anmh1205/AML_MicroMouse_2024/4. Document/20240807 Report Final.pptx

MICROMOUSE 2024

Applied Mechatronics Lab
07/08/2024

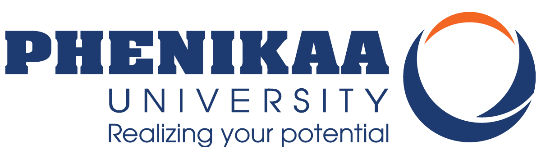
[picture p3: figure]

## Schedule

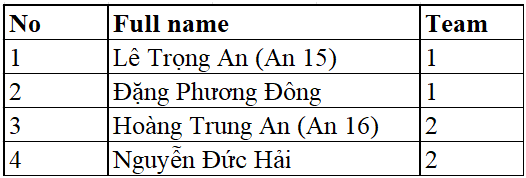
[picture p4: figure]

Notes: Therefore, my presentation includes 6 sections, followed by my research workflow. In Section 1, I present the background, challenges and objectives of my research. Section 2 is for my invented technique which mainly used. Section 3,4, and 5 provides more detail of the properties of three prototypes I have made. And Section 6 is the Conclusion and future work.

## TEAM 1

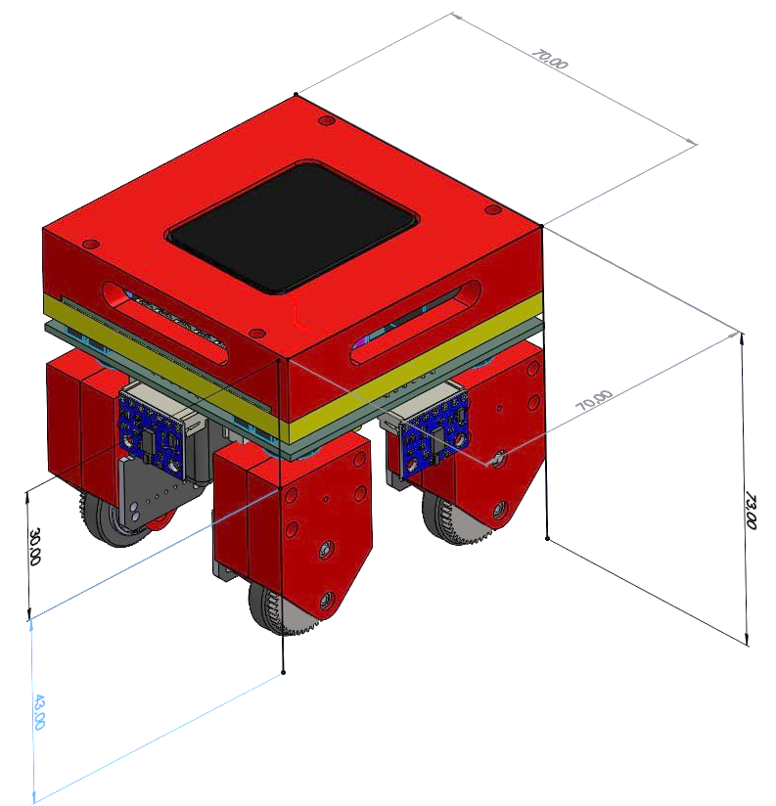
[picture p5: figure]
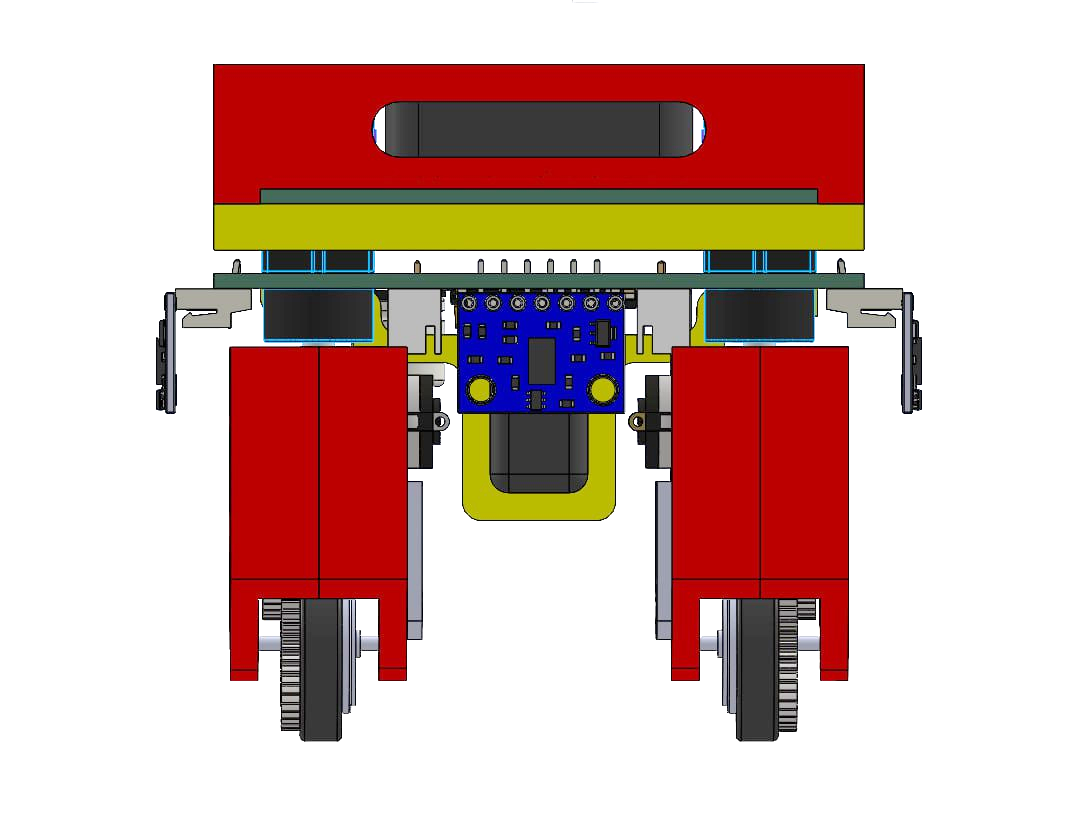
[picture p6: figure]
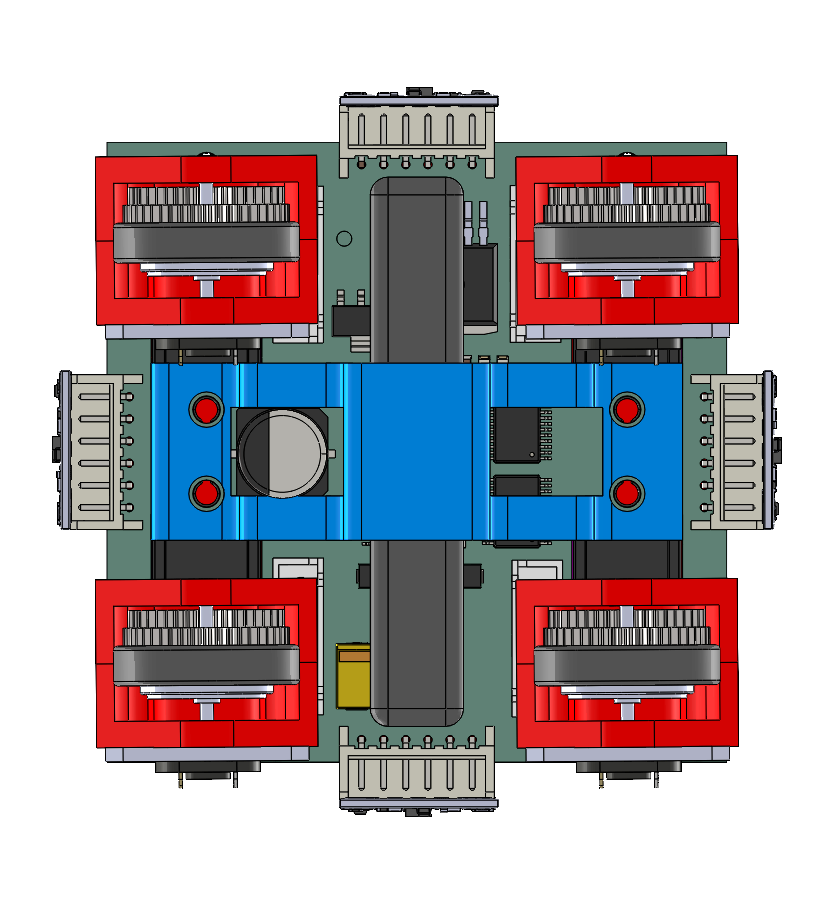
[picture p7: figure]

Notes: Therefore, my presentation includes 6 sections, followed by my research workflow. In Section 1, I present the background, challenges and objectives of my research. Section 2 is for my invented technique which mainly used. Section 3,4, and 5 provides more detail of the properties of three prototypes I have made. And Section 6 is the Conclusion and future work.

## TEAM 1

Màn hình ESP32

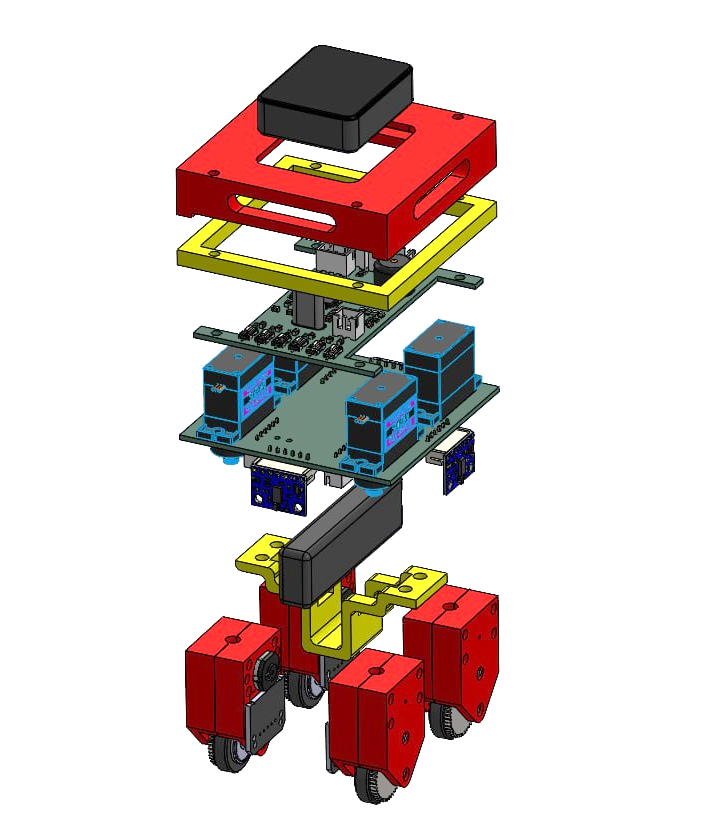
[picture p8: figure]

Case bảo vệ trên

Gá 2 mạch

Servo quay cụm bánh (SG90S) x4

PCB tầng dưới

Cảm biến laser
VL6180X x4

Gá pin

PCB tầng trên

Pin Lipo 2S

Cụm bánh x4

Notes: Therefore, my presentation includes 6 sections, followed by my research workflow. In Section 1, I present the background, challenges and objectives of my research. Section 2 is for my invented technique which mainly used. Section 3,4, and 5 provides more detail of the properties of three prototypes I have made. And Section 6 is the Conclusion and future work.

## TEAM 1

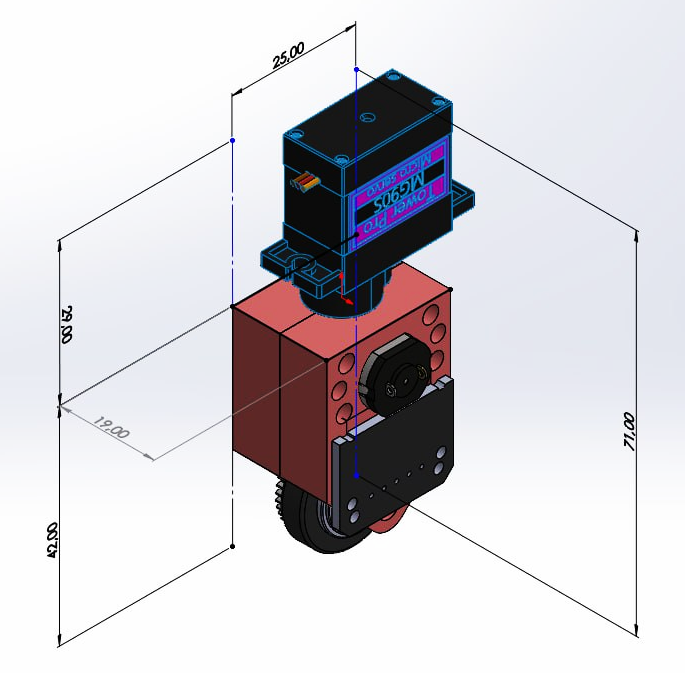
[picture p9: figure]

Notes: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

## TEAM 1

*CỤM BÁNH SỬ DỤNG BÁNH RĂNG 0.4M

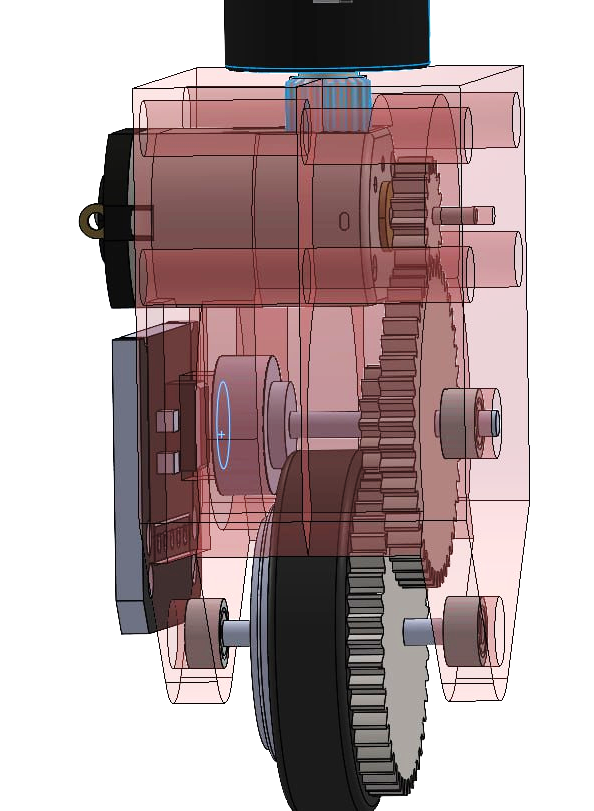
[picture p10: figure]

Bánh răng z1 = 15

Động cơ N20
10x8x15 (mm)
Trục 1mm dài 5mm

Encoder từ MT6701

Bánh răng z2 = 45

Nam châm cho encoder từ

Bánh răng z2’ = 15

Bánh răng z3 = 45

Tỉ số truyền: 1:9

Vòng bi 1.5x4x2 (mm) x3

Notes: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

## TEAM 2

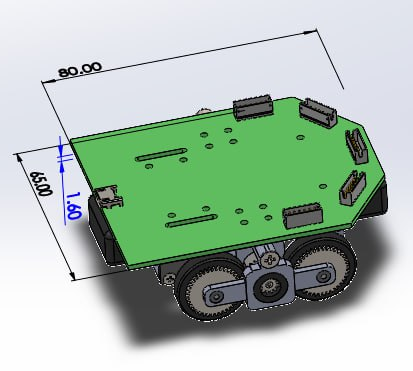
[picture p11: figure]
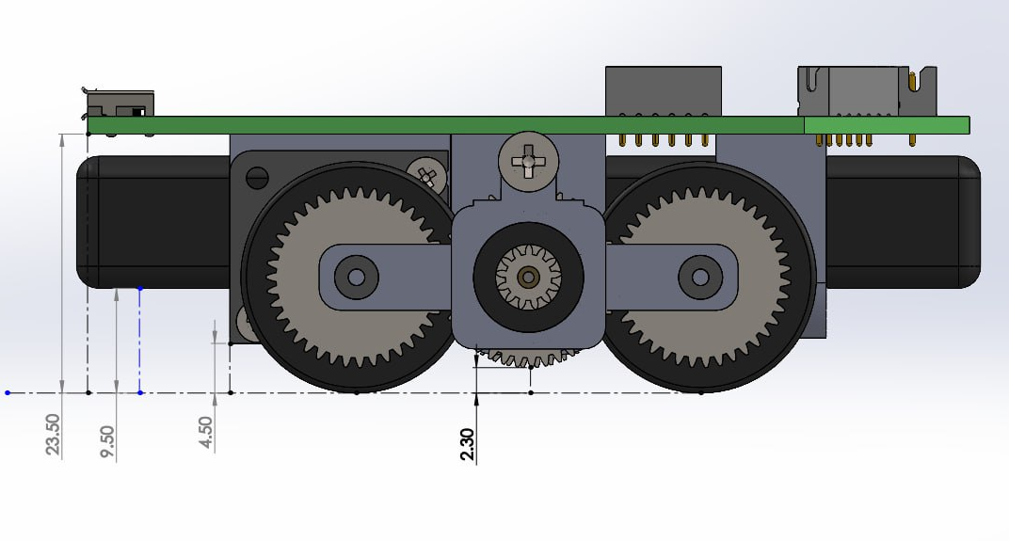
[picture p12: figure]

Notes: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

## TEAM 2

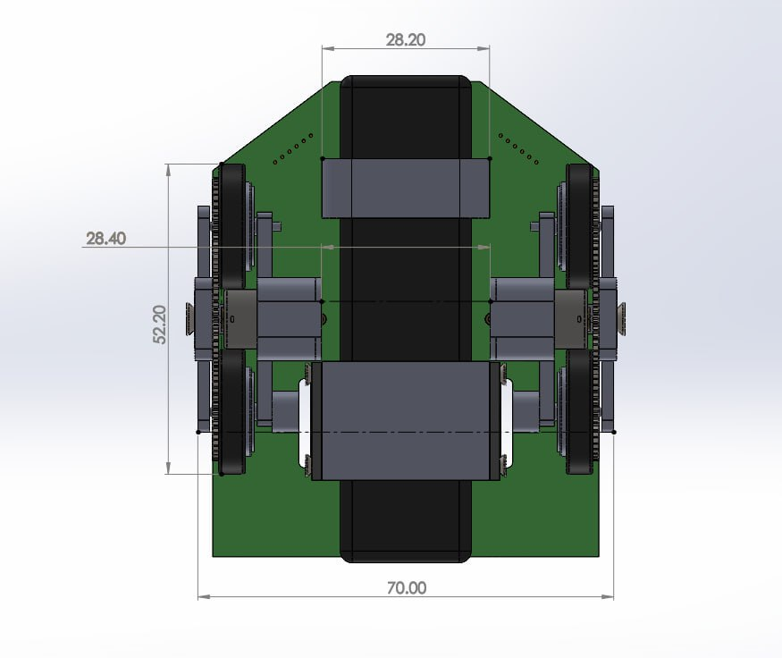
[picture p13: figure]

Notes: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

## TEAM 2

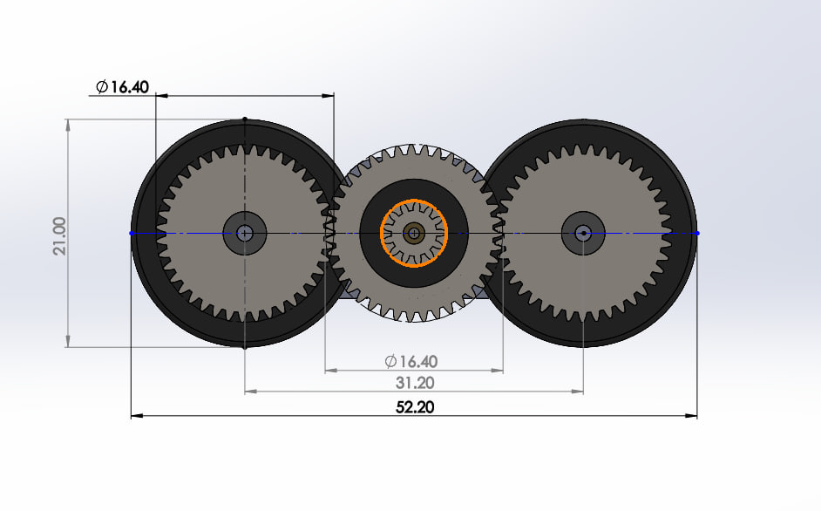
[picture p14: figure]

Notes: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

## TEAM 2

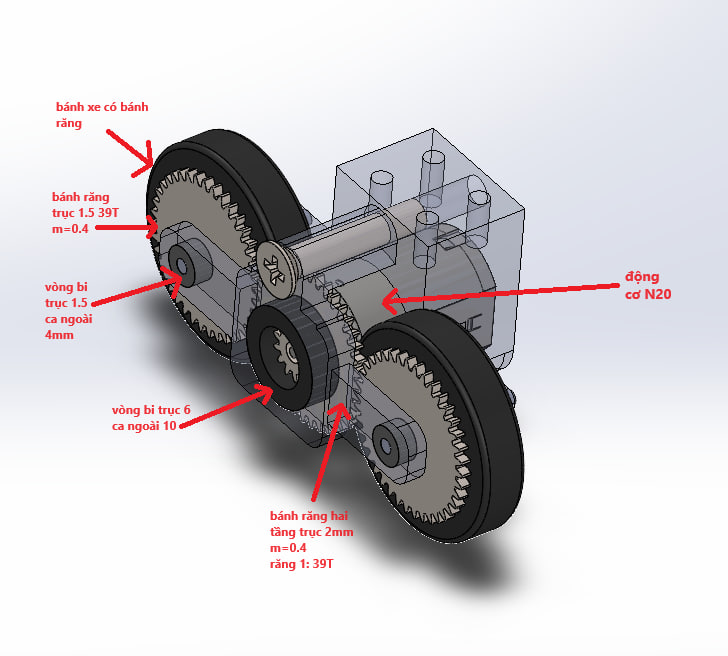
[picture p15: figure]

Notes: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

## Slide 11

THANK YOU

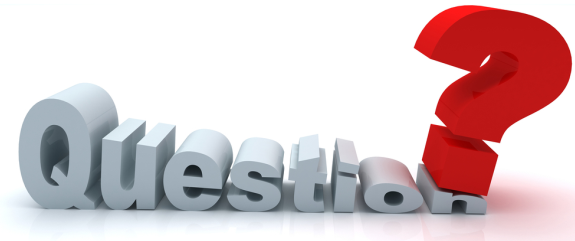
[picture p16: figure]
