anmh1205/AML_MicroMouse_2024/0. Example/3. ST-Link 2.1-2/2D and 3D files/ST-Link V2-1_2.4_Bottom.png

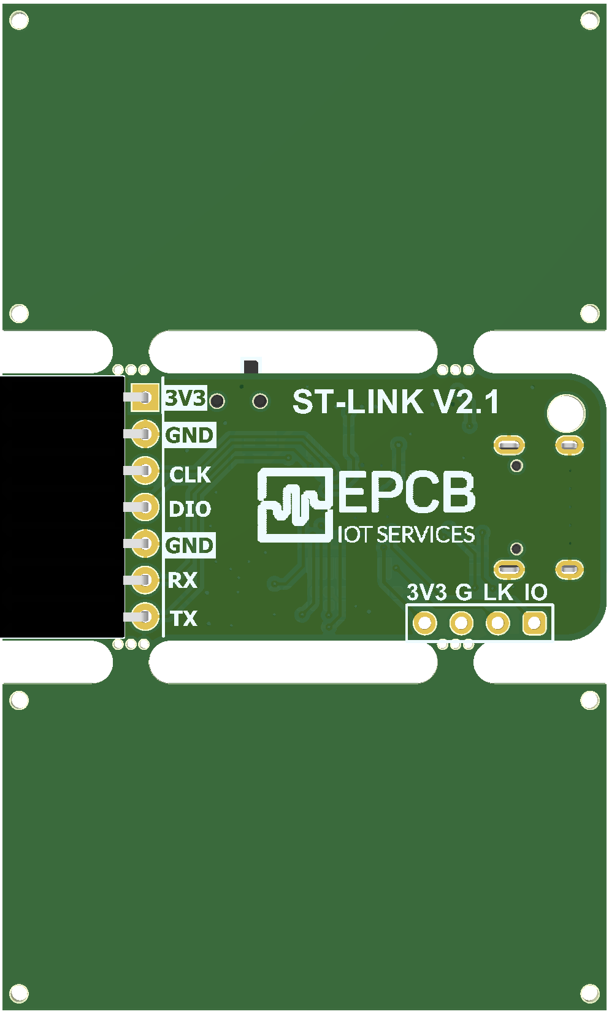
0. Example/3. ST-Link 2.1-2/2D and 3D files/ST-Link V2-1_2.4_Bottom.png
