anmh1205/AML_MicroMouse_2024/2. MicroMouse PCB/PCB_AIO_V2/PCB_AIO_V2_Back.png

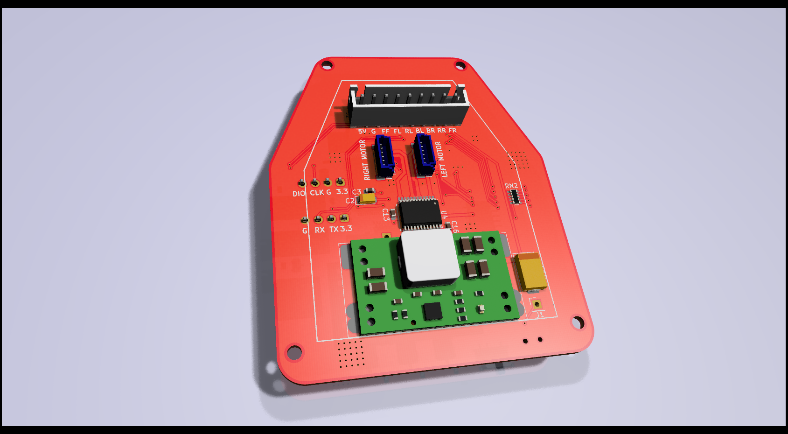
2. MicroMouse PCB/PCB_AIO_V2/PCB_AIO_V2_Back.png
