anmh1205/AML_MicroMouse_2024/0. Example/3. ST-Link 2.1-2/Manufacturing/Bill of Materials-ST-Link V2-1_2.4.xlsx

ST-Link V2-1_2.4.PrjPcb
# | Comment | Designator | Footprint | LCSC Part Number | Manufacturer Part Number | Manufacturer | Quantity | Description | Assembly Type | Link
1 | 4.7uF | C2, C5 | C_0603 | C19666 | CL10A475KO8NNNC | Samsung Electro-Mechanics | 2 | 4.7UF 16V 0603 ROHS | SMT Assembly
2 | 22pF | C6, C13 | C_0402 | C1555 | 0402CG220J500NT | FH(Guangdong Fenghua Advanced Tech) | 2 | 22pF 50V C0G ±5% 0402 Multilayer Ceramic Capacitors MLCC - SMD/SMT ROHS | SMT Assembly
3 | 100nF | C7, C8, C9, C10, C14 | C_0402 | C41851 | 0402B104K160NT | FH(Guangdong Fenghua Advanced Tech) | 5 | 100nF 16V X7R ±10% 0402 Multilayer Ceramic Capacitors MLCC - SMD/SMT ROH | SMT Assembly
4 | FC-DA1608HRK-620D | D1, D2, D3 | LED0603-RD_RED | C84263 | FC-DA1608HRK-620D | NATIONSTAR | 3 | LED Red 0603 Light Emitting Diodes (LED) ROHS | SMT Assembly
5 | BSMD0603L-150 | F1 | F0603 | C914094 | BSMD0603L-150 | BHFUSE | 1 | 6V 1.5A 50A 1W -40℃~+85℃ 3A 5mΩ 500ms 55mΩ 0603 | SMT Assembly
6 | BSMD0603-050-6V | F2 | F0603 | C883095 | BSMD0603-050-6V | BHFUSE | 1 | 6V 500mA 40A 500mW -40℃~+85℃ 1A 100mΩ 100ms 800mΩ 0603 Resettable Fuses ROHS | SMT Assembly
7 | TYPE-C 16PIN 2MD(073) | J2 | USB-C-SMD_TYPE-C-6PIN-2MD-073 | C2765186 | TYPE-C 16PIN 2MD(073) | SHOU HAN(首韩) | 1 | 5A 1 Surface Mount 16 Female -25℃~+85℃ Type-C SMD USB Connectors ROHS | SMT Assembly
8 | HDR1x7 | JP1 | HDR1X7H |  | HDR1x7 Horizonal |  | 1 | Header IDC, 1x8 Pin horizontal 2.54mm Pitch (Non-Boxed, Male) | Hand Soldering
9 | PM254-1-07-W-8.5 | JP2 | HDR-TH_7P-P2.54-H-F-W10.0-N | C2897389 | PM254-1-07-W-8.5 | HCTL(华灿天禄) | 1 | 2.54mm 单排 3A -40℃~+105℃ Shrouded 1x7P side 8.5mm 7 Square Holes Push-Pull,P=2.54mm Female Headers ROHS | Hand Sodering
10 | ME6211C33M5G-N | LDO1 | SOT-23-5_L3.0-W1.7-P0.95-LS2.8-BR | C82942 | ME6211C33M5G-N | MICRONE | 1 | ME6211C33M5G-N 500mA 70dB@(1kHz),62dB@(10kHz) 260mV@(200mA) Fixed 3.3V~3.3V Positive 1 6V SOT-23-5 Linear Voltage Regulators (LDO) ROHS | SMT Assembly
11 | MMBT3904 | Q1 | SOT-23-3_L2.9-W1.3-P1.90-LS2.4-BR | C20526 | MMBT3904 | Changjiang Electronics Tech (CJ) | 1 | MMBT3904 TRANSISTORS (NPN/PNP) NPN 200MA 40V SOT-23(SOT-23-3) ROHS | SMT Assembly
12 | 10K | R1, R7, R8, R9, R10 | R_0402 | C25744 | 0402WGF1002TCE | Uniroyal Elec | 5 | 10kΩ 0402 62.5mW Thick Film Resistors 50V ±100ppm/℃ ±1% -55℃~+155℃ | SMT Assembly
13 | 100R | R2, R14 | R_0402 | C304566, C328297 | RC-02W1000FT, AECR0402F100RK9 | FH (Guangdong Fenghua Advanced Tech), Resistor.Today | 2 | 100Ω 0402 62.5mW ±1% Chip Resistor - Surface Mount ROHS, 100ohm 100Ω 0402 Chip Resistor - Surface Mount ROHS | SMT Assembly
14 | 36K | R3 | R_0402 | C517690 | TC0250B3602TCC | Uniroyal Elec | 1 | 36kΩ 0402 62.5mW Thick Film Resistors 50V ±100ppm/℃ ±1% -55℃~+155℃ | SMT Assembly
15 | 1.5K | R4, R6, R15, R25 | R_0402 | C25867 | 0402WGF1501TCE | Uniroyal Elec | 4 | 1.5kΩ 0402 62.5mW Thick Film Resistors 50V ±100ppm/℃ ±1% -55℃~+155℃ | SMT Assembly
16 | 4.7K | R11, R12, R13 | R_0402 | C25900 | 0402WGF4701TCE | Uniroyal Elec | 3 | 4.7KOHMS ±1% 1/16W 0402 ROHS | SMT Assembly
17 | 5.1k | R23, R24 | R_0402 | C25941 | 0402WGJ0512TCE | Uniroyal Elec | 2 | 5.1KOHMS ±5% 1/16W 0402 ROHS | SMT Assembly
18 | MK-12C02-G020 | S1 | SW-SMD_MK-12C02-G020 | C963206 | MK-12C02-G020 | G-Switch | 1 | Surface Mount 1A SPDT 6V Black 10000次 SMD Slide Switches ROHS | SMT Assembly
19 | STM32F103CBT6 | U1 | LQFP-48_L7.0-W7.0-P0.50-LS9.0-BL | C8304 | STM32F103CBT6 | STMicroelectronics | 1 | STM32 ARM-based 32-bit MCU with 64 Kbytes Flash, 48-pin LQFP, Industrial Temperature | SMT Assembly
20 | 8Mhz | X1 | SMD-3225_4P | C133366 | 1C208000CE0Q | KDS Daishinku | 1 | 8Mhz 3225 SMD CRYSTAL RESONATORS 8MHZ SMD-3225-4P ROHS | SMT Assembly
