anmh1205/AML_MicroMouse_2024/0. Example/WolfieMouse-RTOS/hardware/kicad_wolfiemouse/BOM.xlsx

 | Reference | # | Value | Manufacturer | Manufacturer # | Digi-key part # | Discription | Cost | ext. Cost | Footprint | Datasheet
1 | U1 | 1 | STM32F446RE_LQFP64 | STMicroelectronics | STM32F446RET6 | 497-15376-ND |  | 9.71 | 9.71 | footprints_micromouse:STM32F446_LQFP64
2 | LED_RED1, D_PWR1 | 2 | Led_Small | Vishay Semiconductor Opto Division | VLMS1300-GS08 | VLMS1300-GS08CT-ND |  | 0.43 | 0.86 | LEDs:LED_0603
3 | LED_GREEN1 | 1 | Led_Small | Vishay Semiconductor Opto Division | VLMTG1300-GS08 | VLMTG1300-GS08CT-ND |  | 0.43 | 0.43 | LEDs:LED_0603
4 | LED_BLUE1, D1 | 2 | Led_Small | Vishay Semiconductor Opto Division | VLMB1300-GS08 | VLMB1300-GS08CT-ND |  | 0.43 | 0.86 | LEDs:LED_0603
5 | LED_WHITE1 | 1 | Led_Small | Vishay Semiconductor Opto Division | VLMW1300-GS08 | VLMW1300-GS08CT-ND |  | 0.43 | 0.43 | LEDs:LED_0603
6 | C_IMU2 | 1 | 10nF | Yageo | CC0805KRX7R9BB103 | 311-1136-1-ND | CAP CER 10000PF 50V X7R 0805 | 0.1 | 0.1 | Capacitors_SMD:C_0805
7 | C_VBAT2, C_5V2, CNR1, C_3.3V2, C_RESET1, C_V1, C_V2, C_V3, C_V4, C_V5, C_V6, C_RANGE1, C_DIS1, C_IMU1, C_IMU3 | 15 | 0.1uF | Vishay Vitramon | VJ0603Y104KXXAC | 720-1378-1-ND | CAP CER 0.1UF 25V X7R 0603 | 0.34 | 5.1 | Capacitors_SMD:C_0603
8 | C_MOTOR1, C_MOTOR2 | 2 | 1uF | Yageo | CC0603KRX5R8BB105 | 311-1445-1-ND | CAP CER 1UF 25V X5R 0603 | 0.1 | 0.2 | Capacitors_SMD:C_0603
9 | C_VCAP1, C_VCAP2 | 2 | 2.2uF | Yageo | CC1206KKX7R7BB225 | 311-1957-1-ND | CAP CER 2.2UF 16V X7R 1206 | 0.21 | 0.42 | Capacitors_SMD:C_1206
10 | C_3.3V1, C_DIS2, C_uSD1 | 3 | 10uF | Yageo | CC1206ZKY5V7BB106 | 311-1376-1-ND | CAP CER 10UF 16V Y5V 1206 | 0.22 | 0.66 | Capacitors_SMD:C_1206
11 | C_VBAT1, C_5V1 | 2 | 100uF | Yageo | CC1210MKX5R7BB107 | 311-2052-1-ND | CAP CER 100UF 16V X5R 1210 | 1.92 | 3.84 | Capacitors_SMD:C_1210
12 | C_M1 | 1 | 220uF | Vishay Sprague | TR3D227K010C0150 | 718-1777-1-ND | CAP TANT 220UF 10V 10% 2917 | 1.31 | 1.31 | Capacitors_Tantalum_SMD:TantalC_SizeD_EIA-7343_HandSoldering
13 | R13, R14 | 2 | 62.5m | Vishay Dale | WSL1206R0600FEA | WSLC-.06CT-ND | RES SMD 0.06 OHM 1% 1/4W 1206 | 0.92 | 1.84 | Resistors_SMD:R_0603
14 | R1, R2, R3, R4, R_PWR1, R_uSD1 | 6 | 1k | Vishay Dale | CRCW06031K00FKEA | 541-1.00KHCT-ND | RES SMD 1K OHM 1% 1/10W 0603 | 0.081 | 0.486 | Resistors_SMD:R_0603
15 | R_BOOT1, R_VOL2, R_MOTOR1, R_MOTOR2, R_RANGE1, R_RANGE2, R_RANGE3, R_RANGE4, R_RANGE5, R_RANGE6, R_RANGE7, R_IMU1, R_IMU2 | 13 | 10k | Vishay Dale | CRCW060310K0FKEA | 541-10.0KHCT-ND | RES SMD 10K OHM 1% 1/10W 0603 | 0.081 | 1.053 | Resistors_SMD:R_0603
16 | R_VOL1 | 1 | 20k | Vishay Dale | CRCW060320K0JNEA | 541-20KGCT-ND | RES SMD 20K OHM 5% 1/10W 0603 | 0.1 | 0.1 | Resistors_SMD:R_0603
17 | R_PB2, R_PB1 | 2 | 47k | Vishay Dale | CRCW060347K0JNEA | 541-47KGCT-ND | RES SMD 47K OHM 5% 1/10W 0603 | 0.1 | 0.2 | Resistors_SMD:R_0603
18 | L_BEAD1 | 1 | 10uH | Murata Electronics North America | BLM18KG601SN1D | 490-5258-1-ND | FERRITE BEAD 600 OHM 0603 1LN | 0.1 | 0.1 | Resistors_SMD:R_0603
19 | M3 | 1 | 2.54MM-SLIDE-SWITCH_TS02_SWITCH |  |  |  |  |  | 0 | pcb1:2.54MM-SLIDE-SWITCH_TS02_SWITCH
20 | U11 | 1 | TPS76850 | Texas Instruments | TPS76850QD | 296-2751-5-ND | IC REG LDO 5V 1A 8SOIC | 2.98 | 2.98 | footprints_micromouse:TPS76850_SOIC-8
21 | U12 | 1 | TPS73633 | Texas Instruments | TPS73633DBVR | 296-27064-1-ND | IC REG LDO 3.3V 0.4A SOT23-5 | 2.05 | 2.05 | footprints_micromouse:TPS73633_SOT-23
22 | SW1, SW2, SW3 | 3 | SWITCH_DPST | C&K Components | PTS645SL50SMTR92 LFS | CKN9088CT-ND | SWITCH TACTILE SPST-NO 0.05A 12V | 0.29 | 0.87 | Buttons_Switches_SMD:SW_SPST_PTS645
23 | CN1, CN2 | 2 | 5_PIN_HEADER |  |  |  |  |  | 0 | Pin_Headers:Pin_Header_Straight_1x05
24 | P1, P2 | 2 | B3B-PH-SM4-TB | JST Sales America Inc. | B3B-PH-K-S(LF)(SN) | 455-1705-ND | CONN HEADER PH TOP 3POS 2MM | 0.19 | 0.38 | footprints_micromouse:JST_B3B-PH_HEADER
25 | U2, U3 | 2 | MAX14871 | Maxim Integrated | MAX14871EUE+T | MAX14871EUE+CT-ND | IC MOTOR DVR DC FULL BR 16TSSOP | 4.03 | 8.06 | footprints_micromouse:TSSOP-16_EP
26 | M1 | 1 | MOTOR_MOUNTS_AND_ENCODERS |  |  |  |  |  | 0 | footprints_micromouse:FUTURA-1.0-MOTOR-MOUNT-TEMPLATE
27 | U5, U6, U7, U8 | 4 | VL6180X_POLOLU |  |  |  |  |  | 0 | footprints_micromouse:VL6180X_POLOLU_Pin_Header_Straight_1x07
28 | U4 | 1 | TCA9545A | Texas Instruments | TCA9545APWR | 296-40577-1-ND | IC I2C SW 4CH W/RESET 20TSSOP |  | 0 | Housings_SSOP:TSSOP-20_4.4x6.5mm_Pitch0.65mm
29 | U9 | 1 | HCMS-2901 | Avago (Broadcom company) | HCMS-2901 | 516-2964-ND | LED DISPLAY 5X7 4CHAR 3.8MM YLW | 22.92 | 22.92 | footprints_micromouse:HCMS-2903
30 | U10 | 1 | MPU-9250 | InvenSense | MPU-9250 | 1428-1019-1-ND | GYRO/ACCEL/COMPASS/9-AXIS | 10.64 | 10.64 | footprints_micromouse:MPU-9250
31 | J1 | 1 | uSD_SLOT_47219-2001 | Molex, LLC | 5009010801 | WM19081CT-ND | CONN MICRO SD CARD HINGED TYPE |  | 0 | footprints_micromouse:uSD_MOLEX_47219-2001
 |  |  |  |  |  |  |  |  | 75.599
