anmh1205/AML_MicroMouse_2024/3. Drawing/Ver3_07082024/Cum banh _V3.SLDASM

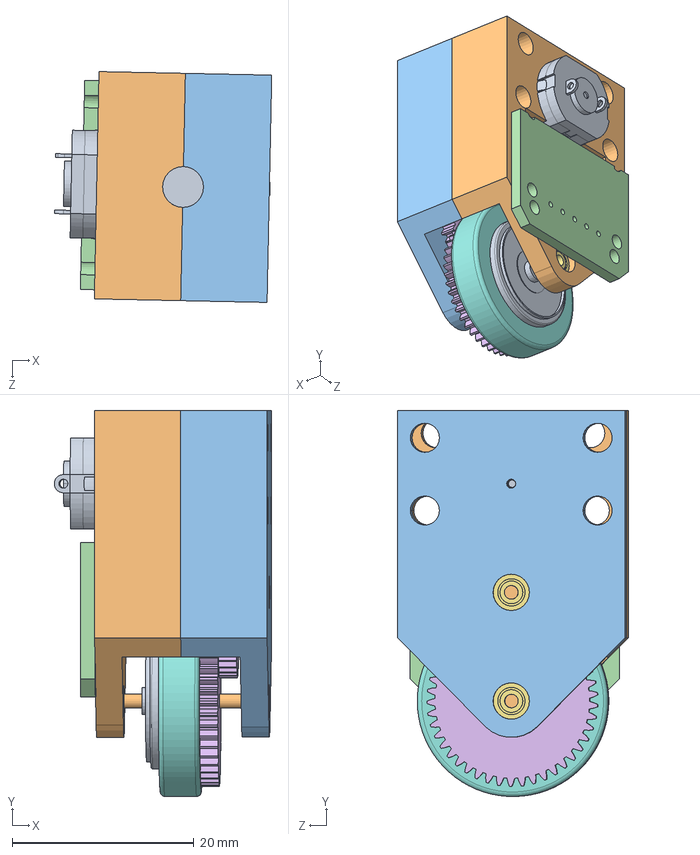
[picture p33: CAD file, 2024-08-10]
3. Drawing/Ver3_07082024/Cum banh _V3.SLDASM
23.9 x 42.4 x 25.4 mm
N20 DC MOTOR Truc dai
Vo SD2_V3
Nam cham
Spur gear 0.4M 15T 1.0N
Spur gear 0.4M 15T 1.5N
Spur gear 0.4M 45T 1.5N x 2
Vong bi 2x5x2.5 x 3
Lop banh xe
Mam banh xe
Truc 2x20 x 2
Vo SD1_V3
MT6701
Ga nam chamV3
