anmh1205/AML_MicroMouse_2024/3. Drawing/Ver3_07082024/Banh rang T45-T15.SLDASM

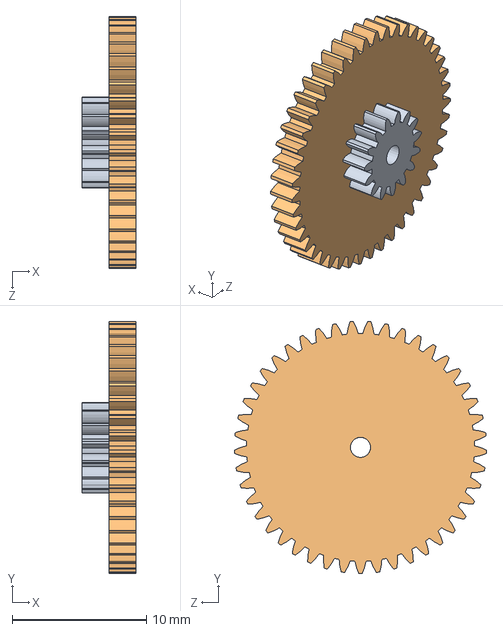
[picture p34: CAD file, 2024-08-10]
3. Drawing/Ver3_07082024/Banh rang T45-T15.SLDASM
4.00 x 18.8 x 18.8 mm
Spur gear 0.4M 15T 1.5N
Spur gear 0.4M 45T 1.5N
