anmh1205/AML_MicroMouse_2024/3. Drawing/v8/Assem1.SLDASM

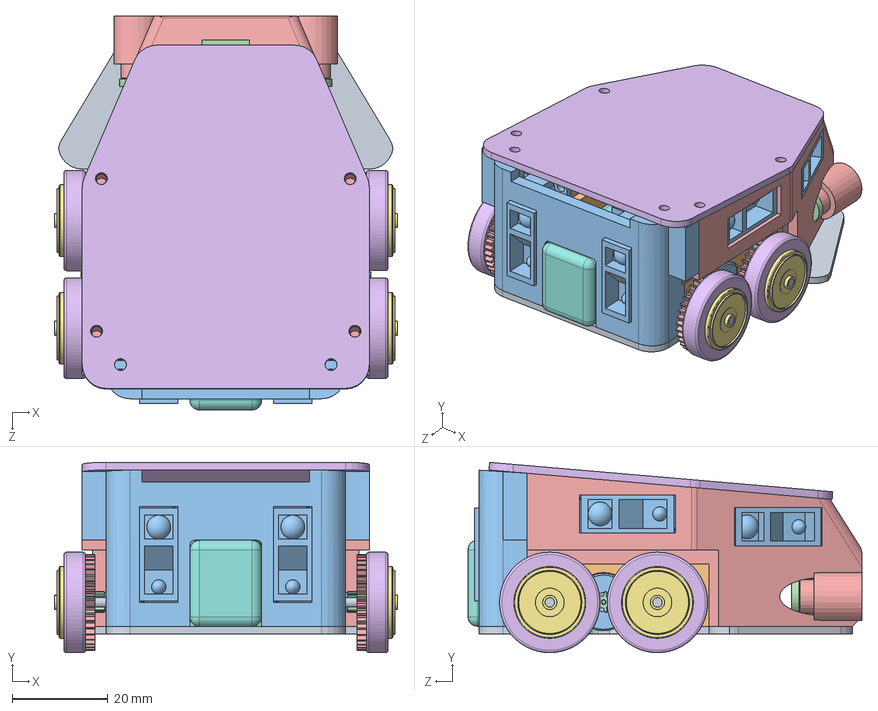
[picture p35: CAD file, 2024-11-05]
3. Drawing/v8/Assem1.SLDASM
71.7 x 39.8 x 82.3 mm
PCB
Ga DC2
N20 DC MOTOR Truc dai x 2
gearT7 x 2
Spur gear 0.5M 38T x 4
Lop banh xe x 4
Mam banh xe x 4
Pin
Truc 2x20 x 4
MT6701 x 2
SHARP GP2Y0A51SK0F x 6
GP2Y0A41SK0F
Ga sensor 1
PCB2
Vong bi 2x5x2.5 x 8
Ga nam chamV3 x 2
Nam cham x 2
Ga DC
Ga sensor sau
Kep truc x 2
