anmh1205/AML_MicroMouse_2024/3. Drawing/Micromouse/Cum Banh.SLDASM

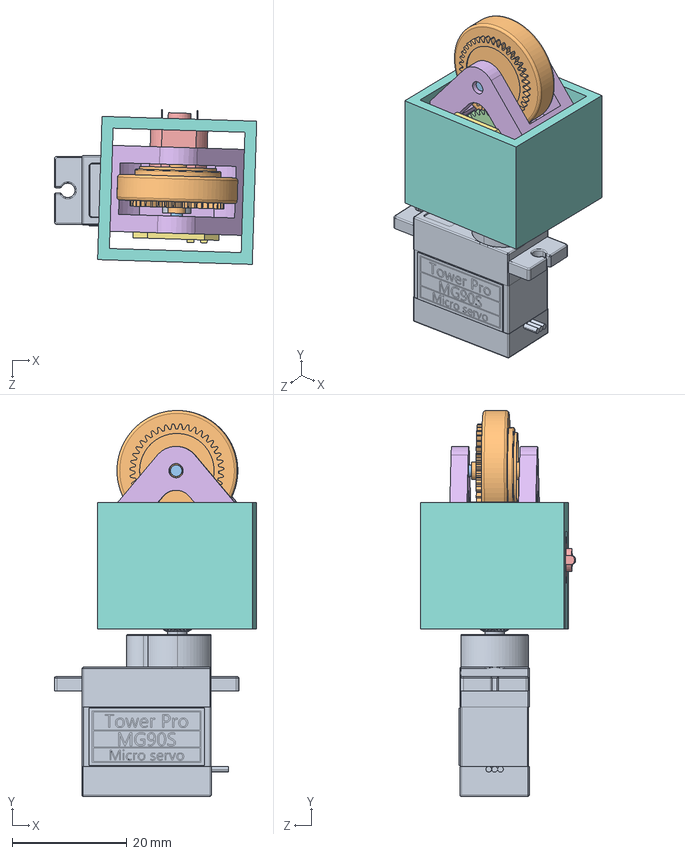
[picture p36: CAD file, 2024-08-10]
3. Drawing/Micromouse/Cum Banh.SLDASM
35.3 x 67.3 x 27.0 mm
Tower Pro MG90S Micro servo.step
Banh xe
Truc 2x14
Banh rang doi
Dong co
Ga cum banh
Encoder
Nam cham
