anmh1205/AML_MicroMouse_2024/0. Example/piccola-master/DXF/base1.SLDPRT

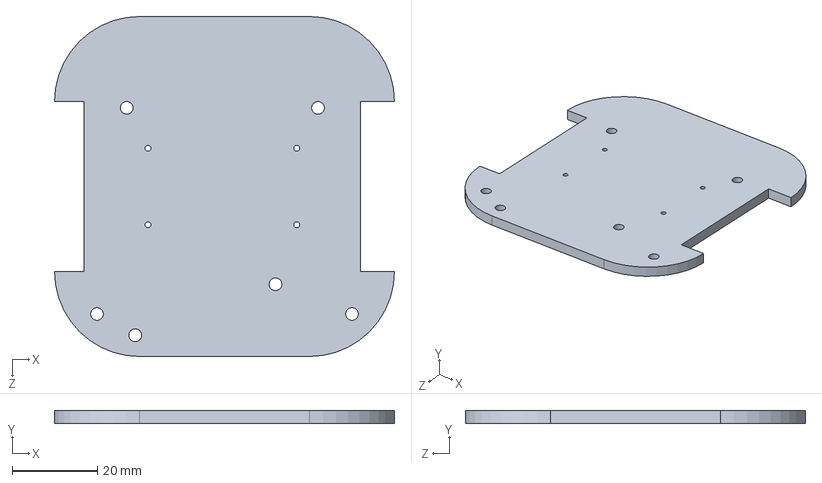
[picture p37: CAD file, 2024-08-29]
0. Example/piccola-master/DXF/base1.SLDPRT
80.0 x 3.00 x 80.0 mm
