anmh1205/AML_MicroMouse_2024/0. Example/WolfieMouse-RTOS/hardware/kicad_wolfiemouse/3D_Model/motor seat.STL

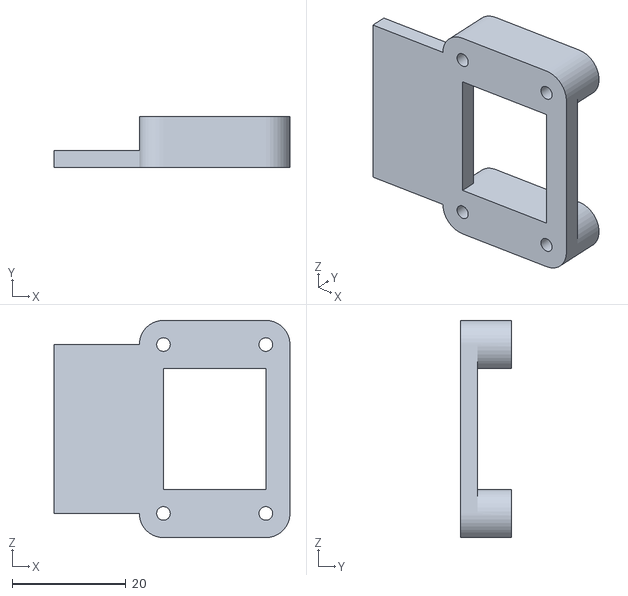
[picture p38: CAD file, 2024-08-10]
0. Example/WolfieMouse-RTOS/hardware/kicad_wolfiemouse/3D_Model/motor seat.STL
41.5 x 9.00 x 38.2
