anmh1205/AML_MicroMouse_2024/2. MicroMouse PCB/Outline/MicroMouse2023_T1.DXF

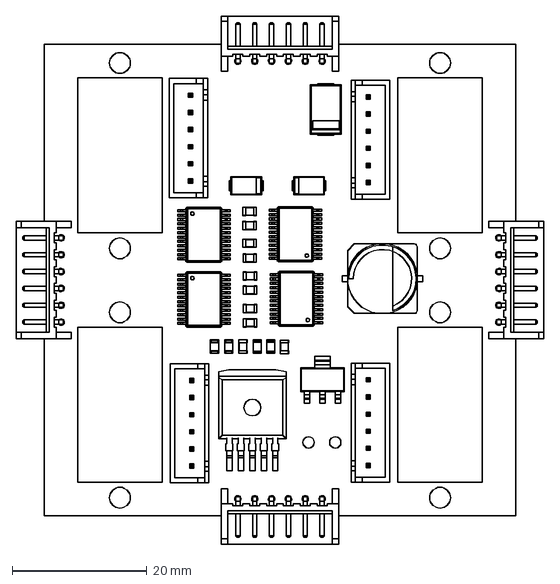
[picture p39: CAD file, 2024-08-10]
2. MicroMouse PCB/Outline/MicroMouse2023_T1.DXF
78.3 x 78.3 mm
