anmh1205/AML_MicroMouse_2024/2. MicroMouse PCB/PCB_AIO_V2/3D Model/BM06B-SRSS-TB.STEP

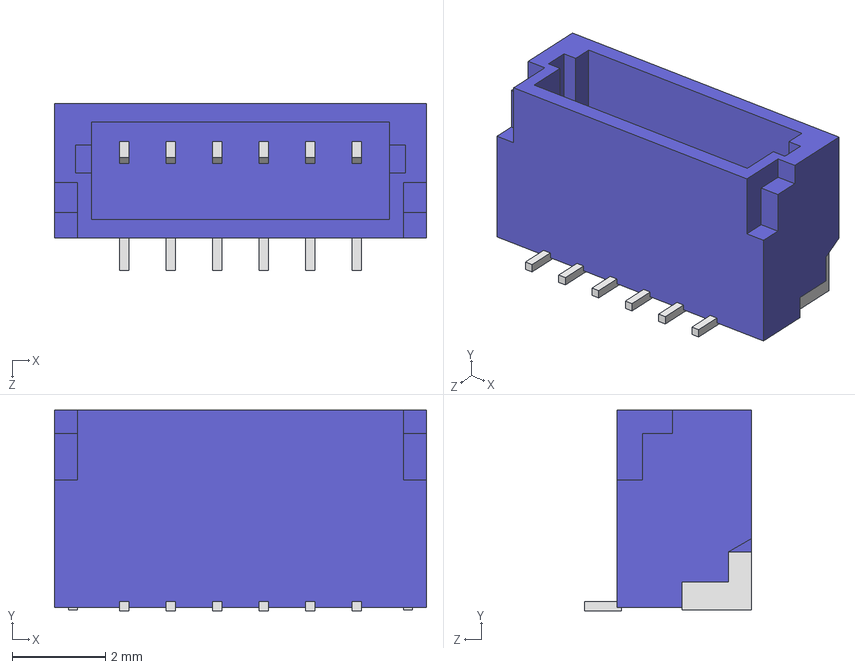
[picture p40: CAD file, 2024-11-05]
2. MicroMouse PCB/PCB_AIO_V2/3D Model/BM06B-SRSS-TB.STEP
8.00 x 4.32 x 3.60 mm
