anmh1205/AML_MicroMouse_2024/2. MicroMouse PCB/PCB_AIO_V2/Outline/PCB_Outline.DXF

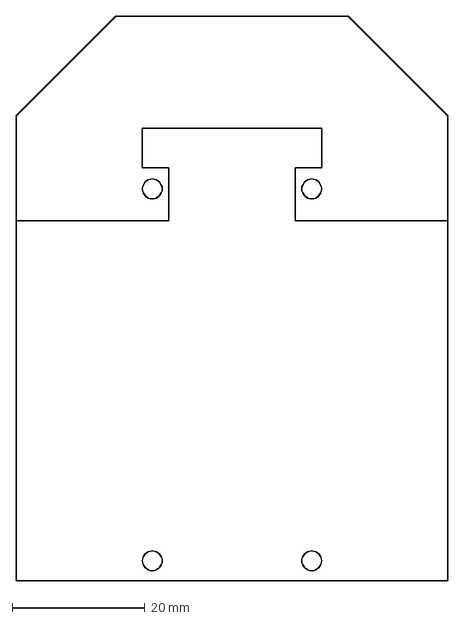
[picture p41: CAD file, 2024-11-05]
2. MicroMouse PCB/PCB_AIO_V2/Outline/PCB_Outline.DXF
65.0 x 85.0 mm
