anmh1205/AML_MicroMouse_2024/2. MicroMouse PCB/V1/PCB_T2/Outline/PCB T1.2.DXF

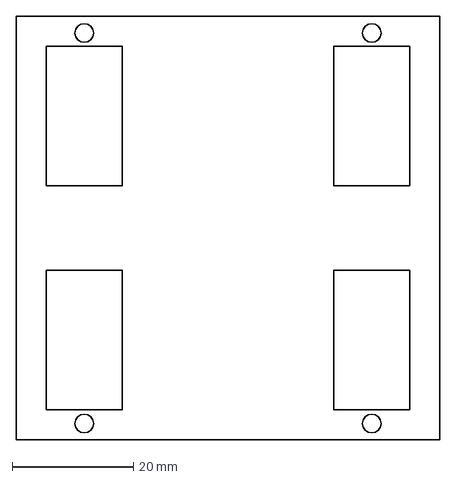
[picture p42: CAD file, 2024-08-10]
2. MicroMouse PCB/V1/PCB_T2/Outline/PCB T1.2.DXF
70.0 x 70.0 mm
