anmh1205/AML_MicroMouse_2024/3. Drawing/Micromouse/Bánh răng/Banh rang doi.SLDPRT

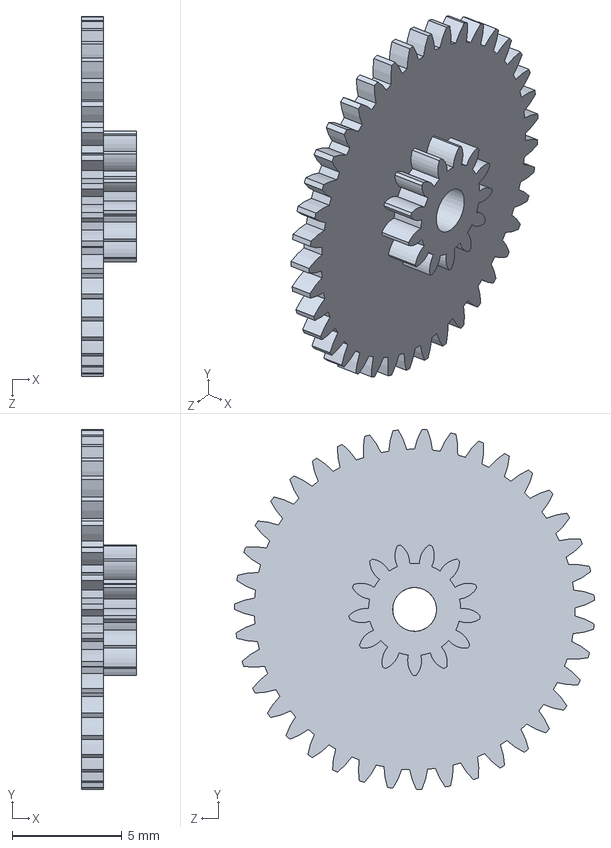
[picture p43: CAD file, 2024-08-10]
3. Drawing/Micromouse/Bánh răng/Banh rang doi.SLDPRT
2.50 x 16.4 x 16.4 mm
