anmh1205/AML_MicroMouse_2024/3. Drawing/Micromouse/Bánh xe/Banh xe.SLDPRT

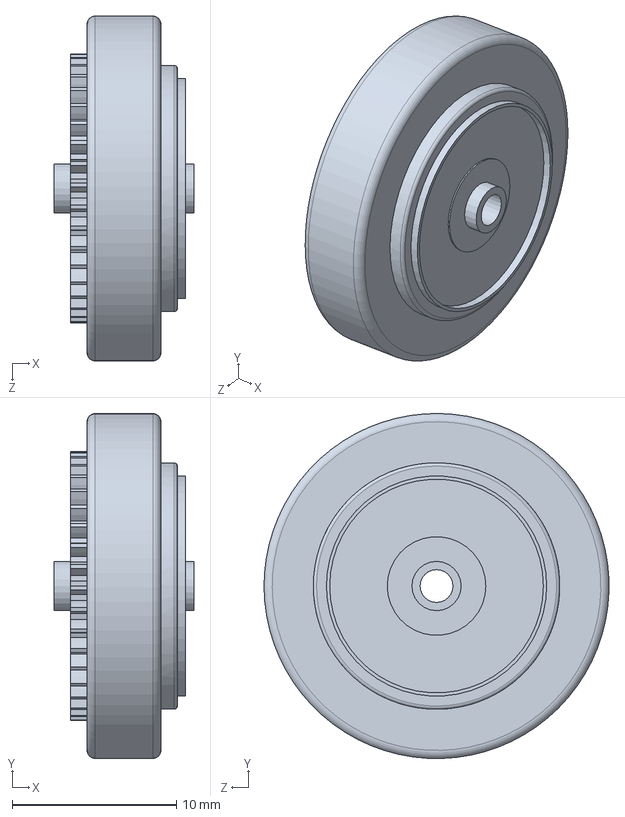
[picture p44: CAD file, 2024-08-10]
3. Drawing/Micromouse/Bánh xe/Banh xe.SLDPRT
8.50 x 21.0 x 21.0 mm
