anmh1205/AML_MicroMouse_2024/3. Drawing/Micromouse/Dong co.SLDPRT

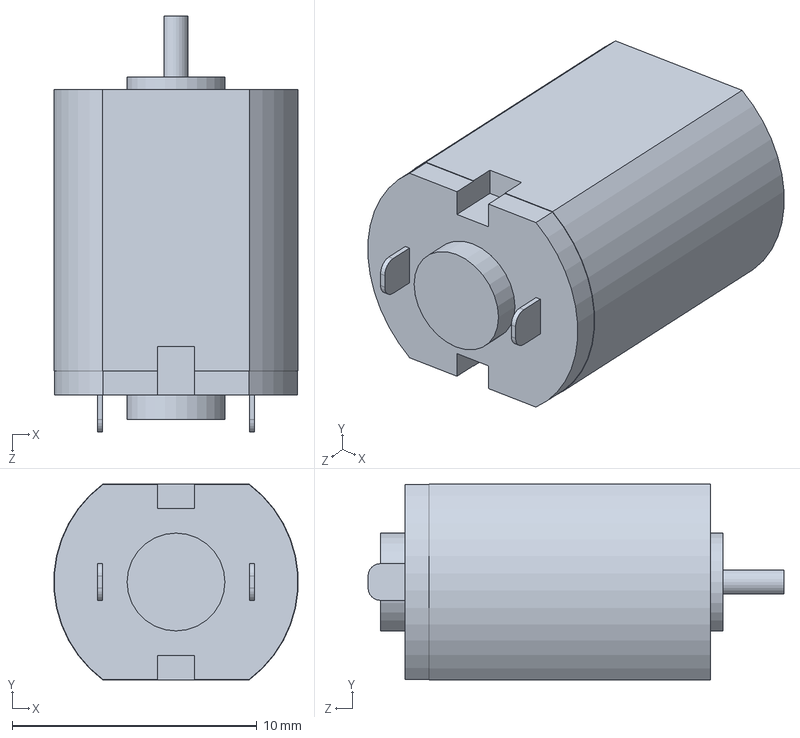
[picture p45: CAD file, 2024-08-10]
3. Drawing/Micromouse/Dong co.SLDPRT
9.97 x 8.00 x 17.0 mm
