anmh1205/AML_MicroMouse_2024/3. Drawing/v8/Ga sensor sau.SLDPRT

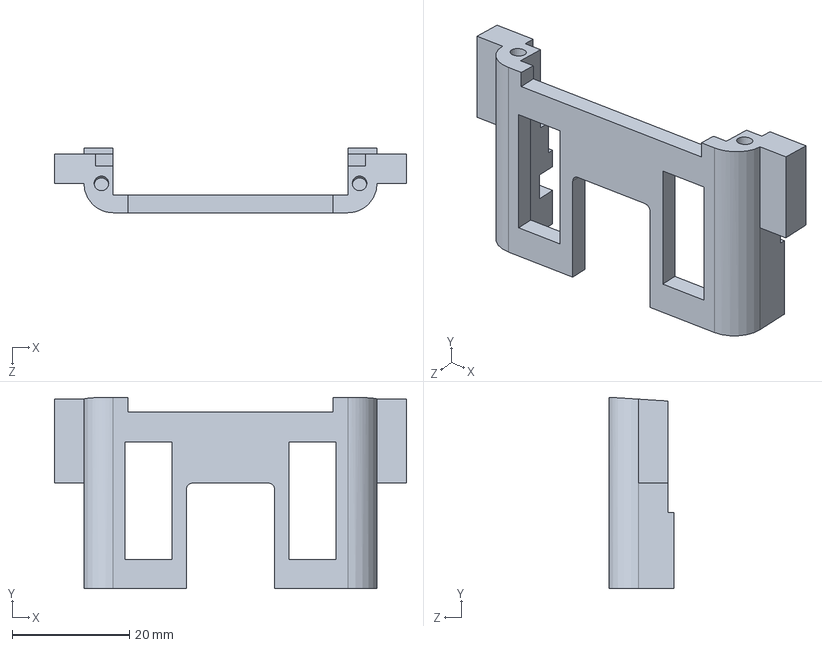
[picture p46: CAD file, 2024-11-05]
3. Drawing/v8/Ga sensor sau.SLDPRT
60.0 x 32.6 x 11.0 mm
