anmh1205/AML_MicroMouse_2024/3. Drawing/Ver3_07082024/Spur gear 0.4M 45T 1.5N.SLDPRT

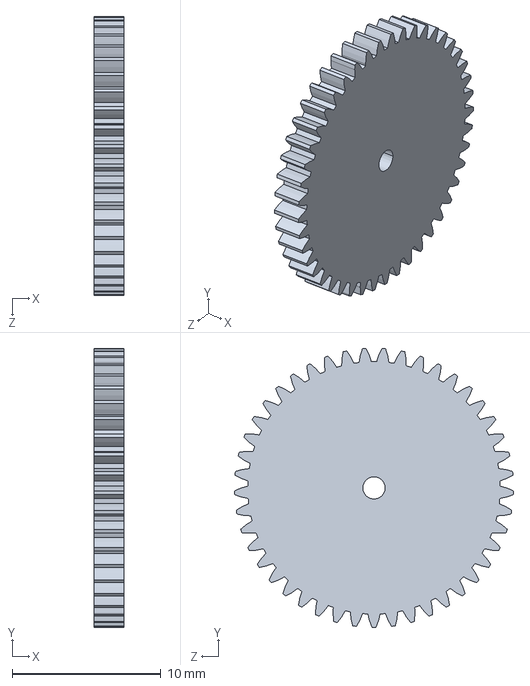
[picture p47: CAD file, 2024-08-10]
3. Drawing/Ver3_07082024/Spur gear 0.4M 45T 1.5N.SLDPRT
2.00 x 18.8 x 18.8 mm
