anmh1205/AML_MicroMouse_2024/0. Example/piccola-master/DXF/base3.SLDPRT

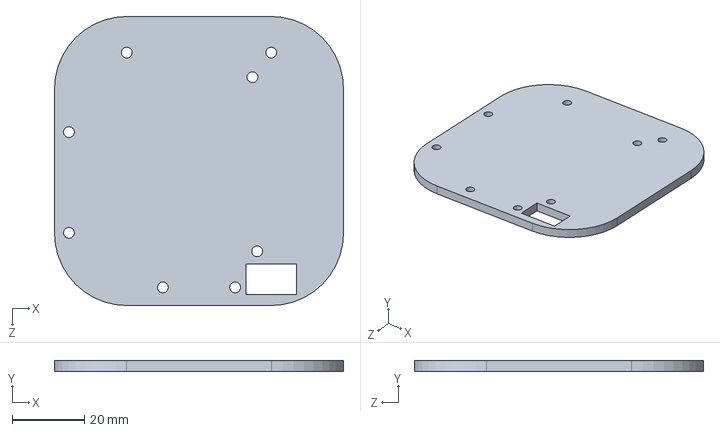
[picture p48: CAD file, 2024-08-29]
0. Example/piccola-master/DXF/base3.SLDPRT
80.0 x 3.00 x 80.0 mm
