anmh1205/AML_MicroMouse_2024/0. Example/WolfieMouse-RTOS/hardware/kicad_wolfiemouse/3D_Model/wheel.STL

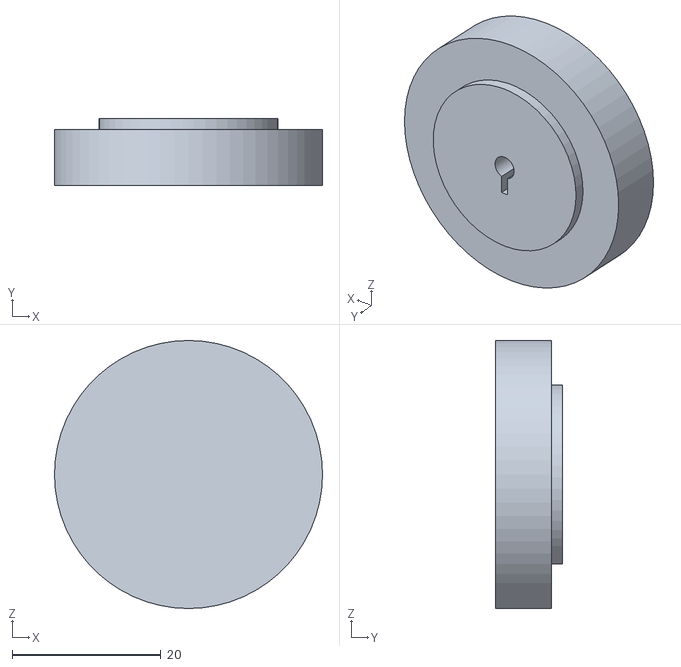
[picture p49: CAD file, 2024-08-10]
0. Example/WolfieMouse-RTOS/hardware/kicad_wolfiemouse/3D_Model/wheel.STL
36.0 x 9.00 x 36.0
