anmh1205/AML_MicroMouse_2024/2. MicroMouse PCB/Outline/MicroMouse2023_T2.DXF

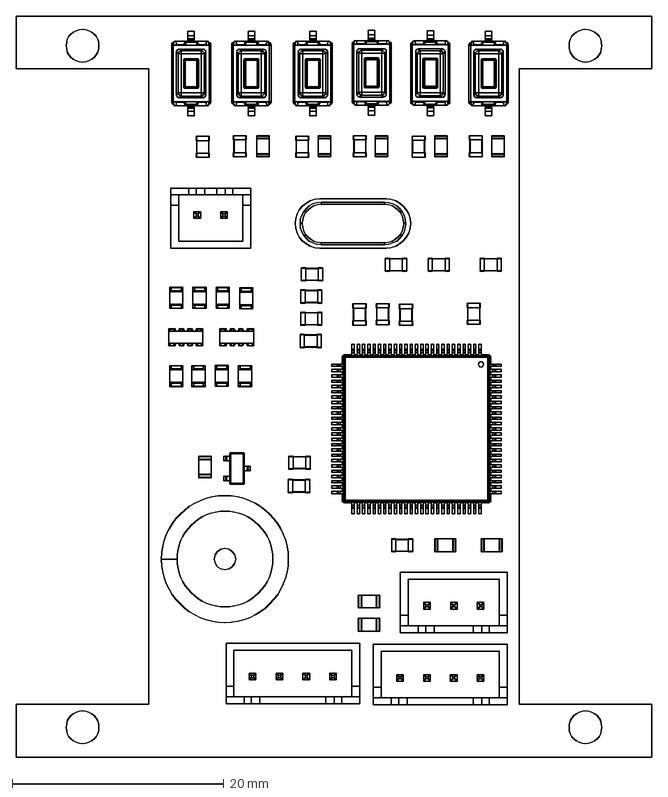
[picture p50: CAD file, 2024-08-10]
2. MicroMouse PCB/Outline/MicroMouse2023_T2.DXF
60.0 x 70.0 mm
