anmh1205/AML_MicroMouse_2024/2. MicroMouse PCB/PCB_AIO_V2/3D Model/JST - XH - Thru (V) - 9Pin - 2.54mm.stp

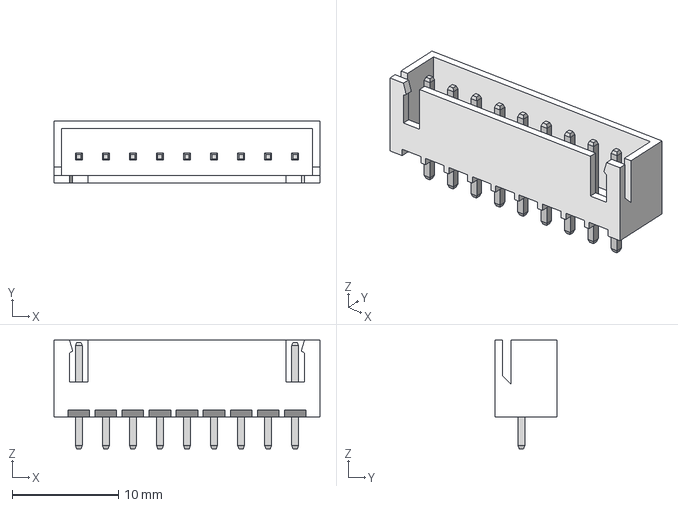
[picture p51: CAD file, 2024-11-05]
2. MicroMouse PCB/PCB_AIO_V2/3D Model/JST - XH - Thru (V) - 9Pin - 2.54mm.stp
25.0 x 5.84 x 10.2 mm
