anmh1205/AML_MicroMouse_2024/3. Drawing/Micromouse/Bánh răng/Banh rang 0.4M 13T 20PA 1.5FW.SLDPRT

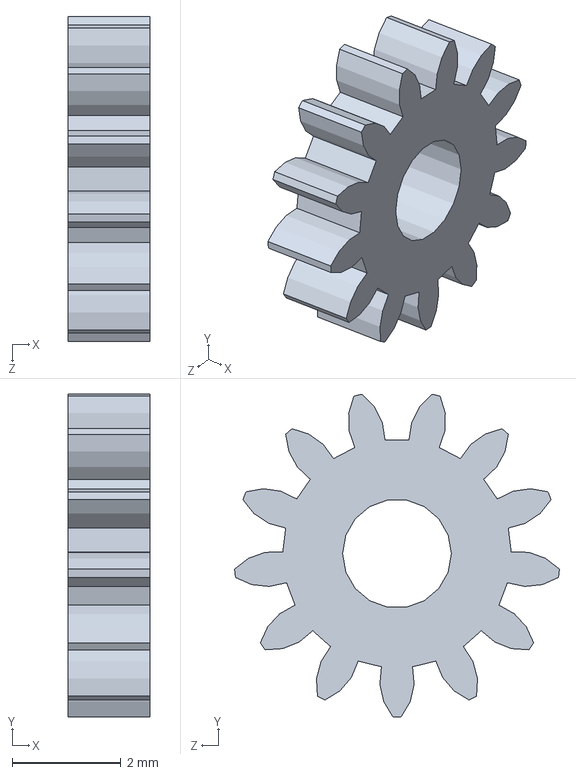
[picture p53: CAD file, 2024-08-10]
3. Drawing/Micromouse/Bánh răng/Banh rang 0.4M 13T 20PA 1.5FW.SLDPRT
1.50 x 5.93 x 5.97 mm
