anmh1205/AML_MicroMouse_2024/3. Drawing/Micromouse/Bánh xe/Truc 2x14.SLDPRT

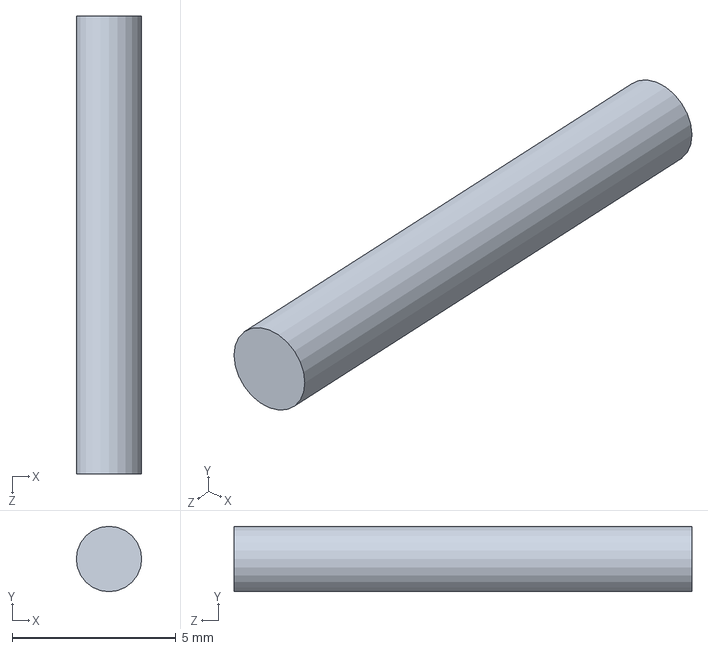
[picture p54: CAD file, 2024-08-10]
3. Drawing/Micromouse/Bánh xe/Truc 2x14.SLDPRT
2.00 x 2.00 x 14.0 mm
