anmh1205/AML_MicroMouse_2024/3. Drawing/Micromouse/Nam cham.SLDPRT

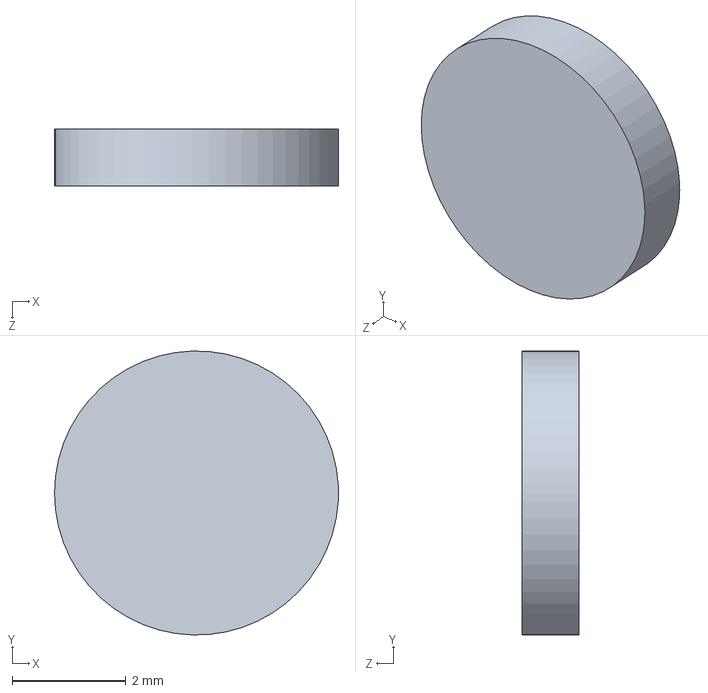
[picture p55: CAD file, 2024-08-10]
3. Drawing/Micromouse/Nam cham.SLDPRT
5.00 x 5.00 x 1.00 mm
