anmh1205/AML_MicroMouse_2024/3. Drawing/v8/PCB.SLDPRT

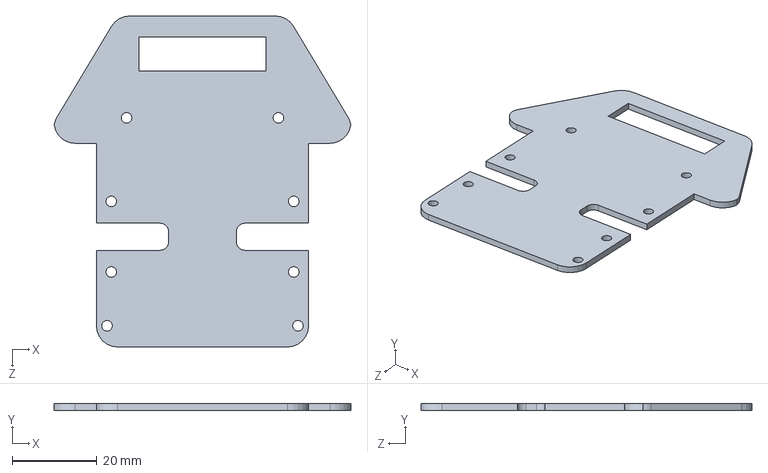
[picture p56: CAD file, 2024-11-05]
3. Drawing/v8/PCB.SLDPRT
69.9 x 1.60 x 78.0 mm
