anmh1205/AML_MicroMouse_2024/0. Example/WolfieMouse-RTOS/hardware/kicad_wolfiemouse/3D_Model/Sensor_Housing.STL

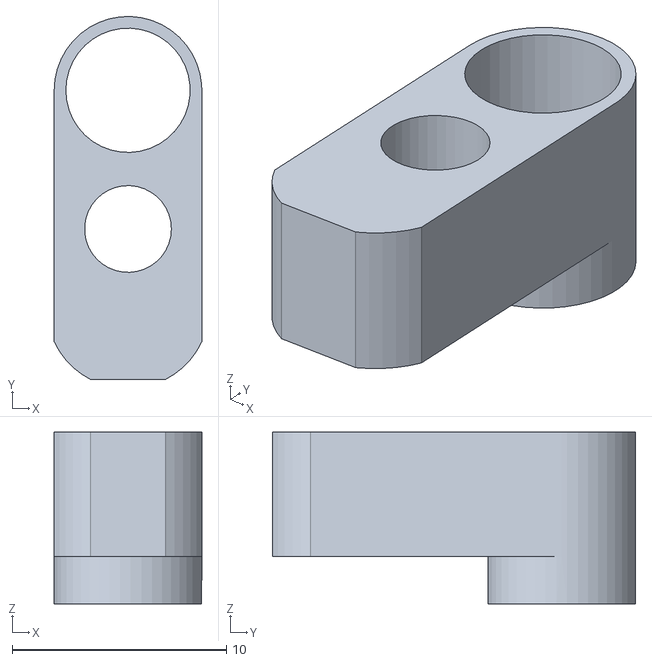
[picture p57: CAD file, 2024-08-10]
0. Example/WolfieMouse-RTOS/hardware/kicad_wolfiemouse/3D_Model/Sensor_Housing.STL
6.89 x 16.9 x 8.03
