anmh1205/AML_MicroMouse_2024/2. MicroMouse PCB/PCB_AIO_V2/Outline/PCB3.DXF

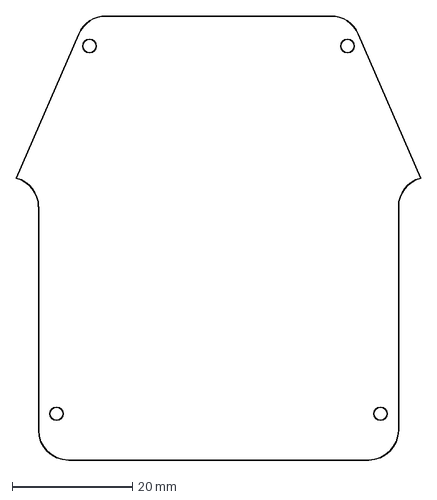
[picture p59: CAD file, 2024-11-05]
2. MicroMouse PCB/PCB_AIO_V2/Outline/PCB3.DXF
67.3 x 74.0 mm
