anmh1205/AML_MicroMouse_2024/3. Drawing/Micromouse/Bánh răng/Banh rang 0.4M 39T 20PA 1FW.SLDPRT

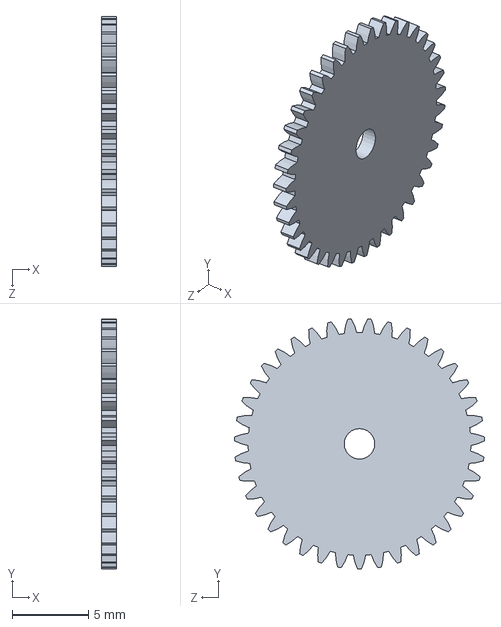
[picture p60: CAD file, 2024-08-10]
3. Drawing/Micromouse/Bánh răng/Banh rang 0.4M 39T 20PA 1FW.SLDPRT
1.00 x 16.4 x 16.4 mm
