anmh1205/AML_MicroMouse_2024/3. Drawing/Micromouse/Ga cum banh.SLDPRT

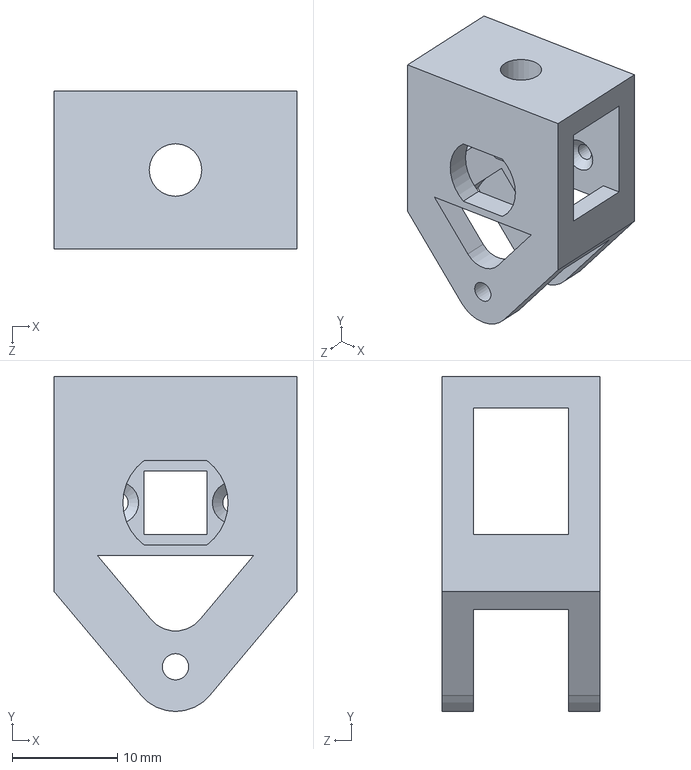
[picture p61: CAD file, 2024-08-10]
3. Drawing/Micromouse/Ga cum banh.SLDPRT
23.1 x 31.8 x 15.0 mm
