anmh1205/AML_MicroMouse_2024/3. Drawing/v8/gearT7.SLDPRT

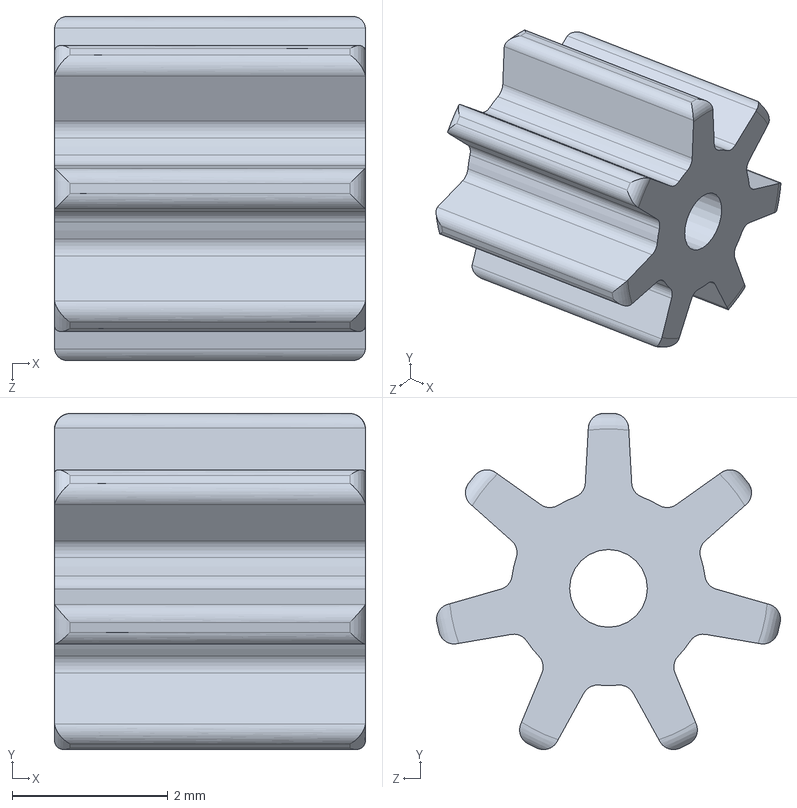
[picture p62: CAD file, 2024-11-05]
3. Drawing/v8/gearT7.SLDPRT
4.00 x 4.32 x 4.42 mm
