anmh1205/AML_MicroMouse_2024/0. Example/WolfieMouse-RTOS/hardware/kicad_wolfiemouse/3D_Model/skate.stl

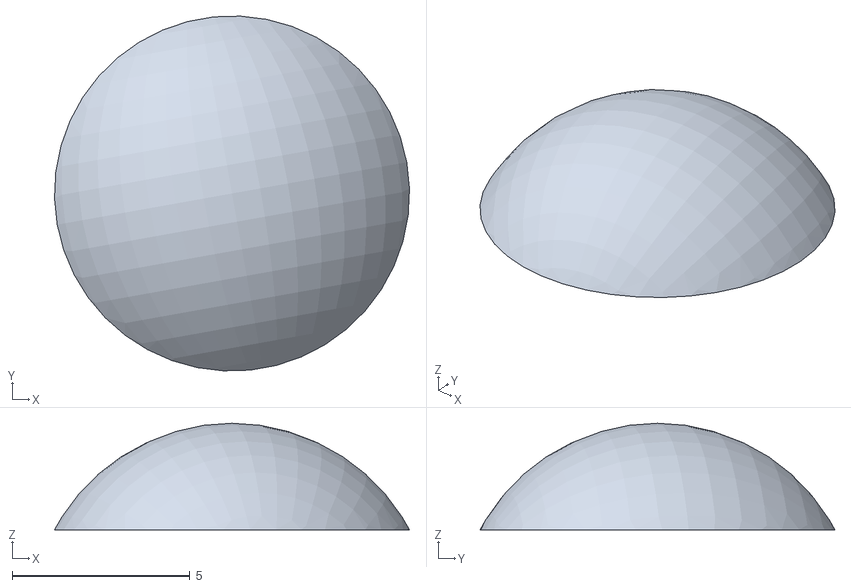
[picture p63: CAD file, 2024-08-10]
0. Example/WolfieMouse-RTOS/hardware/kicad_wolfiemouse/3D_Model/skate.stl
10.00 x 9.99 x 3.00
