anmh1205/AML_MicroMouse_2024/2. MicroMouse PCB/PCB_AIO_V2/3D Model/mpu6050.STEP

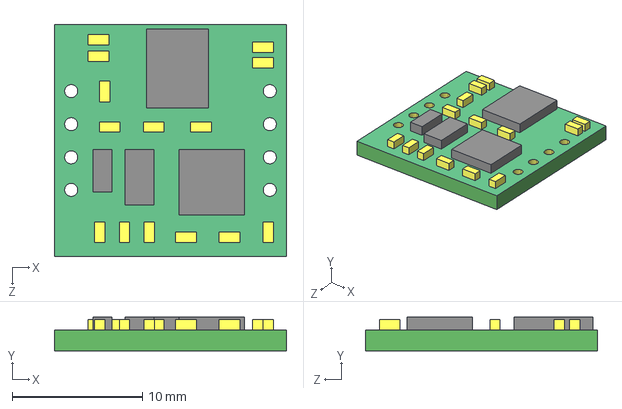
[picture p64: CAD file, 2024-11-05]
2. MicroMouse PCB/PCB_AIO_V2/3D Model/mpu6050.STEP
17.8 x 2.60 x 17.8 mm
