anmh1205/AML_MicroMouse_2024/2. MicroMouse PCB/PCB_AIO_V2/Outline/PCB_AIO_V2_Outline.DXF

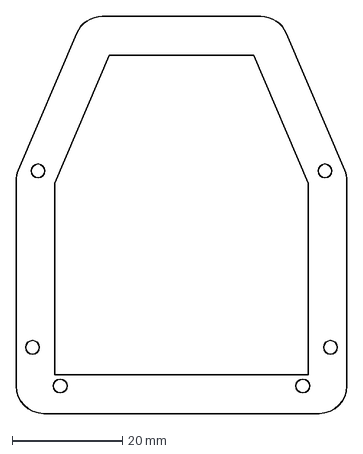
[picture p65: CAD file, 2024-11-05]
2. MicroMouse PCB/PCB_AIO_V2/Outline/PCB_AIO_V2_Outline.DXF
60.0 x 72.0 mm
