anmh1205/AML_MicroMouse_2024/3. Drawing/Micromouse/Tower Pro MG90S Micro servo.step.SLDPRT

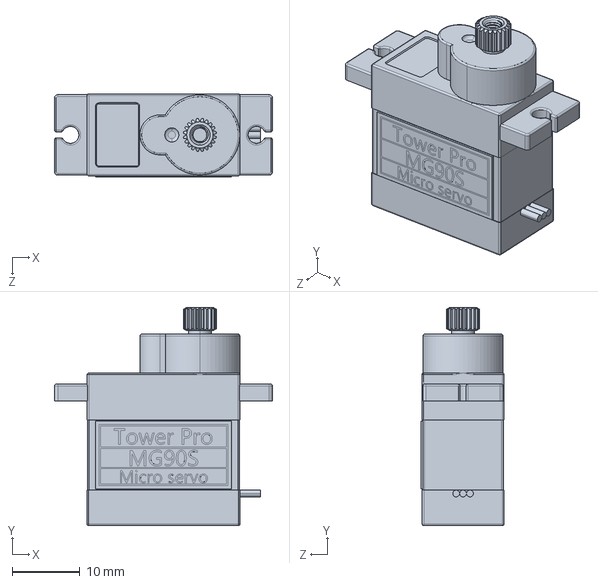
[picture p66: CAD file, 2024-08-10]
3. Drawing/Micromouse/Tower Pro MG90S Micro servo.step.SLDPRT
32.2 x 32.2 x 12.3 mm
