anmh1205/AML_MicroMouse_2024/3. Drawing/Ver3_07082024/Nap.SLDPRT

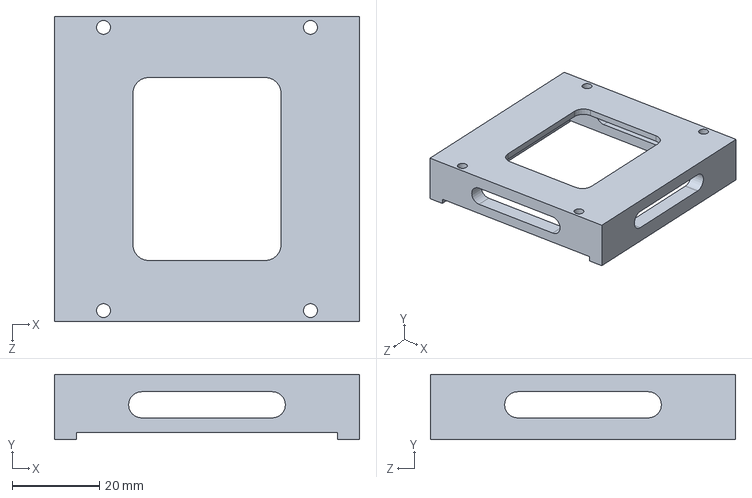
[picture p67: CAD file, 2024-08-10]
3. Drawing/Ver3_07082024/Nap.SLDPRT
70.0 x 15.0 x 70.0 mm
