anmh1205/AML_MicroMouse_2024/2. MicroMouse PCB/PCB_AIO_V2/3D Model/CUI_DEVICES_CMT-9504-87-SMT-TR.step

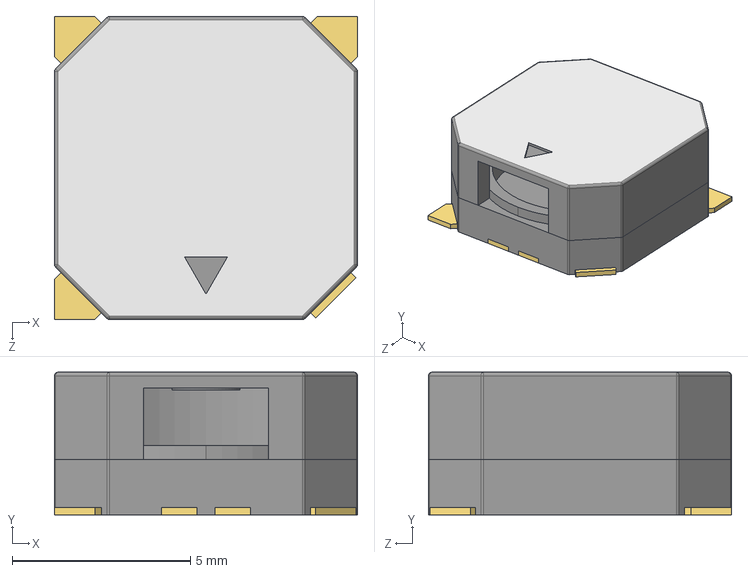
[picture p68: CAD file, 2024-08-29]
2. MicroMouse PCB/PCB_AIO_V2/3D Model/CUI_DEVICES_CMT-9504-87-SMT-TR.step
8.50 x 4.00 x 8.50 mm
