anmh1205/AML_MicroMouse_2024/3. Drawing/Micromouse/Bao banh xe.SLDPRT

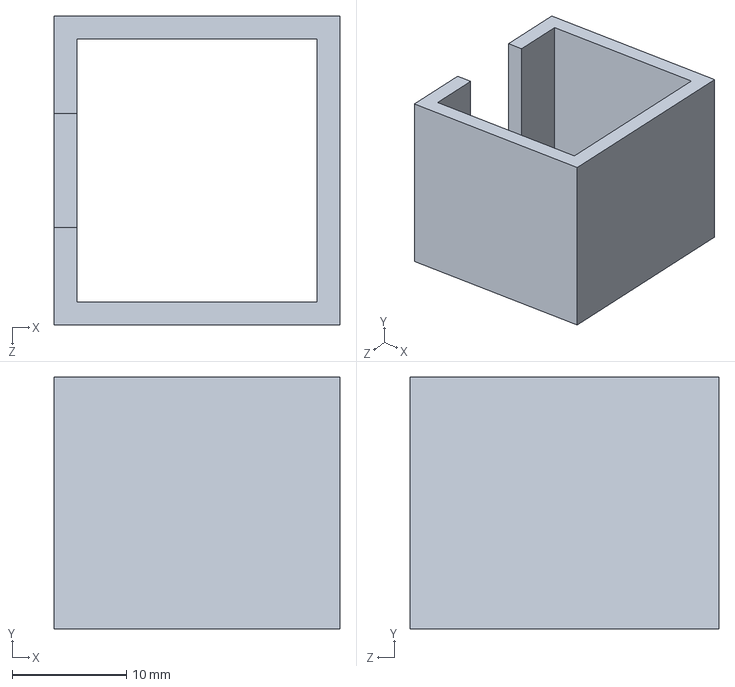
[picture p69: CAD file, 2024-08-10]
3. Drawing/Micromouse/Bao banh xe.SLDPRT
25.0 x 22.0 x 27.0 mm
