anmh1205/AML_MicroMouse_2024/3. Drawing/v8/Ga nam chamV3.SLDPRT

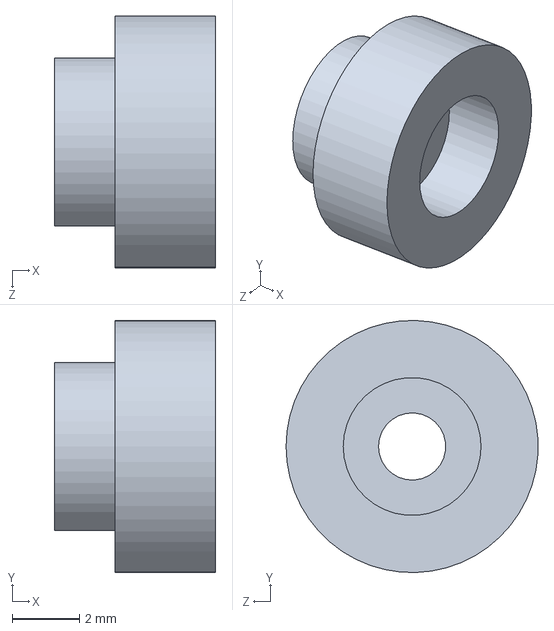
[picture p70: CAD file, 2024-11-05]
3. Drawing/v8/Ga nam chamV3.SLDPRT
4.80 x 7.50 x 7.49 mm
