anmh1205/AML_MicroMouse_2024/3. Drawing/Ver3_07082024/Spur gear 0.4M 15T 1.0N.SLDPRT

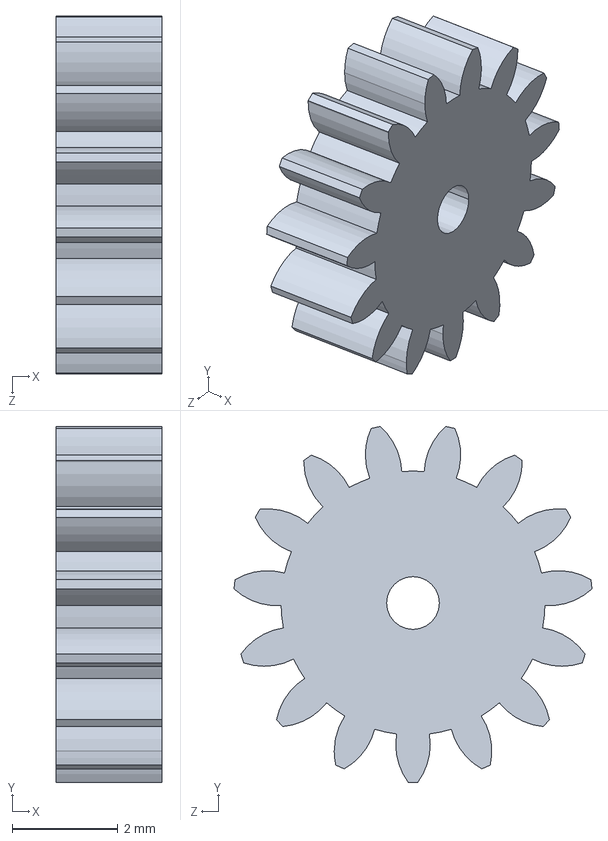
[picture p71: CAD file, 2024-08-10]
3. Drawing/Ver3_07082024/Spur gear 0.4M 15T 1.0N.SLDPRT
2.00 x 6.74 x 6.78 mm
