anmh1205/AML_MicroMouse_2024/2. MicroMouse PCB/PCB_AIO_V2/3D Model/BM04B-SRSS-TB-white.STEP

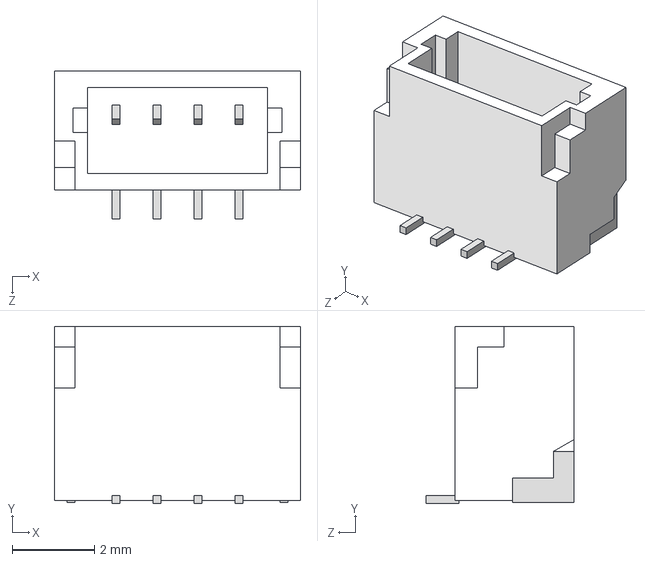
[picture p72: CAD file, 2024-08-29]
2. MicroMouse PCB/PCB_AIO_V2/3D Model/BM04B-SRSS-TB-white.STEP
6.00 x 4.32 x 3.60 mm
