anmh1205/AML_MicroMouse_2024/3. Drawing/Micromouse/Encoder.SLDPRT

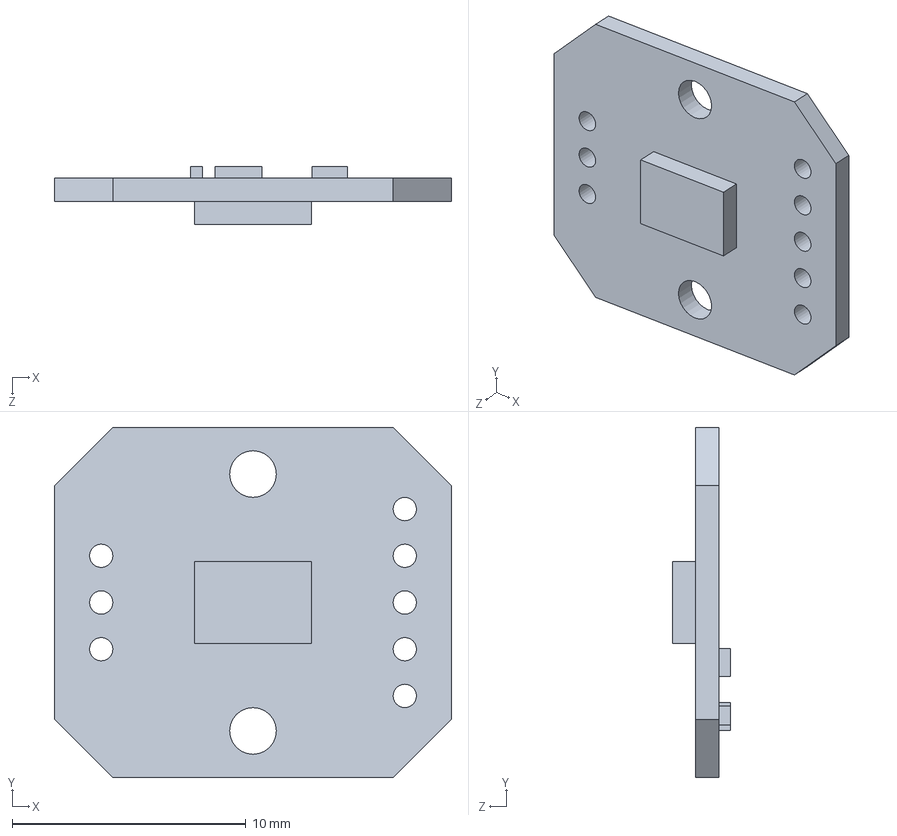
[picture p73: CAD file, 2024-08-10]
3. Drawing/Micromouse/Encoder.SLDPRT
17.0 x 15.0 x 2.50 mm
