anmh1205/AML_MicroMouse_2024/3. Drawing/v8/GP2Y0A41SK0F.stp

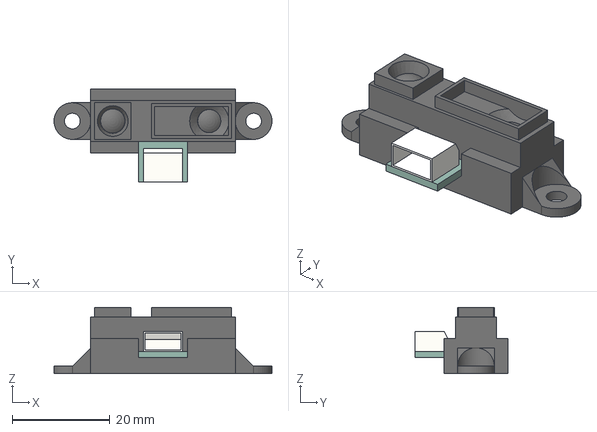
[picture p74: CAD file, 2024-11-05]
3. Drawing/v8/GP2Y0A41SK0F.stp
44.5 x 18.9 x 13.5 mm
