anmh1205/AML_MicroMouse_2024/3. Drawing/Ver3_07082024/Nam cham.SLDPRT

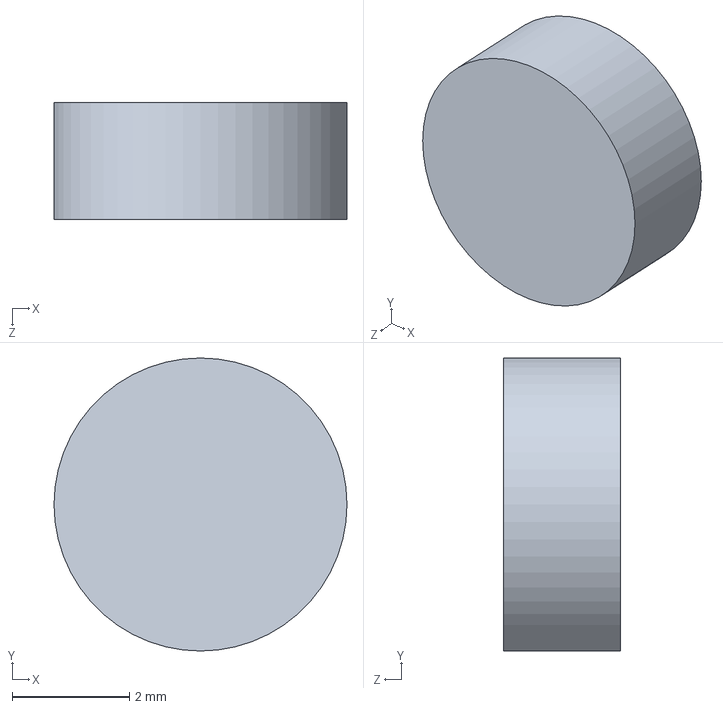
[picture p75: CAD file, 2024-08-10]
3. Drawing/Ver3_07082024/Nam cham.SLDPRT
5.00 x 5.00 x 2.00 mm
