anmh1205/AML_MicroMouse_2024/3. Drawing/v8/Ga sensor 1.SLDPRT

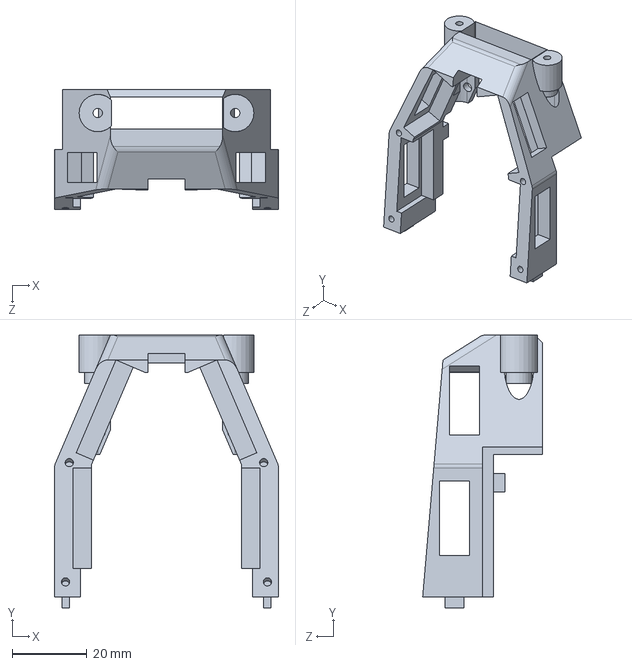
[picture p77: CAD file, 2024-11-05]
3. Drawing/v8/Ga sensor 1.SLDPRT
60.0 x 73.0 x 32.0 mm
