anmh1205/AML_MicroMouse_2024/3. Drawing/Ver3_07082024/Ga nam chamV3.SLDPRT

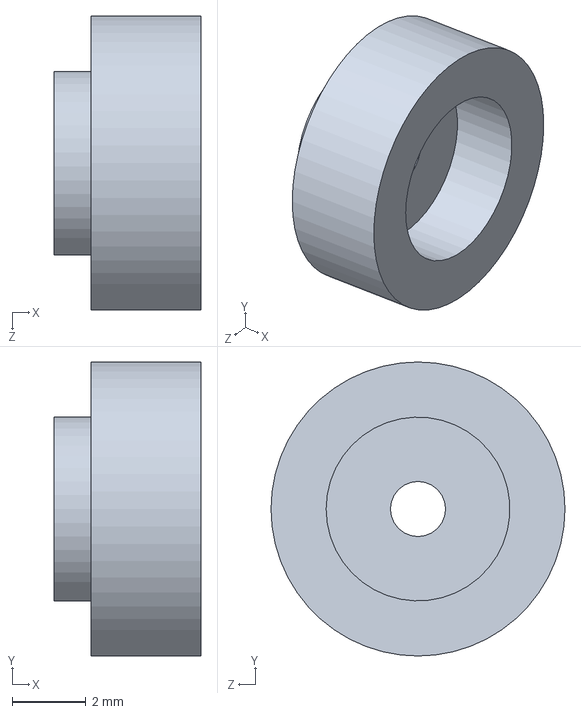
[picture p78: CAD file, 2024-08-10]
3. Drawing/Ver3_07082024/Ga nam chamV3.SLDPRT
4.00 x 8.00 x 8.00 mm
