anmh1205/AML_MicroMouse_2024/2. MicroMouse PCB/PCB_AIO_V2/3D Model/MINI560_light.step

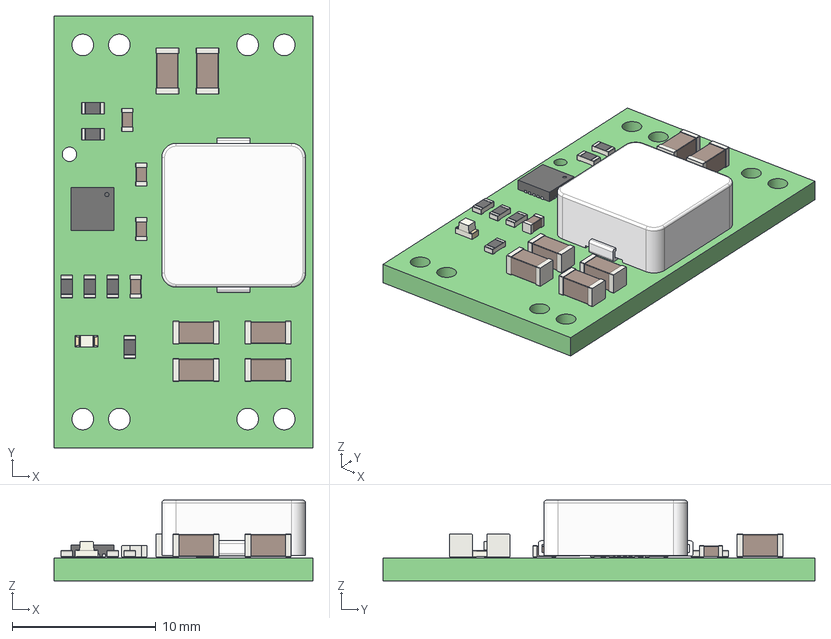
[picture p79: CAD file, 2024-08-29]
2. MicroMouse PCB/PCB_AIO_V2/3D Model/MINI560_light.step
18.0 x 30.0 x 5.62 mm
kicad_module_3D_MINI560 PCB
