anmh1205/AML_MicroMouse_2024/3. Drawing/v8/Kep truc.SLDPRT

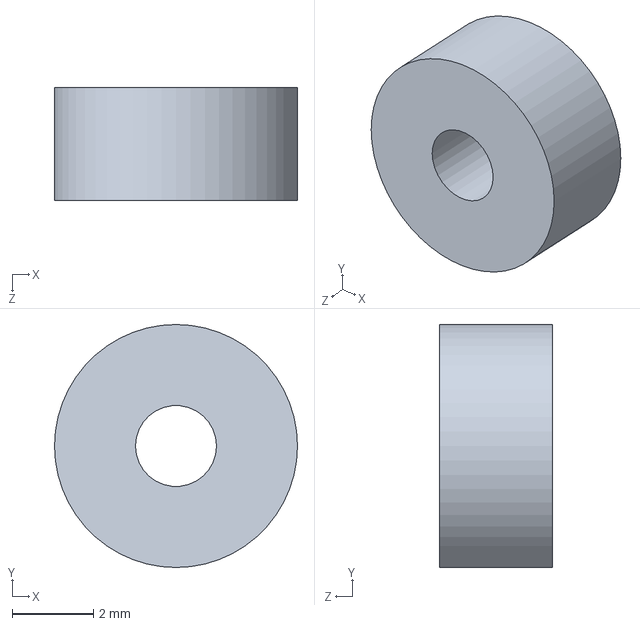
[picture p80: CAD file, 2024-11-05]
3. Drawing/v8/Kep truc.SLDPRT
6.00 x 6.00 x 2.80 mm
