anmh1205/AML_MicroMouse_2024/3. Drawing/Ver3_07082024/Truc 2x20.SLDPRT

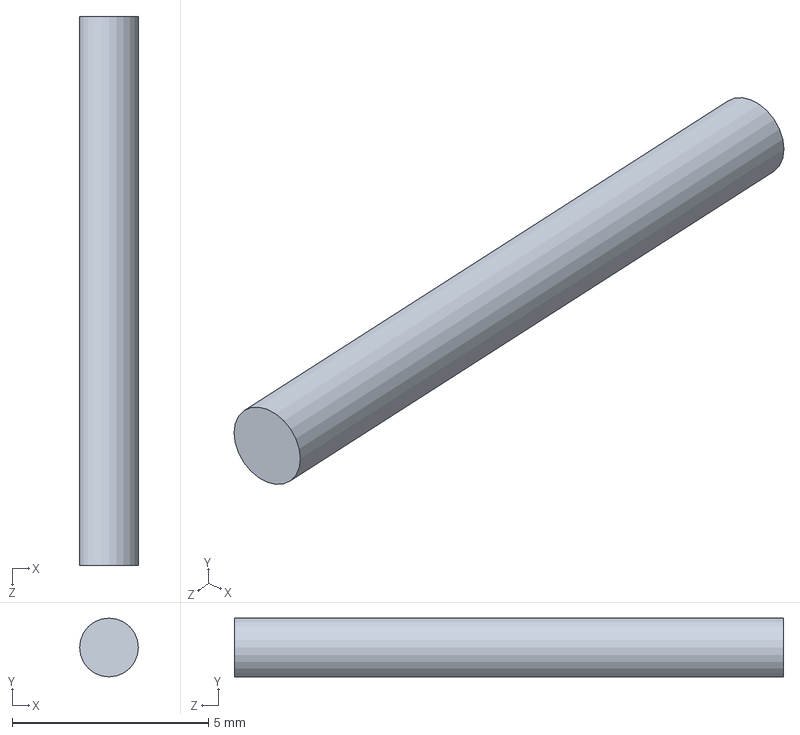
[picture p81: CAD file, 2024-08-10]
3. Drawing/Ver3_07082024/Truc 2x20.SLDPRT
1.50 x 1.50 x 14.0 mm
