anmh1205/AML_MicroMouse_2024/3. Drawing/v8/Ga DC2.SLDPRT

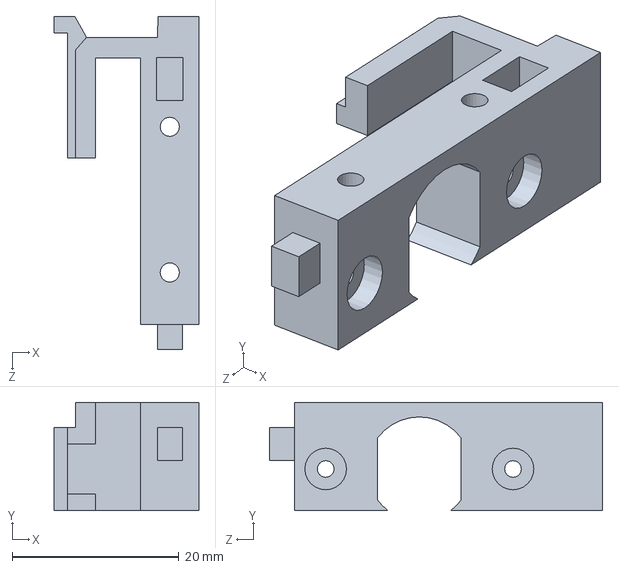
[picture p83: CAD file, 2024-11-05]
3. Drawing/v8/Ga DC2.SLDPRT
17.4 x 13.0 x 40.0 mm
