anmh1205/AML_MicroMouse_2024/3. Drawing/Ver3_07082024/Vong bi 2x5x2.5.SLDPRT

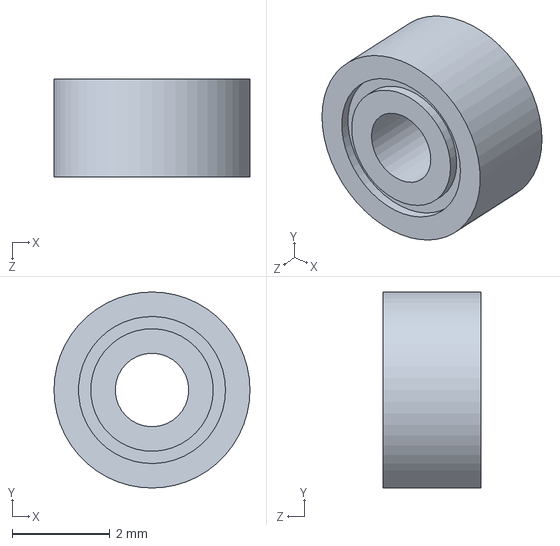
[picture p84: CAD file, 2024-08-10]
3. Drawing/Ver3_07082024/Vong bi 2x5x2.5.SLDPRT
4.00 x 4.00 x 2.00 mm
