anmh1205/AML_MicroMouse_2024/2. MicroMouse PCB/PCB_AIO_V2/3D Model/CUI_DEVICES_CMT-8504-100-SMT-TR.step

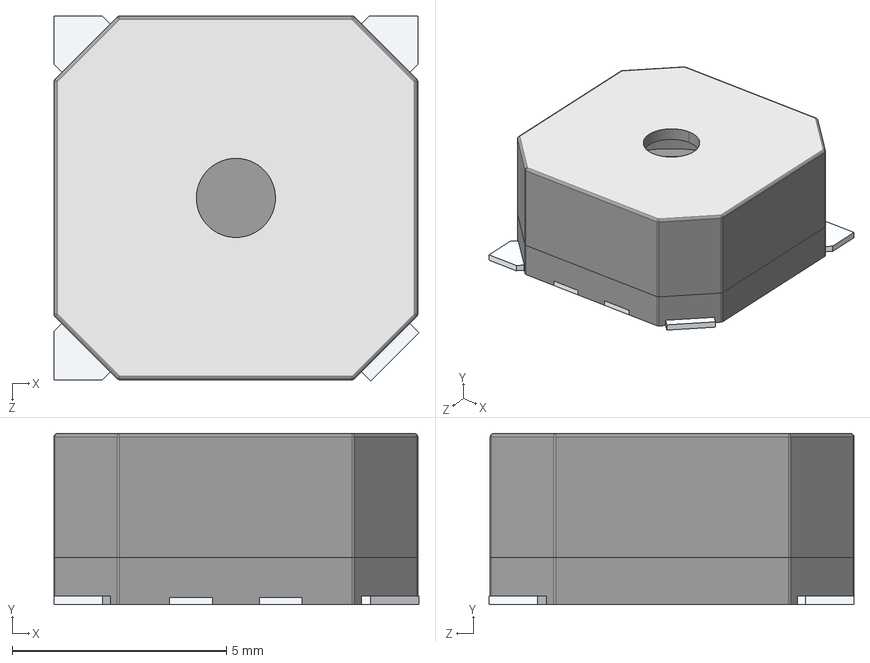
[picture p85: CAD file, 2024-08-29]
2. MicroMouse PCB/PCB_AIO_V2/3D Model/CUI_DEVICES_CMT-8504-100-SMT-TR.step
8.53 x 4.00 x 8.53 mm
