anmh1205/AML_MicroMouse_2024/3. Drawing/v8/MT6701.SLDPRT

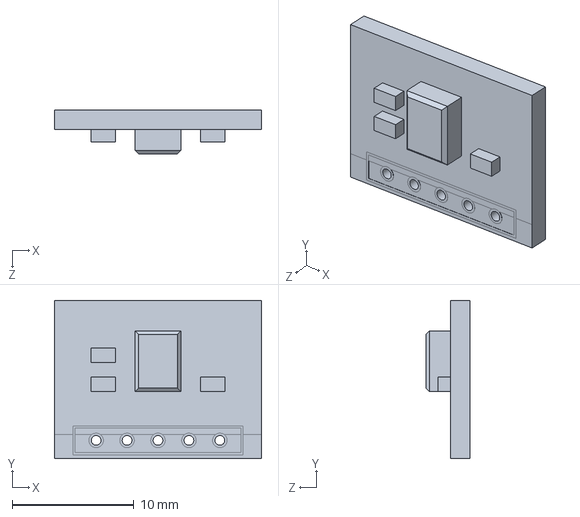
[picture p86: CAD file, 2024-11-05]
3. Drawing/v8/MT6701.SLDPRT
17.0 x 13.0 x 3.61 mm
