anmh1205/AML_MicroMouse_2024/2. MicroMouse PCB/PCB_AIO_V2/3D Model/SM03B-SRSS-TB-white.STEP

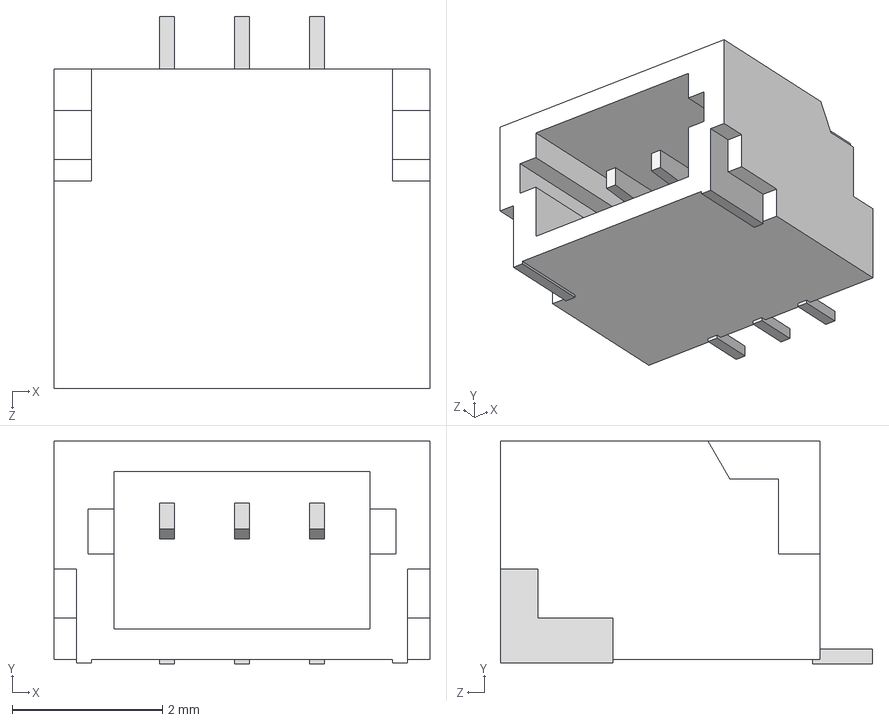
[picture p88: CAD file, 2024-08-29]
2. MicroMouse PCB/PCB_AIO_V2/3D Model/SM03B-SRSS-TB-white.STEP
5.00 x 2.96 x 4.95 mm
