anmh1205/AML_MicroMouse_2024/3. Drawing/v8/PCB2.SLDPRT

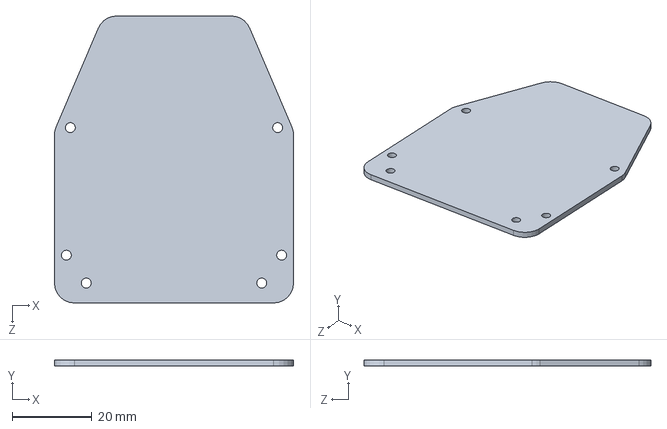
[picture p89: CAD file, 2024-11-05]
3. Drawing/v8/PCB2.SLDPRT
60.0 x 1.60 x 72.0 mm
