anmh1205/AML_MicroMouse_2024/3. Drawing/Ver3_07082024/MT6701.SLDPRT

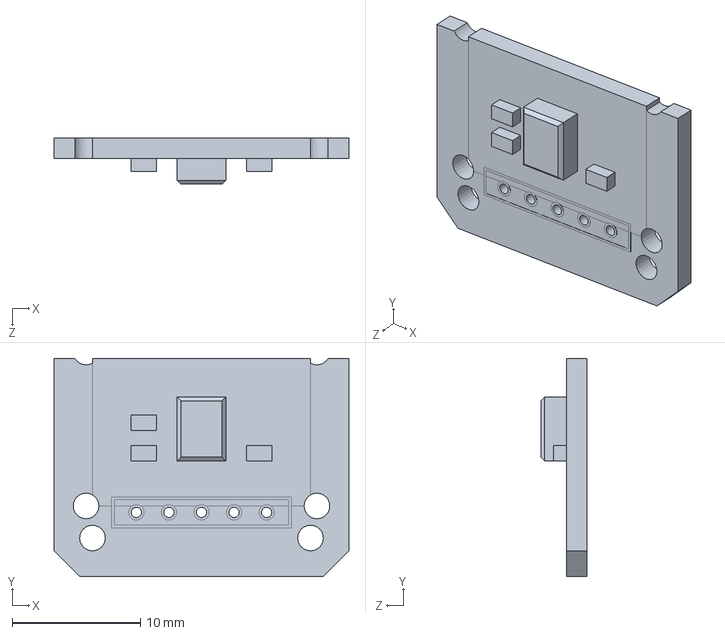
[picture p90: CAD file, 2024-08-10]
3. Drawing/Ver3_07082024/MT6701.SLDPRT
23.0 x 17.0 x 3.61 mm
