anmh1205/AML_MicroMouse_2024/3. Drawing/v8/Pin.SLDPRT

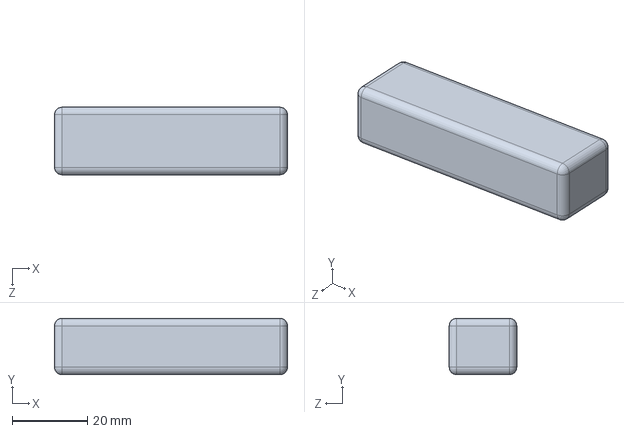
[picture p91: CAD file, 2024-11-05]
3. Drawing/v8/Pin.SLDPRT
62.0 x 15.0 x 18.0 mm
