anmh1205/AML_MicroMouse_2024/3. Drawing/Ver3_07082024/khung dem.SLDPRT

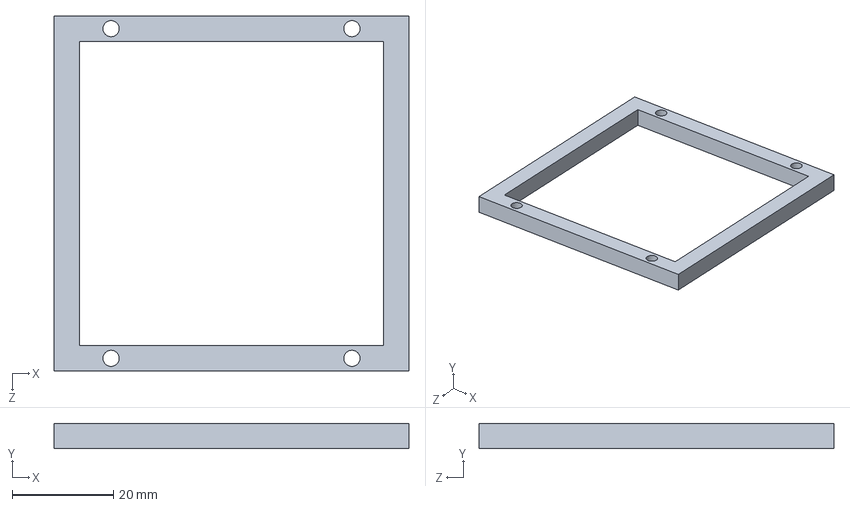
[picture p92: CAD file, 2024-08-10]
3. Drawing/Ver3_07082024/khung dem.SLDPRT
70.0 x 5.00 x 70.0 mm
