anmh1205/AML_MicroMouse_2024/3. Drawing/v8/Truc 2x20.SLDPRT

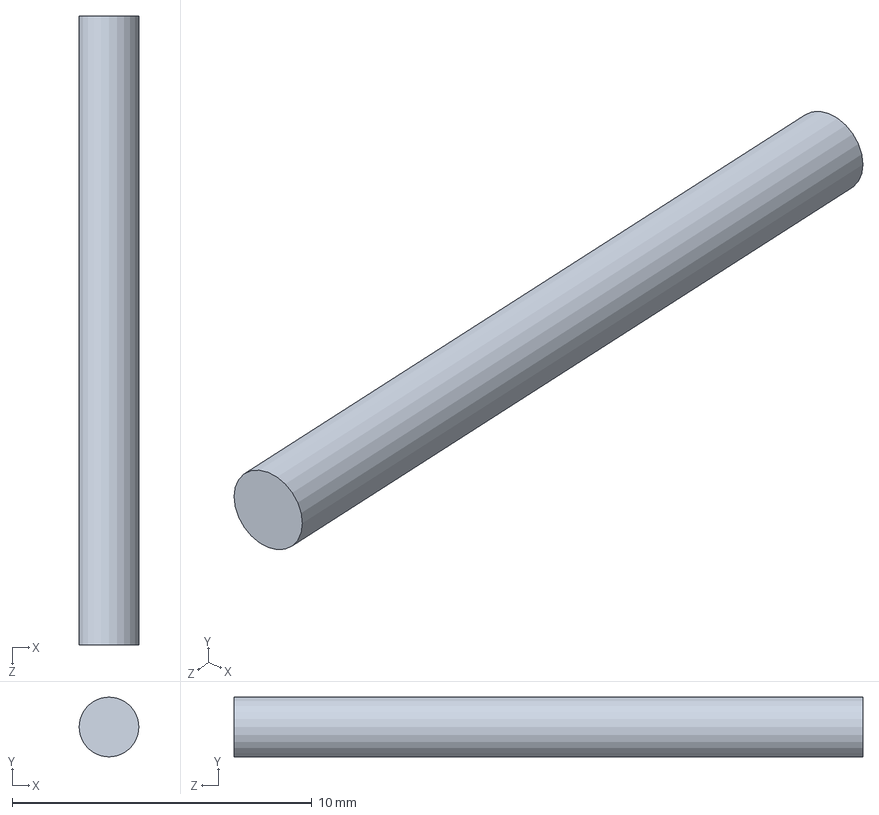
[picture p93: CAD file, 2024-11-05]
3. Drawing/v8/Truc 2x20.SLDPRT
2.00 x 2.00 x 21.0 mm
