anmh1205/AML_MicroMouse_2024/3. Drawing/Ver3_07082024/MicroMouse2023_T1.SLDPRT

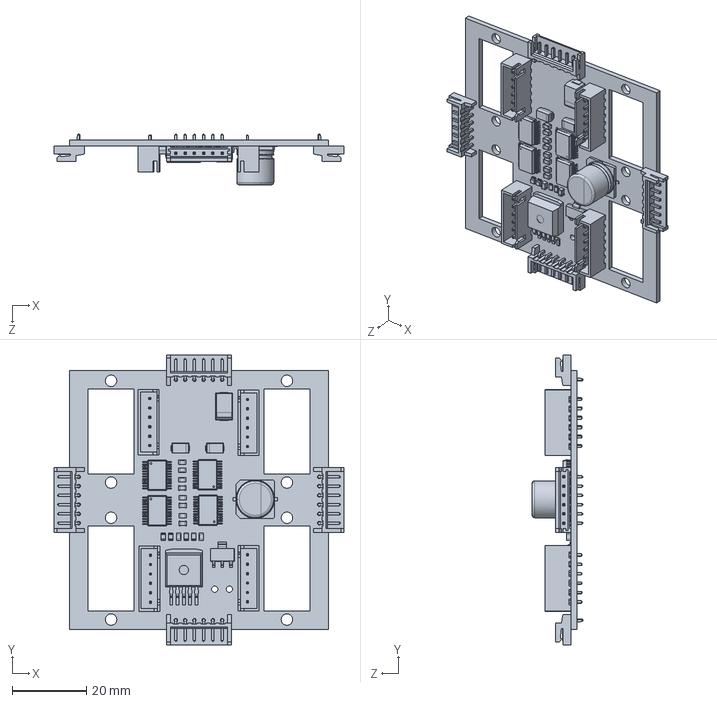
[picture p94: CAD file, 2024-08-10]
3. Drawing/Ver3_07082024/MicroMouse2023_T1.SLDPRT
78.3 x 78.3 x 13.7 mm
