anmh1205/AML_MicroMouse_2024/3. Drawing/v8/Vong bi 2x5x2.5.SLDPRT

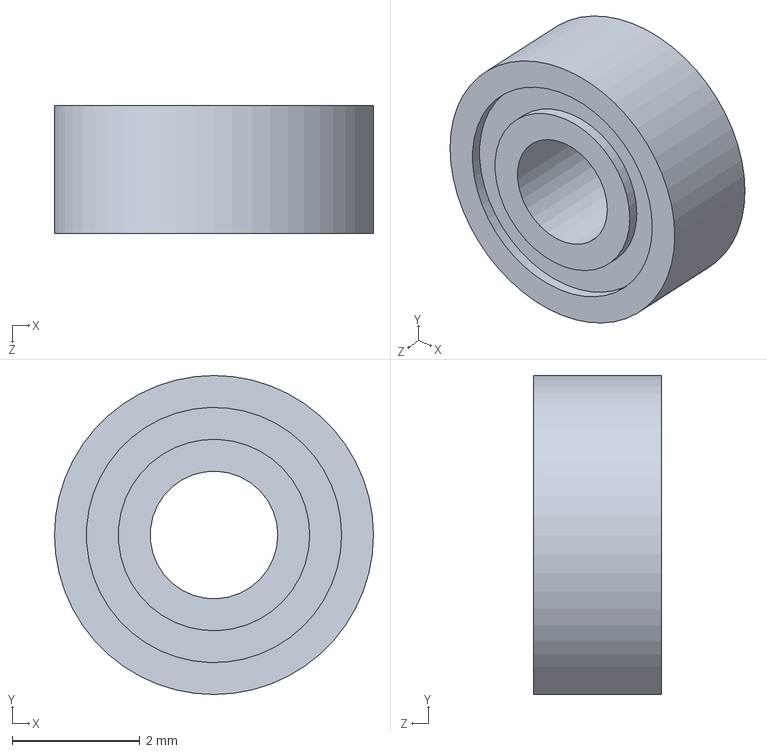
[picture p96: CAD file, 2024-11-05]
3. Drawing/v8/Vong bi 2x5x2.5.SLDPRT
5.00 x 5.00 x 2.00 mm
