anmh1205/AML_MicroMouse_2024/3. Drawing/v8/Mam banh xe.SLDPRT

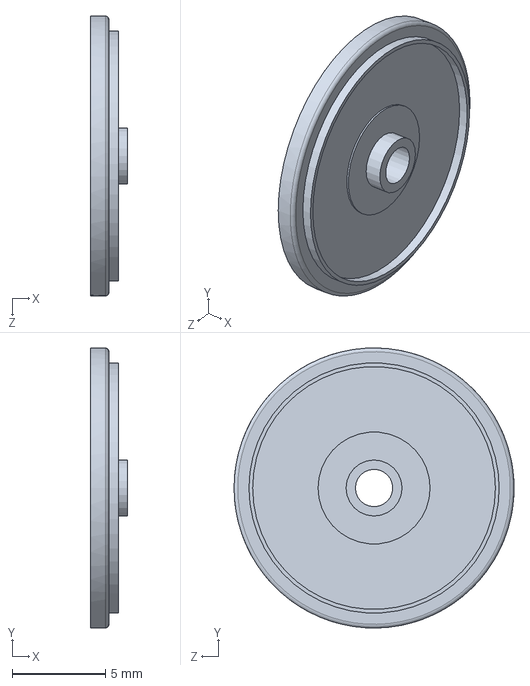
[picture p97: CAD file, 2024-08-10]
3. Drawing/v8/Mam banh xe.SLDPRT
2.00 x 15.0 x 15.0 mm
