anmh1205/AML_MicroMouse_2024/3. Drawing/Ver3_07082024/HMI ESP.SLDPRT

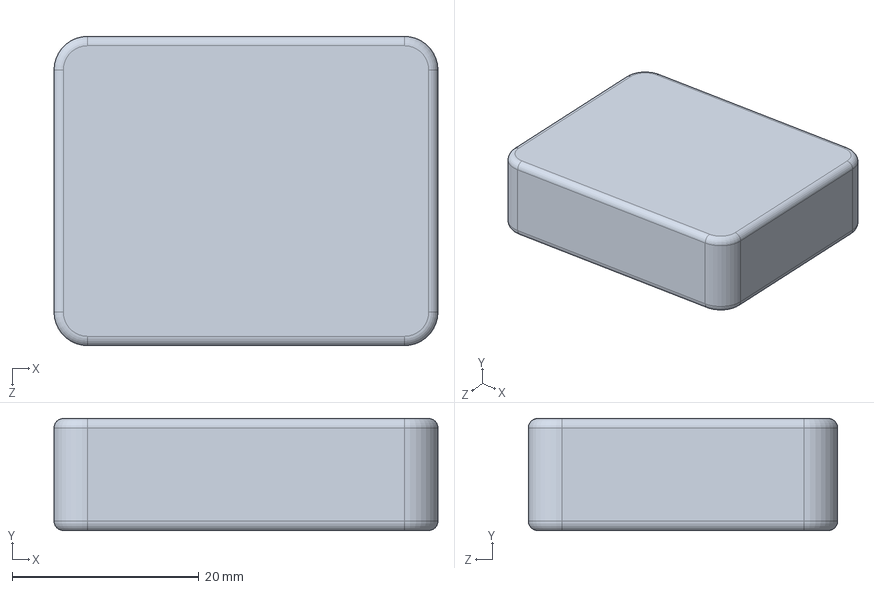
[picture p98: CAD file, 2024-08-10]
3. Drawing/Ver3_07082024/HMI ESP.SLDPRT
41.1 x 12.0 x 33.1 mm
