anmh1205/AML_MicroMouse_2024/3. Drawing/v8/Lop banh xe.SLDPRT

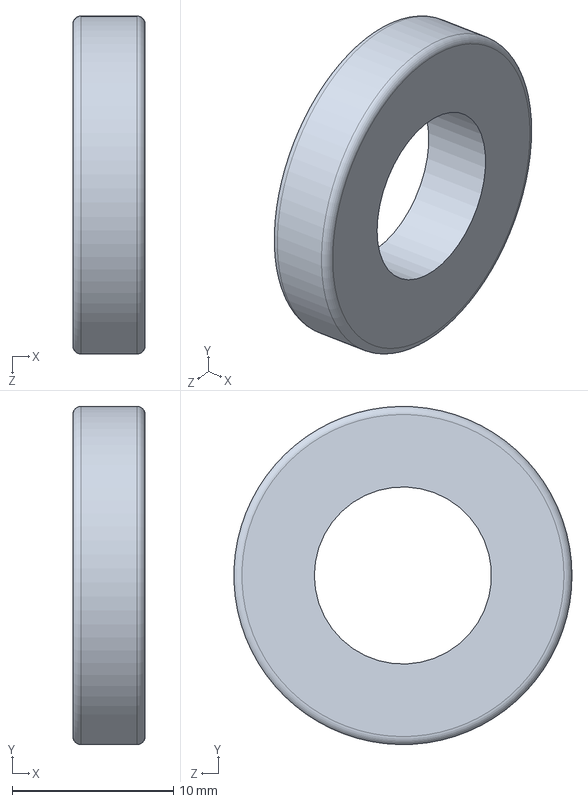
[picture p99: CAD file, 2024-08-10]
3. Drawing/v8/Lop banh xe.SLDPRT
4.50 x 21.0 x 21.0 mm
