anmh1205/AML_MicroMouse_2024/3. Drawing/Ver3_07082024/VL6180X.SLDPRT

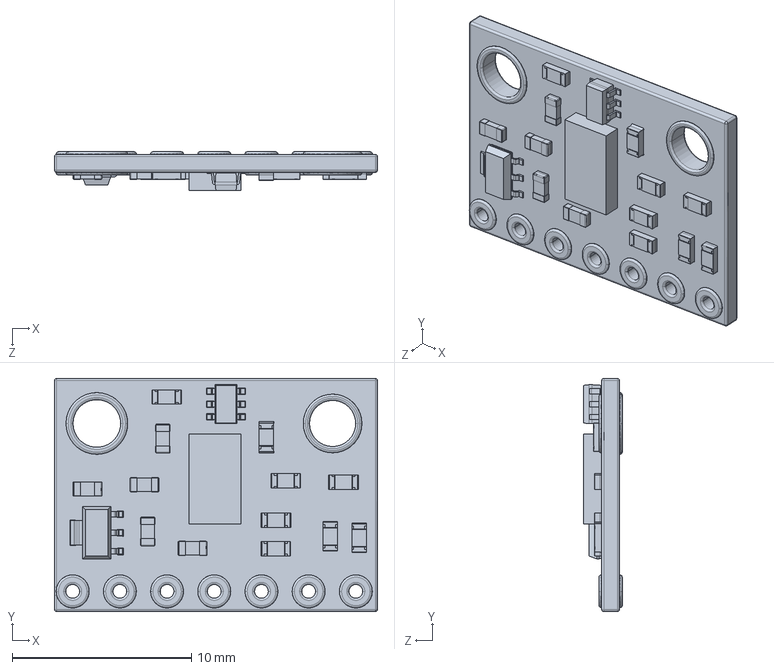
[picture p100: CAD file, 2024-08-10]
3. Drawing/Ver3_07082024/VL6180X.SLDPRT
18.0 x 13.0 x 2.15 mm
