anmh1205/AML_MicroMouse_2024/3. Drawing/v8/N20 DC MOTOR Truc dai.SLDPRT

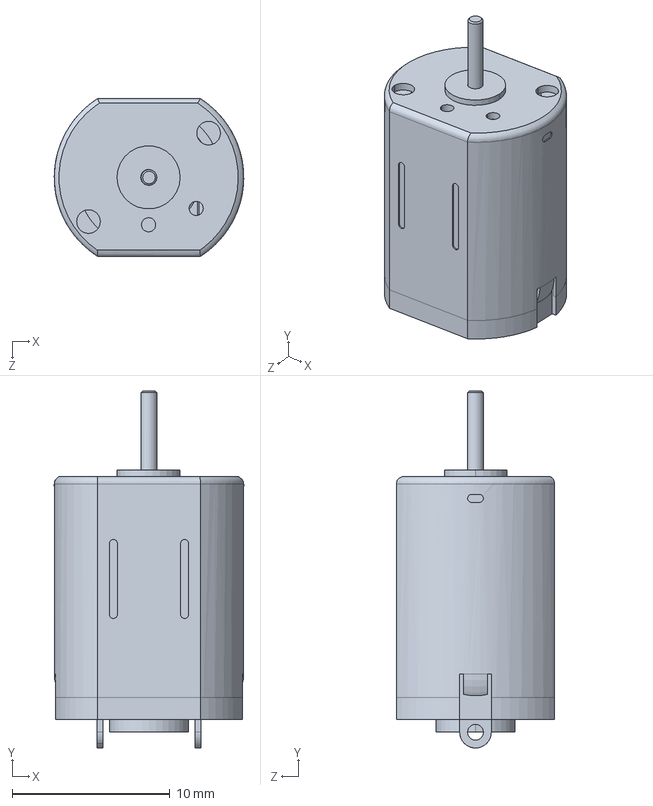
[picture p101: CAD file, 2024-08-10]
3. Drawing/v8/N20 DC MOTOR Truc dai.SLDPRT
12.0 x 22.6 x 10.0 mm
