anmh1205/AML_MicroMouse_2024/3. Drawing/Ver3_07082024/Vo SD2_V3.SLDPRT

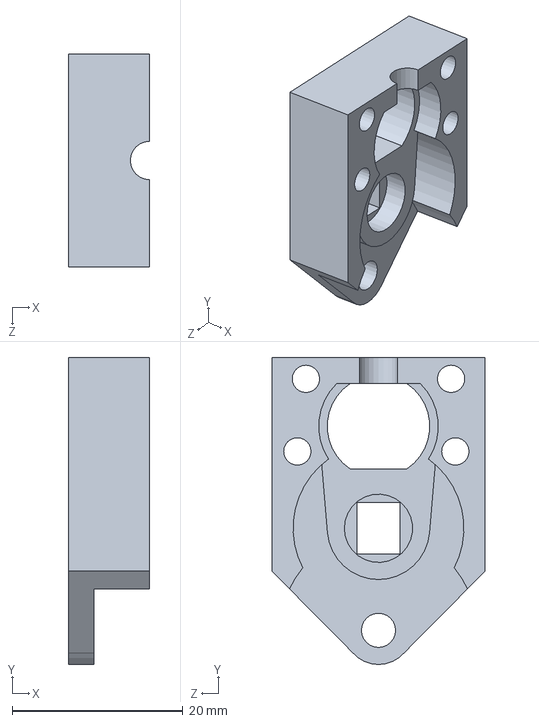
[picture p102: CAD file, 2024-08-10]
3. Drawing/Ver3_07082024/Vo SD2_V3.SLDPRT
9.50 x 36.0 x 25.0 mm
