anmh1205/AML_MicroMouse_2024/3. Drawing/Ver3_07082024/Ga Pin.SLDPRT

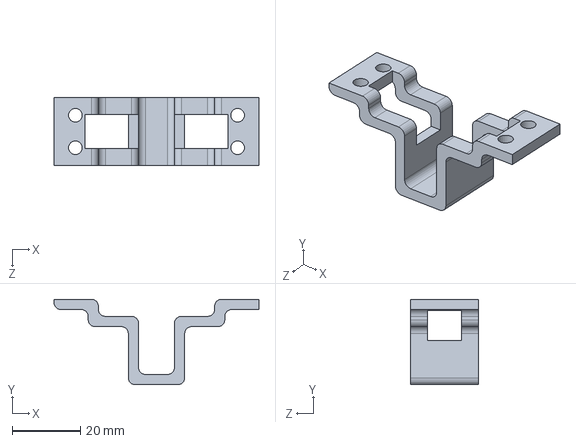
[picture p103: CAD file, 2024-08-10]
3. Drawing/Ver3_07082024/Ga Pin.SLDPRT
60.0 x 25.0 x 20.0 mm
