anmh1205/AML_MicroMouse_2024/3. Drawing/Ver3_07082024/Pin.SLDPRT

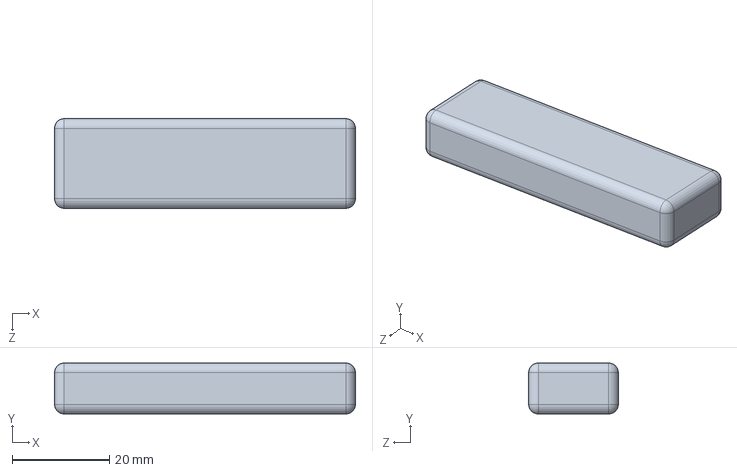
[picture p104: CAD file, 2024-08-10]
3. Drawing/Ver3_07082024/Pin.SLDPRT
62.0 x 10.5 x 18.5 mm
