anmh1205/AML_MicroMouse_2024/(list of files, cad)

Other CAD files:
2. MicroMouse PCB/V1/PCB_T1/Outline/PCB T1.DWG
0. Example/piccola-master/DXF/base2.SLDPRT
3. Drawing/v8/Ga DC.SLDPRT
0. Example/piccola-master/DXF/dxfs/base1.DXF
0. Example/piccola-master/DXF/dxfs/base2.DXF
0. Example/piccola-master/DXF/dxfs/base3.DXF
2. MicroMouse PCB/PCB_AIO_V1/Outline/AIO.DXF
2. MicroMouse PCB/PCB_AIO_V1/TB6612FNG/TB6612FNG,C,8,EL.STEP
2. MicroMouse PCB/PCB_AIO_V1/TB6612FNG/TB6612FNG_C_8_EL/TB6612FNG_C_8_EL.step
2. MicroMouse PCB/PCB_AIO_V1/jts_Kicad/Thru Horizontal/JST - XH - Thru (R) - 10Pin - 2.54mm.stp
2. MicroMouse PCB/PCB_AIO_V1/jts_Kicad/Thru Horizontal/JST - XH - Thru (R) - 11Pin - 2.54mm.stp
2. MicroMouse PCB/PCB_AIO_V1/jts_Kicad/Thru Horizontal/JST - XH - Thru (R) - 12Pin - 2.54mm.stp
2. MicroMouse PCB/PCB_AIO_V1/jts_Kicad/Thru Horizontal/JST - XH - Thru (R) - 13Pin - 2.54mm.stp
2. MicroMouse PCB/PCB_AIO_V1/jts_Kicad/Thru Horizontal/JST - XH - Thru (R) - 14Pin - 2.54mm.stp
2. MicroMouse PCB/PCB_AIO_V1/jts_Kicad/Thru Horizontal/JST - XH - Thru (R) - 15Pin - 2.54mm.stp
2. MicroMouse PCB/PCB_AIO_V1/jts_Kicad/Thru Horizontal/JST - XH - Thru (R) - 16Pin - 2.54mm.stp
2. MicroMouse PCB/PCB_AIO_V1/jts_Kicad/Thru Horizontal/JST - XH - Thru (R) - 17Pin - 2.54mm.stp
2. MicroMouse PCB/PCB_AIO_V1/jts_Kicad/Thru Horizontal/JST - XH - Thru (R) - 18Pin - 2.54mm.stp
2. MicroMouse PCB/PCB_AIO_V1/jts_Kicad/Thru Horizontal/JST - XH - Thru (R) - 19Pin - 2.54mm.stp
2. MicroMouse PCB/PCB_AIO_V1/jts_Kicad/Thru Horizontal/JST - XH - Thru (R) - 20Pin - 2.54mm.stp
2. MicroMouse PCB/PCB_AIO_V1/jts_Kicad/Thru Horizontal/JST - XH - Thru (R) - 2Pin - 2.54mm.stp
2. MicroMouse PCB/PCB_AIO_V1/jts_Kicad/Thru Horizontal/JST - XH - Thru (R) - 3Pin - 2.54mm.stp
2. MicroMouse PCB/PCB_AIO_V1/jts_Kicad/Thru Horizontal/JST - XH - Thru (R) - 4Pin - 2.54mm.stp
2. MicroMouse PCB/PCB_AIO_V1/jts_Kicad/Thru Horizontal/JST - XH - Thru (R) - 5Pin - 2.54mm.stp
2. MicroMouse PCB/PCB_AIO_V1/jts_Kicad/Thru Horizontal/JST - XH - Thru (R) - 6Pin - 2.54mm.stp
2. MicroMouse PCB/PCB_AIO_V1/jts_Kicad/Thru Horizontal/JST - XH - Thru (R) - 7Pin - 2.54mm.stp
2. MicroMouse PCB/PCB_AIO_V1/jts_Kicad/Thru Horizontal/JST - XH - Thru (R) - 8Pin - 2.54mm.stp
2. MicroMouse PCB/PCB_AIO_V1/jts_Kicad/Thru Horizontal/JST - XH - Thru (R) - 9Pin - 2.54mm.stp
2. MicroMouse PCB/PCB_AIO_V1/jts_Kicad/Thru Vertical/JST - XH - Thru (V) - 10Pin - 2.54mm.stp
2. MicroMouse PCB/PCB_AIO_V1/jts_Kicad/Thru Vertical/JST - XH - Thru (V) - 11Pin - 2.54mm.stp
2. MicroMouse PCB/PCB_AIO_V1/jts_Kicad/Thru Vertical/JST - XH - Thru (V) - 12Pin - 2.54mm.stp
2. MicroMouse PCB/PCB_AIO_V1/jts_Kicad/Thru Vertical/JST - XH - Thru (V) - 13Pin - 2.54mm.stp
2. MicroMouse PCB/PCB_AIO_V1/jts_Kicad/Thru Vertical/JST - XH - Thru (V) - 14Pin - 2.54mm.stp
2. MicroMouse PCB/PCB_AIO_V1/jts_Kicad/Thru Vertical/JST - XH - Thru (V) - 15Pin - 2.54mm.stp
2. MicroMouse PCB/PCB_AIO_V1/jts_Kicad/Thru Vertical/JST - XH - Thru (V) - 16Pin - 2.54mm.stp
2. MicroMouse PCB/PCB_AIO_V1/jts_Kicad/Thru Vertical/JST - XH - Thru (V) - 17Pin - 2.54mm.stp
2. MicroMouse PCB/PCB_AIO_V1/jts_Kicad/Thru Vertical/JST - XH - Thru (V) - 18Pin - 2.54mm.stp
2. MicroMouse PCB/PCB_AIO_V1/jts_Kicad/Thru Vertical/JST - XH - Thru (V) - 19Pin - 2.54mm.stp
2. MicroMouse PCB/PCB_AIO_V1/jts_Kicad/Thru Vertical/JST - XH - Thru (V) - 20Pin - 2.54mm.stp
2. MicroMouse PCB/PCB_AIO_V1/jts_Kicad/Thru Vertical/JST - XH - Thru (V) - 2Pin - 2.54mm.stp
2. MicroMouse PCB/PCB_AIO_V1/jts_Kicad/Thru Vertical/JST - XH - Thru (V) - 3Pin - 2.54mm.stp
2. MicroMouse PCB/PCB_AIO_V1/jts_Kicad/Thru Vertical/JST - XH - Thru (V) - 5Pin - 2.54mm.stp
2. MicroMouse PCB/PCB_AIO_V1/jts_Kicad/Thru Vertical/JST - XH - Thru (V) - 6Pin - 2.54mm.stp
2. MicroMouse PCB/PCB_AIO_V1/jts_Kicad/Thru Vertical/JST - XH - Thru (V) - 7Pin - 2.54mm.stp
2. MicroMouse PCB/PCB_AIO_V1/jts_Kicad/Thru Vertical/JST - XH - Thru (V) - 8Pin - 2.54mm.stp
2. MicroMouse PCB/PCB_AIO_V2/3D Model/BM04B-SRSS-TB-white.SLDPRT
3. Drawing/V2.4/V2.4/Assem1.SLDASM
3. Drawing/V2.4/V2.4/Cum Banh 1.SLDPRT
3. Drawing/V2.4/V2.4/Cum Banh 1.STL
3. Drawing/V2.4/V2.4/Cum Banh 2.SLDPRT
3. Drawing/V2.4/V2.4/Cum Banh 2.STL
3. Drawing/V2.4/V2.4/CumBanh1.SLDASM
3. Drawing/V2.4/V2.4/CumBanh2.SLDASM
3. Drawing/V2.4/V2.4/CumCamBien.SLDASM
3. Drawing/V2.4/V2.4/GP2Y0A41SK0F.SLDPRT
3. Drawing/V2.4/V2.4/Ga encoder 1.SLDPRT
3. Drawing/V2.4/V2.4/Ga encoder 1.STL
3. Drawing/V2.4/V2.4/Ga encoder 2.SLDPRT
3. Drawing/V2.4/V2.4/Ga encoder 2.STL
3. Drawing/V2.4/V2.4/Ga nam chamV3.1.SLDPRT
3. Drawing/V2.4/V2.4/Ga nam chamV3.1.STL
3. Drawing/V2.4/V2.4/Ga nam chamV3.SLDPRT
3. Drawing/V2.4/V2.4/Ga nam chamV3.STL
3. Drawing/V2.4/V2.4/GaCamBien.SLDPRT
3. Drawing/V2.4/V2.4/Lop banh xe.SLDPRT
3. Drawing/V2.4/V2.4/MT6701 Ver2.1.SLDPRT
3. Drawing/V2.4/V2.4/MT6701 Ver2.SLDPRT
3. Drawing/V2.4/V2.4/N20 DC MOTOR Truc dai.SLDPRT
3. Drawing/V2.4/V2.4/Nam cham.SLDPRT
3. Drawing/V2.4/V2.4/Part2.SLDPRT
3. Drawing/V2.4/V2.4/Part4.SLDPRT
3. Drawing/V2.4/V2.4/Part4.STL
3. Drawing/V2.4/V2.4/Pin.SLDPRT
3. Drawing/V2.4/V2.4/SHARP GP2Y0A51SK0F.SLDPRT
3. Drawing/V2.4/V2.4/Spur gear 0.5M 38T.SLDPRT
3. Drawing/V2.4/V2.4/Tach 1.SLDPRT
3. Drawing/V2.4/V2.4/Tach 2.SLDPRT
3. Drawing/V2.4/V2.4/Tach 3.SLDPRT
3. Drawing/V2.4/V2.4/Tach 4.SLDPRT
3. Drawing/V2.4/V2.4/Truc 2x20.SLDPRT
3. Drawing/V2.4/V2.4/Vong bi 2x5x2.5.SLDPRT
3. Drawing/V2.4/V2.4/op sensor v2.SLDPRT
3. Drawing/v8/GP2Y0A41SK0F.SLDPRT
