anmh1205/AML_MicroMouse_2024/0. Example/3. ST-Link 2.1-2/Board Assembly/Board Assembly-ST-Link V2-1_2.4.pdf

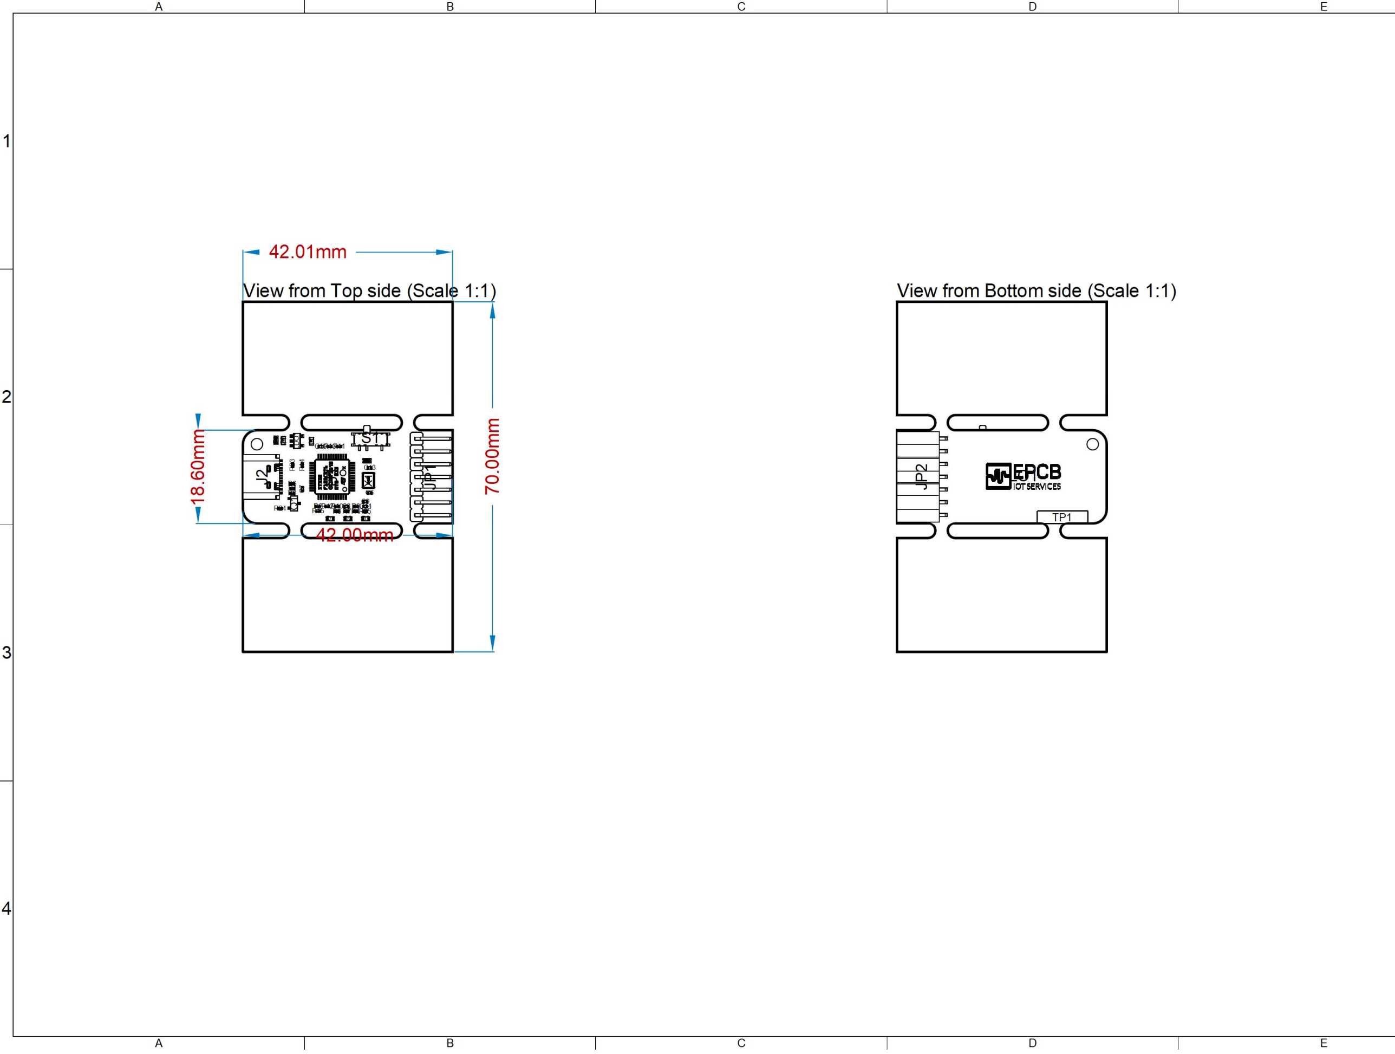
[picture p105: page 1]
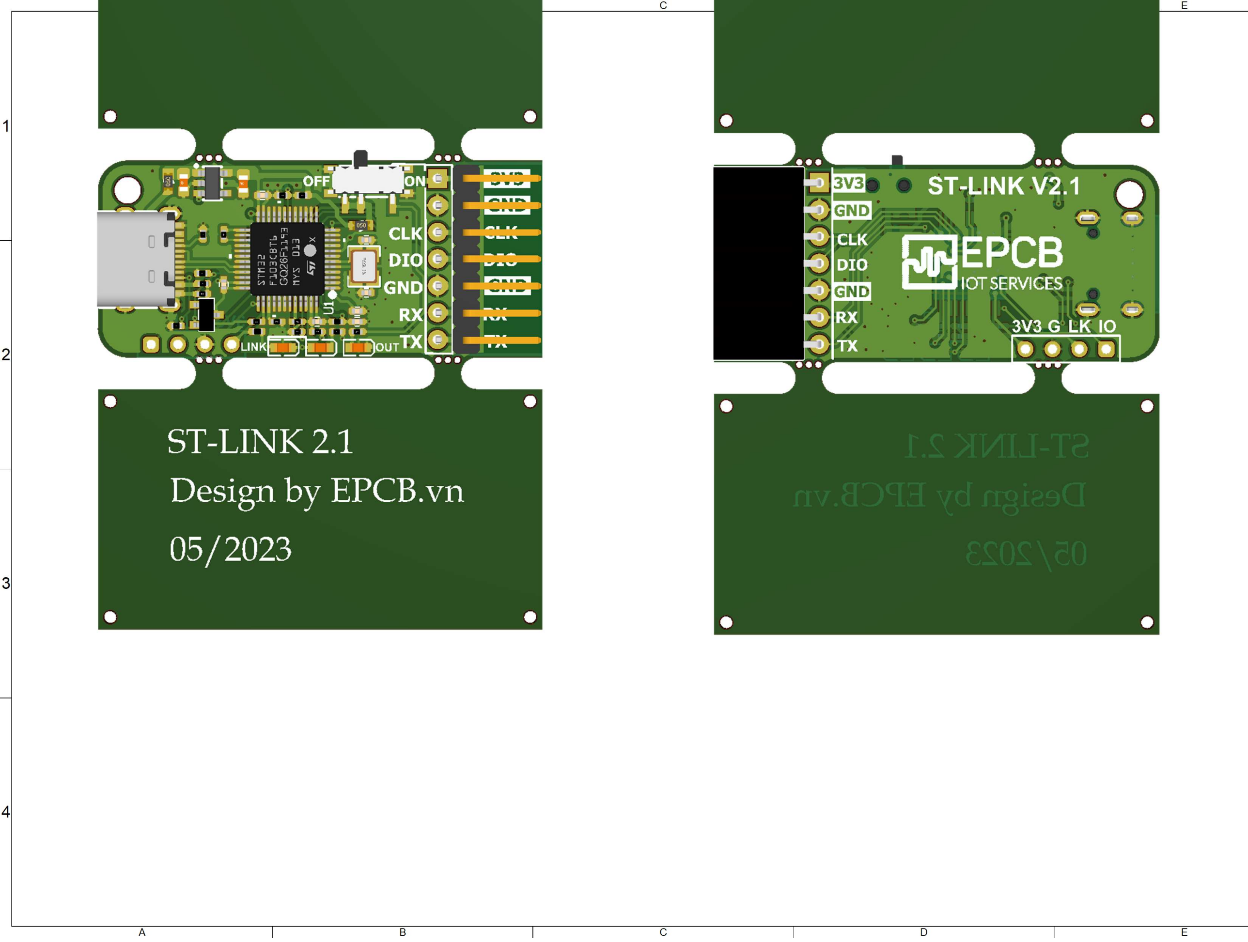
[picture p106: page 2]
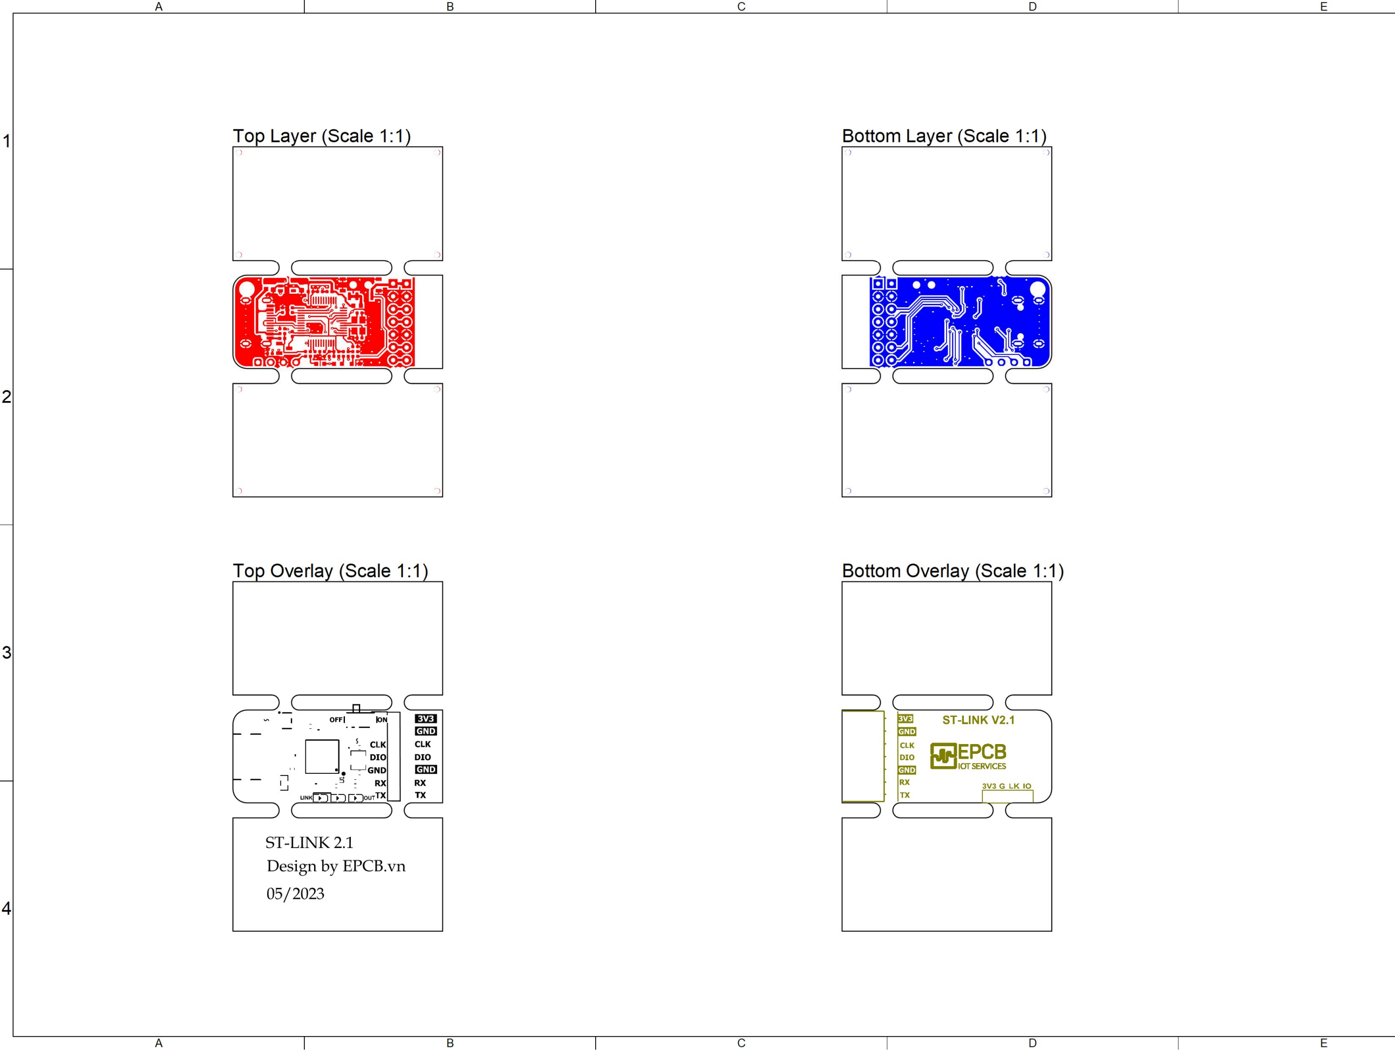
[picture p107: page 3]
