anmh1205/AML_MicroMouse_2024/0. Example/3. ST-Link 2.1-2/Manufacturing/capture-2023-10-17T05_56_34.887Z.png

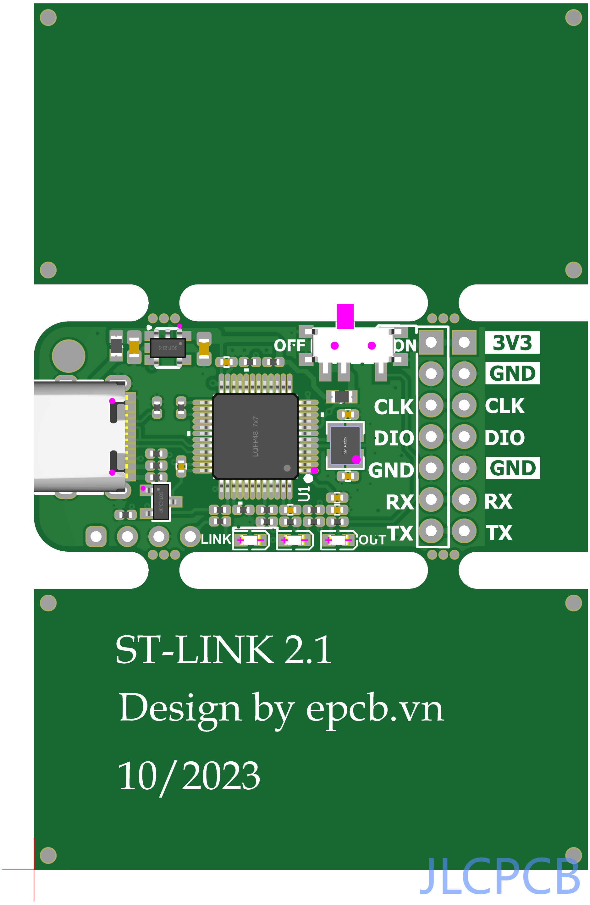
0. Example/3. ST-Link 2.1-2/Manufacturing/capture-2023-10-17T05_56_34.887Z.png
