anmh1205/AML_MicroMouse_2024/0. Example/3. ST-Link 2.1-2/Schematic/Schematic_ST-Link V2-1_2.4.pdf

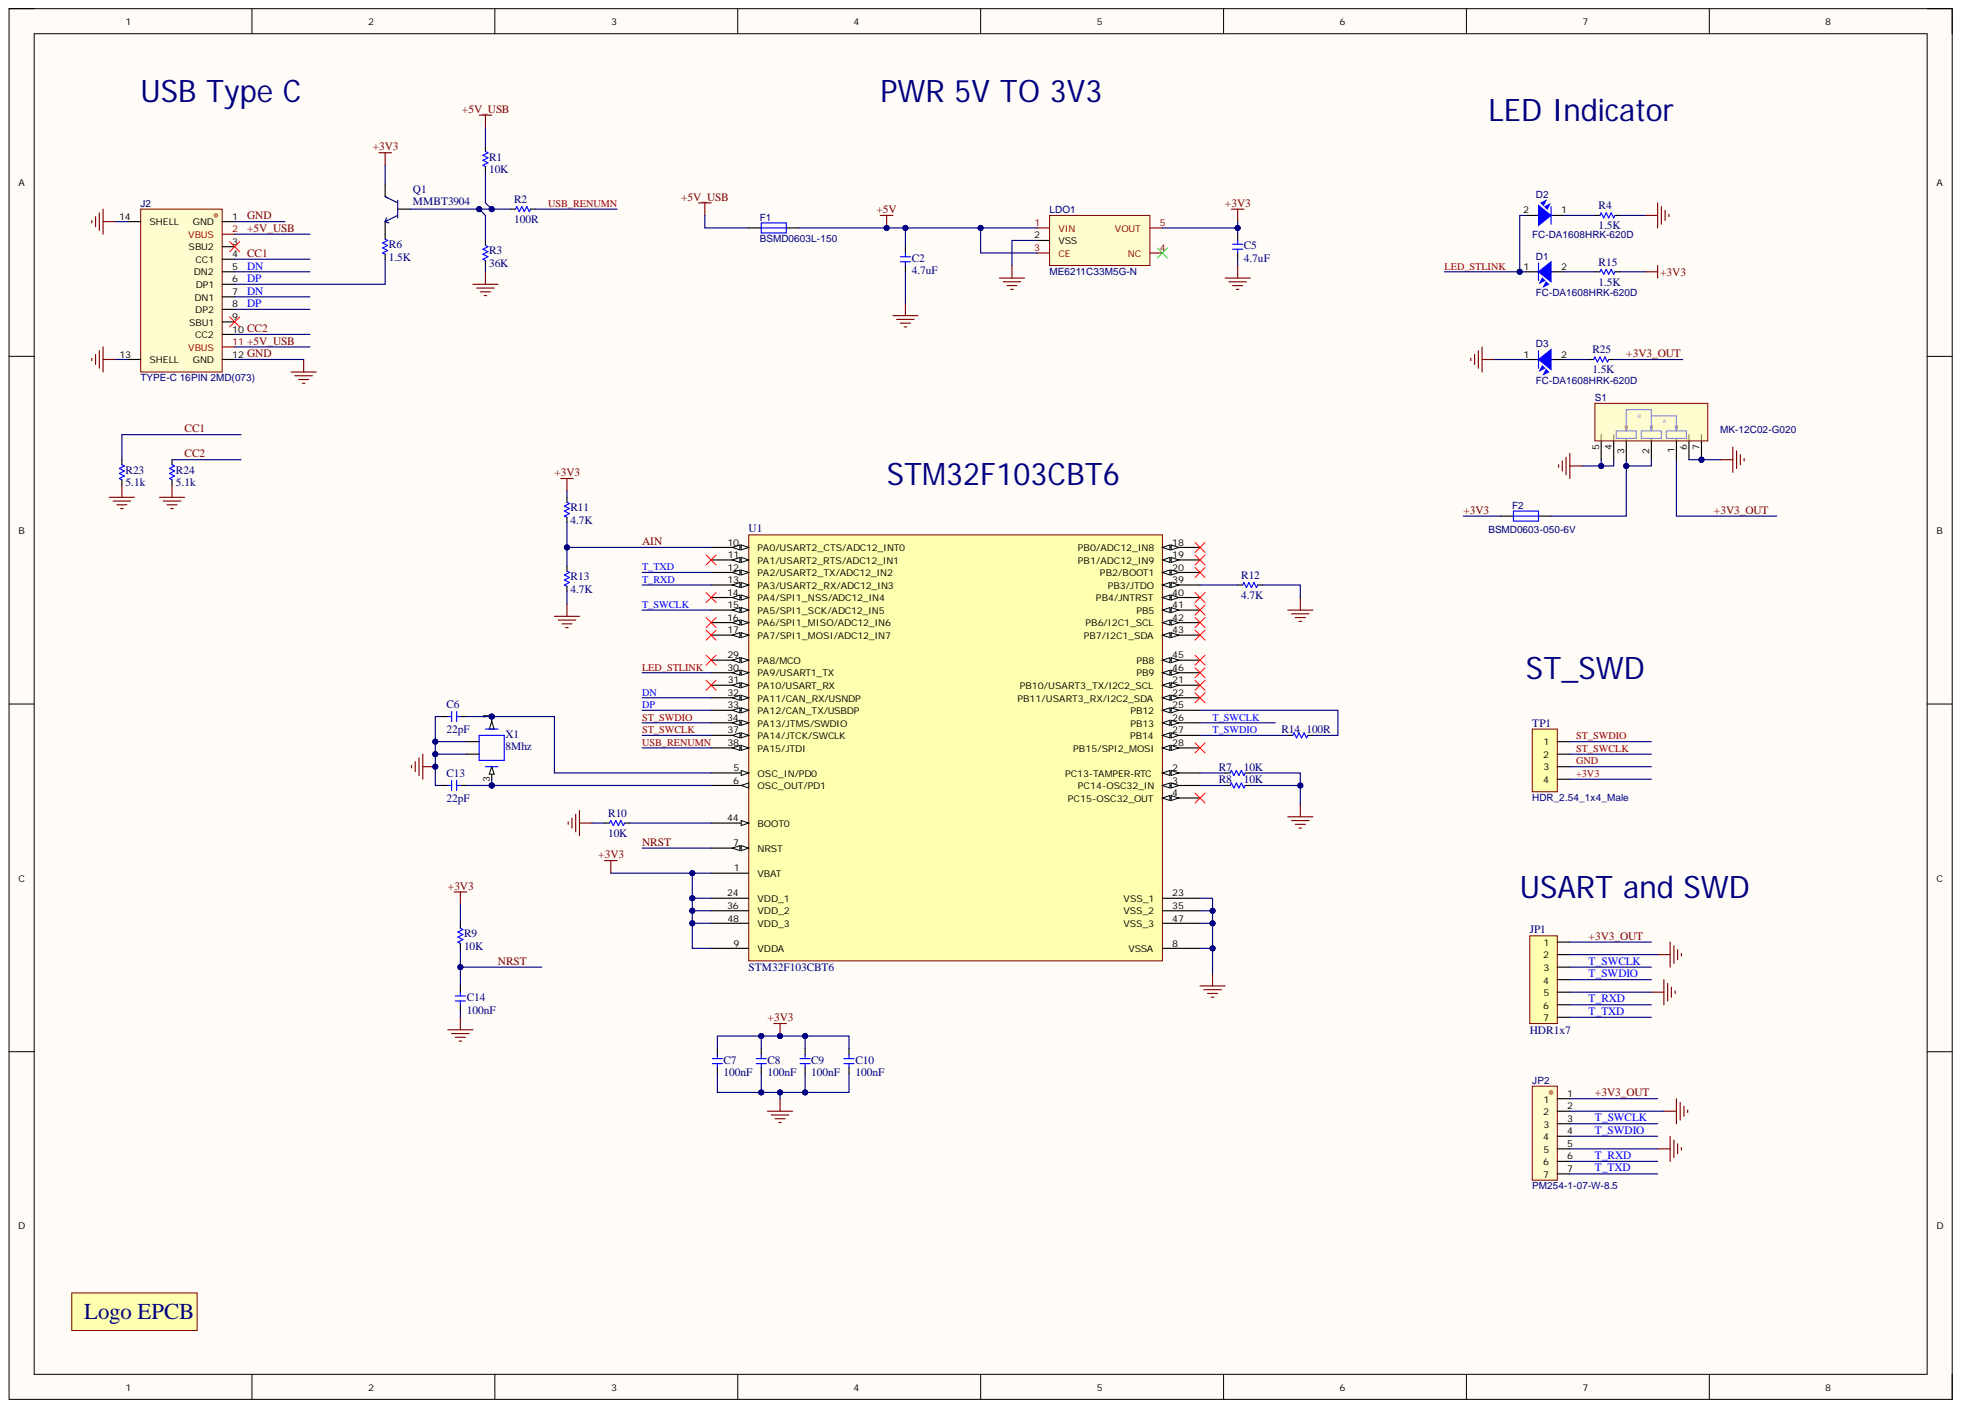
[picture p109: page 1]

VDD_1 24
VDD_2 36
VDD_3 48

VDDA 9

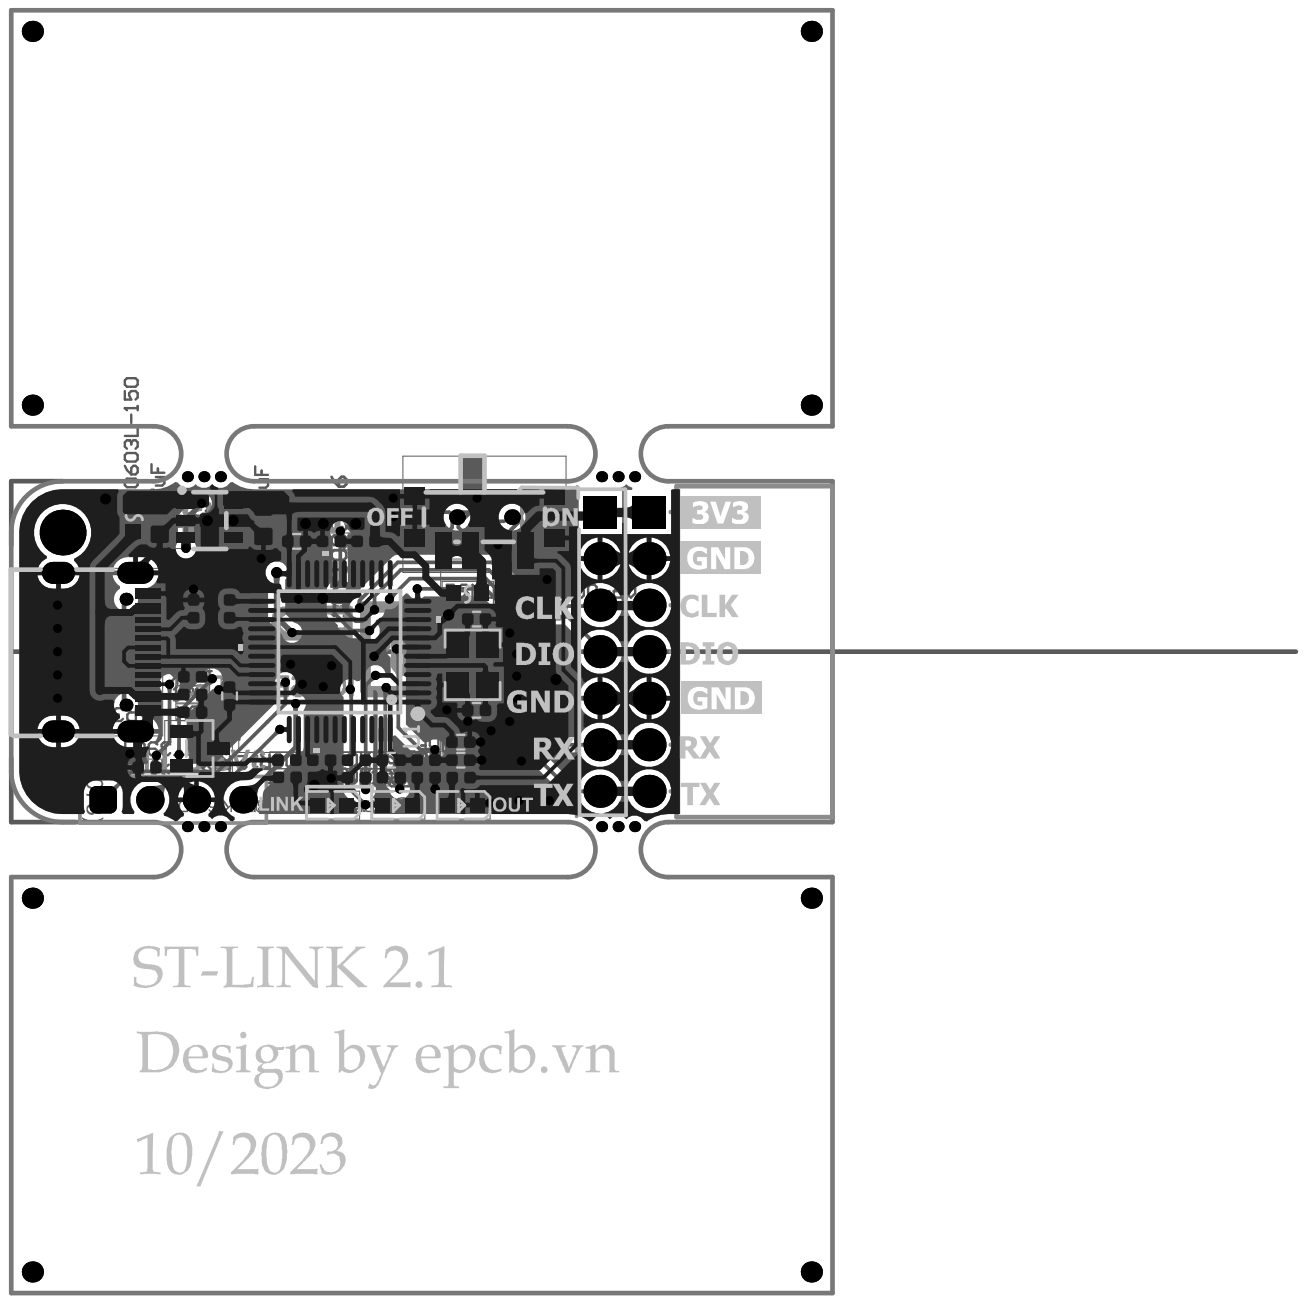
[picture p110: page 2]
