anmh1205/AML_MicroMouse_2024/(list of files, drawings)

Other design files:
0. Example/piccola-master/piccolaAltium/piccaloSchematic.SchDoc
0. Example/piccola-master/piccolaAltium/piccolaAltium.PrjPcb
0. Example/piccola-master/piccolaAltium/piccolaPCB.PcbDoc
0. Example/piccola-master/piccolaPowerSupply/piccolaPowerPCB.PcbDoc
0. Example/piccola-master/piccolaPowerSupply/piccolaPowerSupply.PrjPcb
0. Example/piccola-master/piccolaPowerSupply/piccolaPowerSupply.SchDoc
0. Example/WolfieMouse-RTOS/hardware/kicad_wolfiemouse/micromouse.dsn
2. MicroMouse PCB/PCB_AIO_V1/PCB_AIO_V1.dsn
2. MicroMouse PCB/PCB_AIO_V1/PCB_AIO_V1_2.dsn
2. MicroMouse PCB/PCB_AIO_V2/PCB_AIO_V2.dsn
2. MicroMouse PCB/V1/PCB_T2/freerouting.dsn
2. MicroMouse PCB/V1/PCB_T2/PCB_T2.dsn
2. MicroMouse PCB/V1/PCB_T2/PCB_T2_fr.dsn
2. MicroMouse PCB/V1/PCB_T2/PCB_T2_kicad.dsn
2. MicroMouse PCB/V1/PCB_T2/temp-freerouting.dsn
