anmh1205/AML_MicroMouse_2024/2. MicroMouse PCB/PCB_AIO_V2/PCB_AIO_V2.kicad_pcb

## KiCad design 2. MicroMouse PCB/PCB_AIO_V2/PCB_AIO_V2.kicad_pcb (2024-11-05)

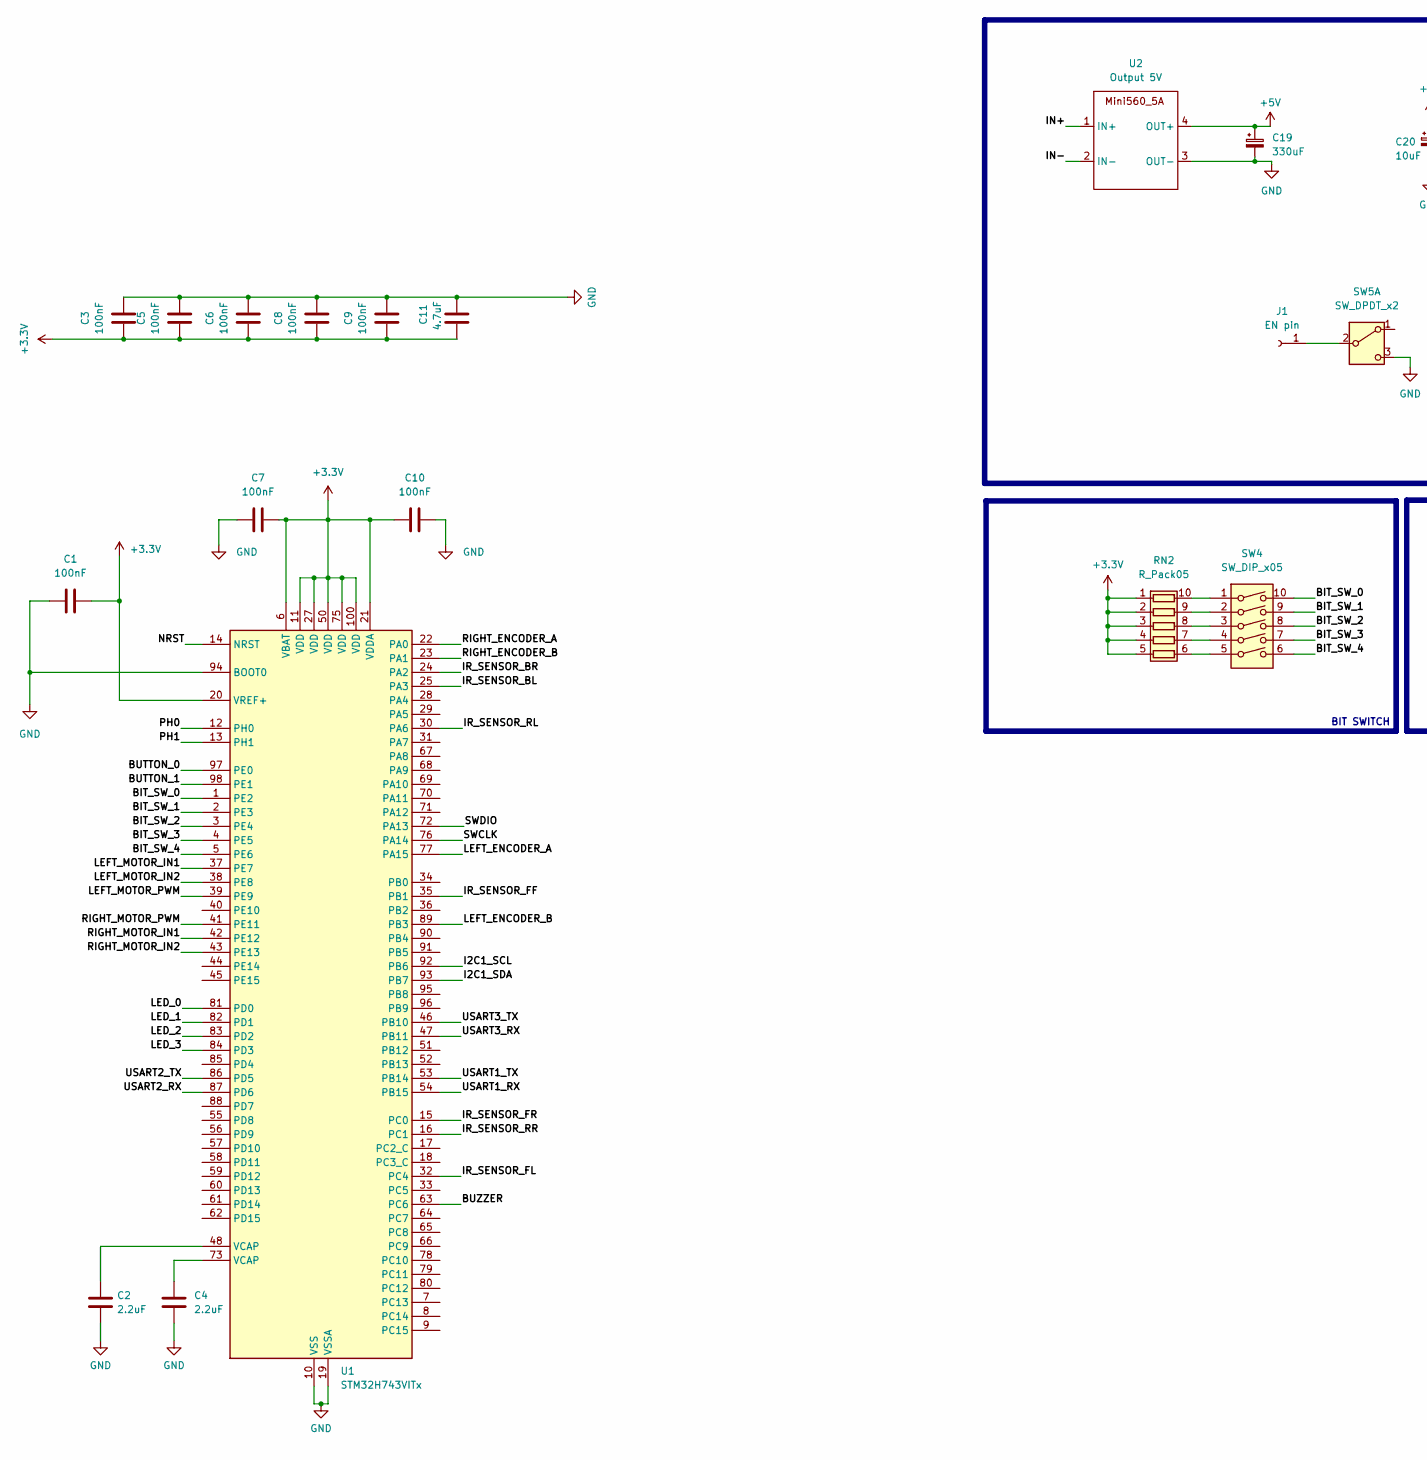
[picture p111: schematic PCB_AIO_V2.kicad_sch, part in row 1, column 1]

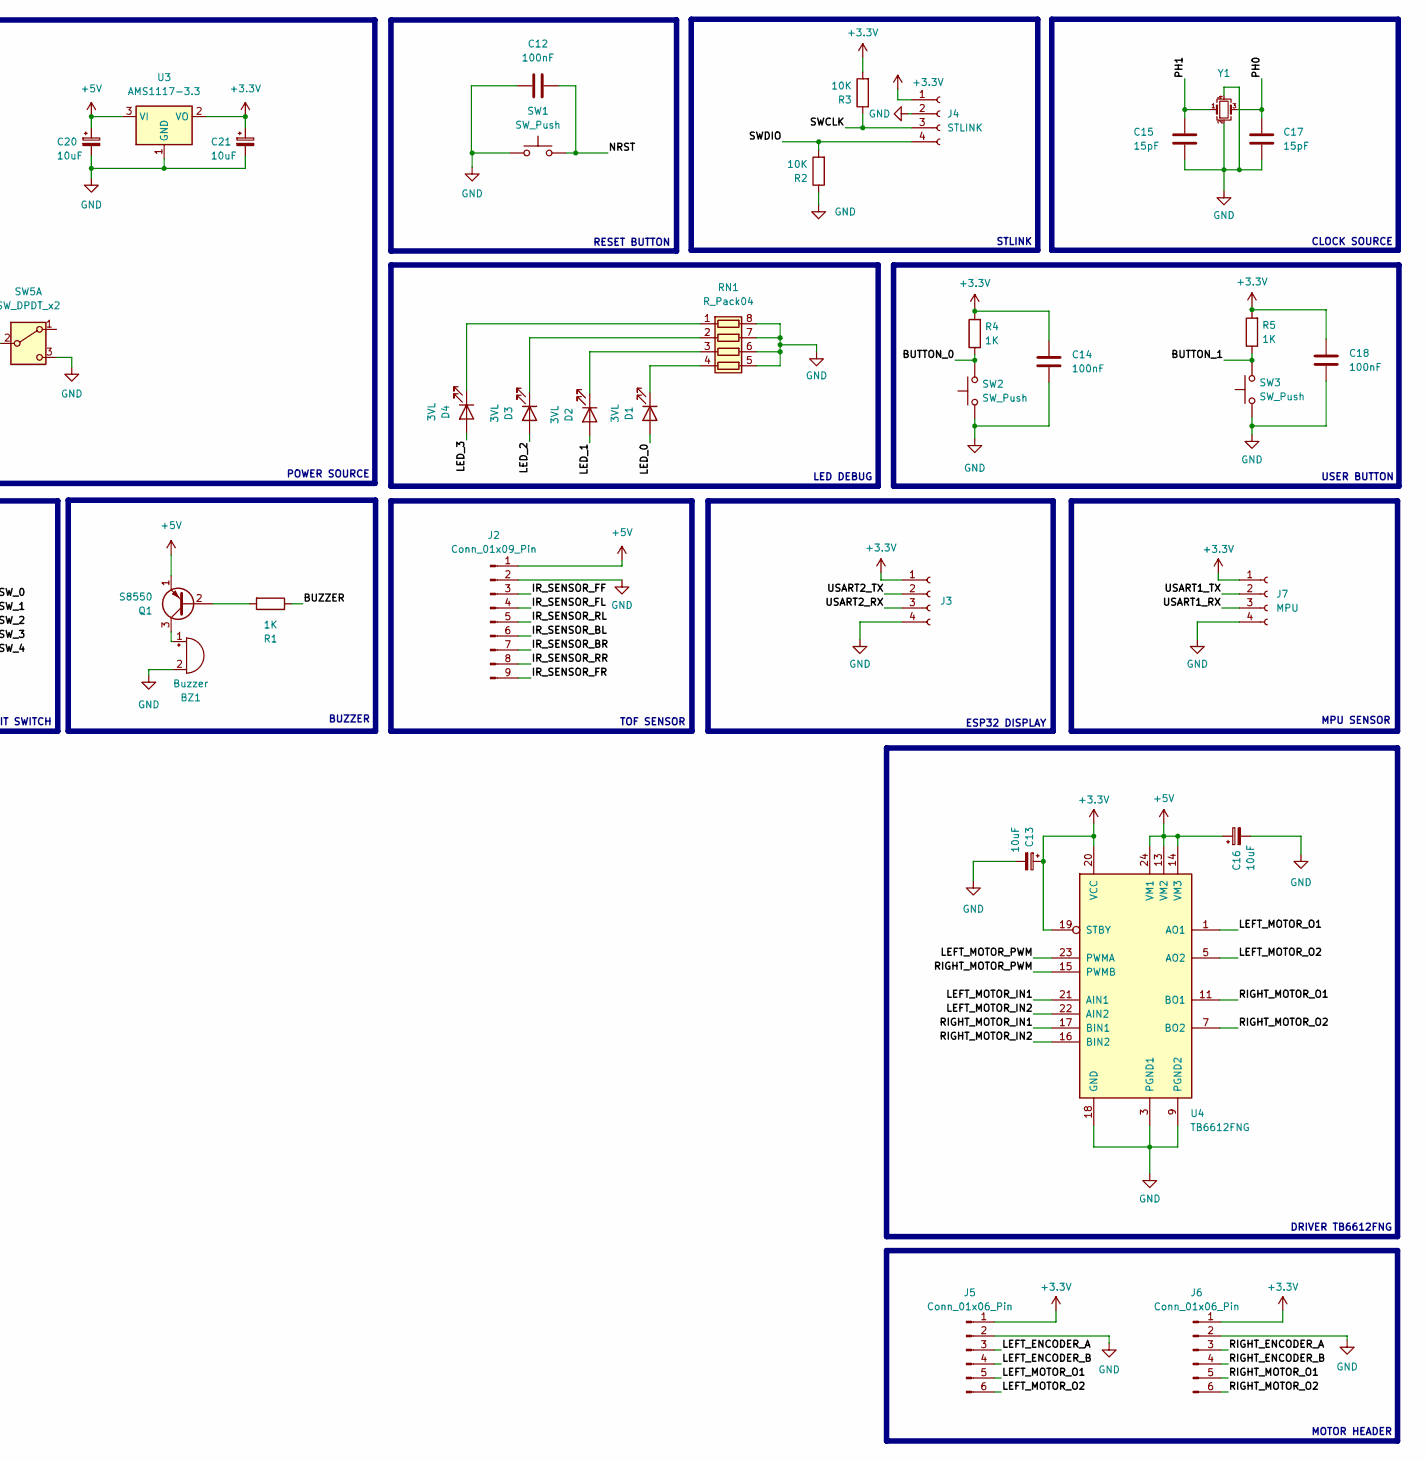
[picture p112: schematic PCB_AIO_V2.kicad_sch, part in row 1, column 2]

Parts:
BZ1: Buzzer; MagneticBuzzer_CUI_CMT-8504-100-SMT
C1, C3, C5, C6, C7, C8, C9, C10, C12, C14, C18: 100nF; C_0603_1608Metric
C2, C4: 2.2uF; CP_EIA-3216-10_Kemet-I
C11: 4.7uF; CP_EIA-3216-10_Kemet-I
C13, C16: 10uF; C_0603_1608Metric
C15, C17: 15pF; C_0603_1608Metric
C19: 330uF; CP_EIA-7343-20_Kemet-V
C20, C21: 10uF; CP_EIA-3216-10_Kemet-I
D1, D2, D3, D4: 3VL; LED_0603_1608Metric
J1: EN pin; PinHeader_1x01_P2.54mm_Vertical
J2: Conn_01x09_Pin; PinHeader_1x09_P2.54mm_Vertical
J3: MPU; JST 4
J4: STLINK; JST 4
J5, J6: Conn_01x06_Pin; JST_SH_BM06B-SRSS-TB_1x06-1MP_P1.00mm_Vertical
J7: MPU; PinHeader_1x04_P2.54mm_Vertical
Q1: S8550; SOT-23
R1, R4, R5: 1K; R_0603_1608Metric
R2, R3: 10K; R_0603_1608Metric
RN1: R_Pack04; R_Array_Convex_4x0603
RN2: R_Pack05; R_Array_Convex_5x0603
SW1, SW2, SW3: SW_Push; SW_Tactile_SPST_NO_Straight_CK_PTS636Sx25SMTRLFS
SW4: SW_DIP_x05; SW_DIP_SPSTx05_Slide_KingTek_DSHP05TS_W7.62mm_P1.27mm
SW5: SW_DPDT_x2; SW_SPDT_PCM12
U1: STM32H743VITx; LQFP-100_14x14mm_P0.5mm
U2: Output 5V; Mini560_5A
U3: AMS1117-3.3; SOT-223-3_TabPin2
U4: TB6612FNG; SSOP-24_5.3x8.2mm_P0.65mm
Y1: Crystal_GND24_Small; Crystal_SMD_3225-4Pin_3.2x2.5mm

Connections:
+3.3V: C1.2, C3.1, C5.1, C6.1, C7.2, C8.1, C9.1, C10.1, C11.1, C13.1, C14.2, C18.2, C21.1, J3.1, J4.1, J5.1, J6.1, J7.1, R3.2, R4.2, R5.2, RN2.1 (R1.1), RN2.2 (R2.1), RN2.3 (R3.1), RN2.4 (R4.1), RN2.5 (R5.1), U1.6 (VBAT), U1.11 (VDD), U1.20 (VREF+), U1.21 (VDDA), U1.27 (VDD), U1.50 (VDD), U1.75 (VDD), U1.100 (VDD), U3.2 (VO), U4.19 (STBY), U4.20 (VCC)
+5V: C16.1, C19.1, C20.1, J2.1, Q1.1 (E), U2.4 (OUT+), U3.3 (VI), U4.13 (VM2), U4.14 (VM3), U4.24 (VM1)
/BIT_SW_0: SW4.10, U1.1 (PE2)
/BIT_SW_1: SW4.9, U1.2 (PE3)
/BIT_SW_2: SW4.8, U1.3 (PE4)
/BIT_SW_3: SW4.7, U1.4 (PE5)
/BIT_SW_4: SW4.6, U1.5 (PE6)
/BUTTON_0: R4.1, SW2.2, U1.97 (PE0)
/BUTTON_1: R5.1, SW3.2, U1.98 (PE1)
/BUZZER: R1.1, U1.63 (PC6)
/I2C1_SCL: U1.92 (PB6)
/I2C1_SDA: U1.93 (PB7)
/IN+: U2.1 (IN+)
/IN-: U2.2 (IN-)
/IR_SENSOR_BL: J2.6, U1.25 (PA3)
/IR_SENSOR_BR: J2.7, U1.24 (PA2)
/IR_SENSOR_FF: J2.3, U1.35 (PB1)
/IR_SENSOR_FL: J2.4, U1.32 (PC4)
/IR_SENSOR_FR: J2.9, U1.15 (PC0)
/IR_SENSOR_RL: J2.5, U1.30 (PA6)
/IR_SENSOR_RR: J2.8, U1.16 (PC1)
/LED_0: D1.2 (A), U1.81 (PD0)
/LED_1: D2.2 (A), U1.82 (PD1)
/LED_2: D3.2 (A), U1.83 (PD2)
/LED_3: D4.2 (A), U1.84 (PD3)
/LEFT_ENCODER_A: J5.3, U1.77 (PA15)
/LEFT_ENCODER_B: J5.4, U1.89 (PB3)
/LEFT_MOTOR_IN1: U1.37 (PE7), U4.21 (AIN1)
/LEFT_MOTOR_IN2: U1.38 (PE8), U4.22 (AIN2)
/LEFT_MOTOR_O1: J5.5, U4.1 (AO1), U4.2 (AO1)
/LEFT_MOTOR_O2: J5.6, U4.5 (AO2), U4.6 (AO2)
/LEFT_MOTOR_PWM: U1.39 (PE9), U4.23 (PWMA)
/NRST: C12.2, SW1.2, U1.14 (NRST)
/PH0: C17.2, U1.12 (PH0), Y1.3
/PH1: C15.2, U1.13 (PH1), Y1.1
/RIGHT_ENCODER_A: J6.3, U1.22 (PA0)
/RIGHT_ENCODER_B: J6.4, U1.23 (PA1)
/RIGHT_MOTOR_IN1: U1.42 (PE12), U4.17 (BIN1)
/RIGHT_MOTOR_IN2: U1.43 (PE13), U4.16 (BIN2)
/RIGHT_MOTOR_O1: J6.5, U4.11 (BO1), U4.12 (BO1)
/RIGHT_MOTOR_O2: J6.6, U4.7 (BO2), U4.8 (BO2)
/RIGHT_MOTOR_PWM: U1.41 (PE11), U4.15 (PWMB)
/SWCLK: J4.3, R3.1, U1.76 (PA14)
/SWDIO: J4.4, R2.2, U1.72 (PA13)
/USART1_RX: J7.3, U1.54 (PB15)
/USART1_TX: J7.2, U1.53 (PB14)
/USART2_RX: J3.3, U1.87 (PD6)
/USART2_TX: J3.2, U1.86 (PD5)
/USART3_RX: U1.47 (PB11)
/USART3_TX: U1.46 (PB10)
GND: BZ1.2 (+), C1.1, C2.1, C3.2, C4.1, C5.2, C6.2, C7.1, C8.2, C9.2, C10.2, C11.2, C12.1, C13.2, C14.1, C15.1, C16.2, C17.1, C18.1, C19.2, C20.2, C21.2, J2.2, J3.4, J4.2, J5.2, J6.2, J7.4, R2.1, RN1.5 (R4.2), RN1.6 (R3.2), RN1.7 (R2.2), RN1.8 (R1.2), SW1.1, SW2.1, SW3.1, SW5.3 (C), U1.10 (VSS), U1.19 (VSSA), U1.26 (VSS), U1.49 (VSS), U1.74 (VSS), U1.94 (BOOT0), U1.99 (VSS), U2.3 (OUT-), U3.1 (GND), U4.3 (PGND1), U4.4 (PGND1), U4.9 (PGND2), U4.10 (PGND2), U4.18 (GND), Y1.2, Y1.4
unnamed: BZ1.1 (-), Q1.3 (C)
unnamed: C2.2, U1.48 (VCAP)
unnamed: C4.2, U1.73 (VCAP)
unnamed: D1.1 (K), RN1.4 (R4.1)
unnamed: D2.1 (K), RN1.3 (R3.1)
unnamed: D3.1 (K), RN1.2 (R2.1)
unnamed: D4.1 (K), RN1.1 (R1.1)
unnamed: J1.1, SW5.2 (B)
unnamed: Q1.2 (B), R1.2
unnamed: RN2.10 (R1.2), SW4.1
unnamed: RN2.9 (R2.2), SW4.2
unnamed: RN2.8 (R3.2), SW4.3
unnamed: RN2.7 (R4.2), SW4.4
unnamed: RN2.6 (R5.2), SW4.5

Notes on the sheet:
DRIVER TB6612FNG
ESP32 DISPLAY
BIT SWITCH
BUZZER
RESET BUTTON
MPU SENSOR
POWER SOURCE
MOTOR HEADER
STLINK
TOF SENSOR
LED DEBUG
CLOCK SOURCE
USER BUTTON

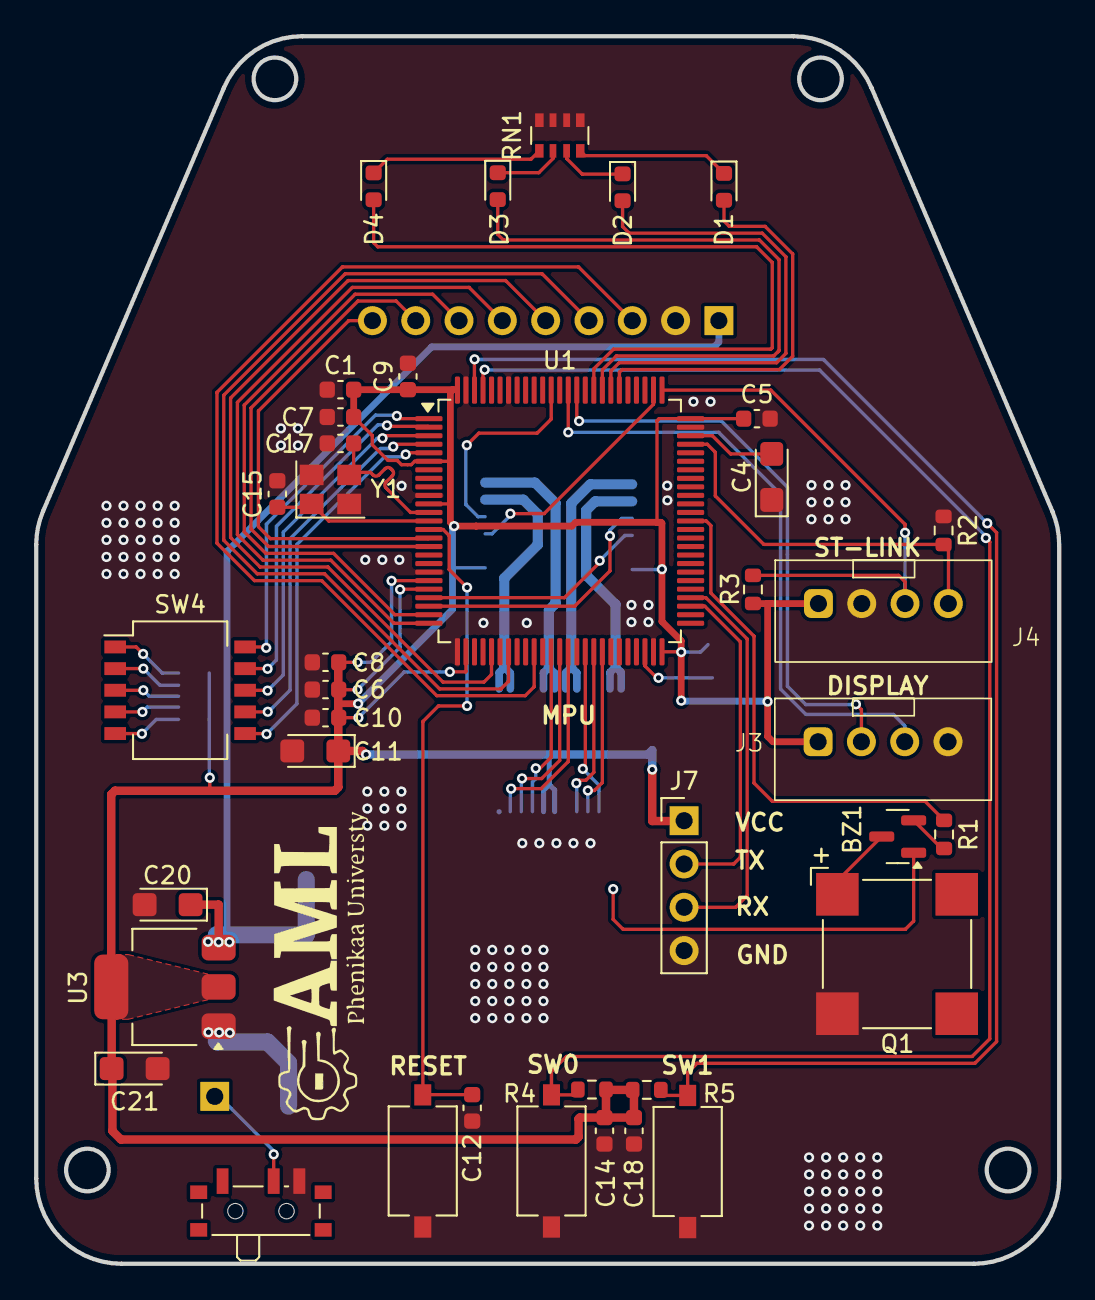
[picture p113: board PCB_AIO_V2.kicad_pcb from above]

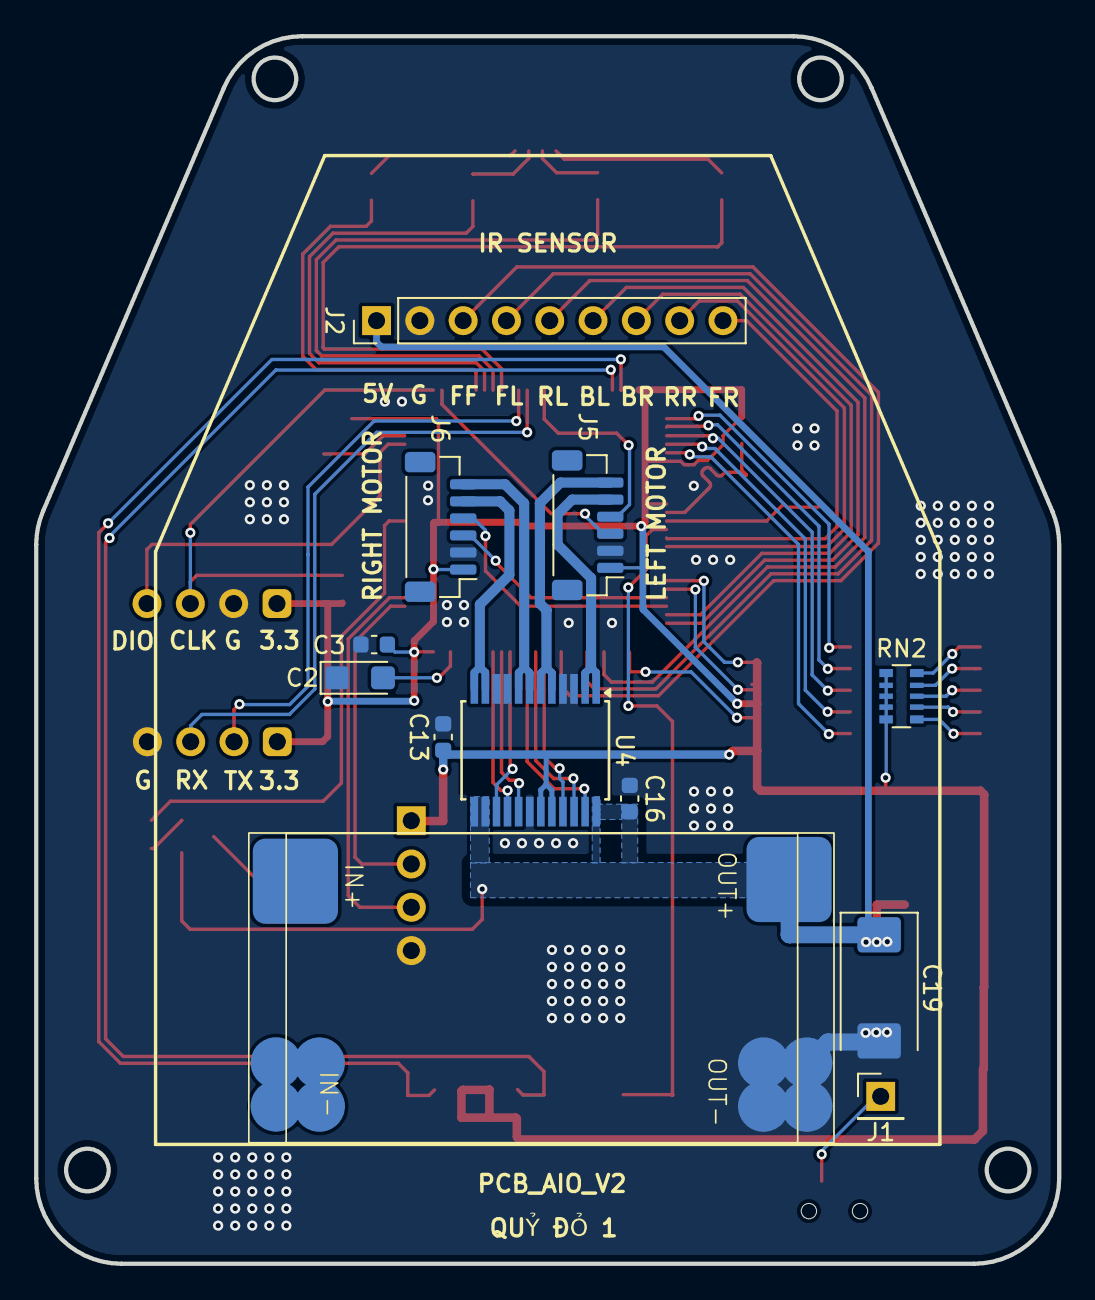
[picture p114: board PCB_AIO_V2.kicad_pcb from below]

Board: 2 copper layers, 60.0 x 72.0 mm, 51 parts (12 on the bottom side), 59 nets.
