anmh1205/AML_MicroMouse_2024/2. MicroMouse PCB/PCB_AIO_V1/PCB_AIO_V1.kicad_pcb

## KiCad design 2. MicroMouse PCB/PCB_AIO_V1/PCB_AIO_V1.kicad_pcb (2024-11-05, an earlier design)

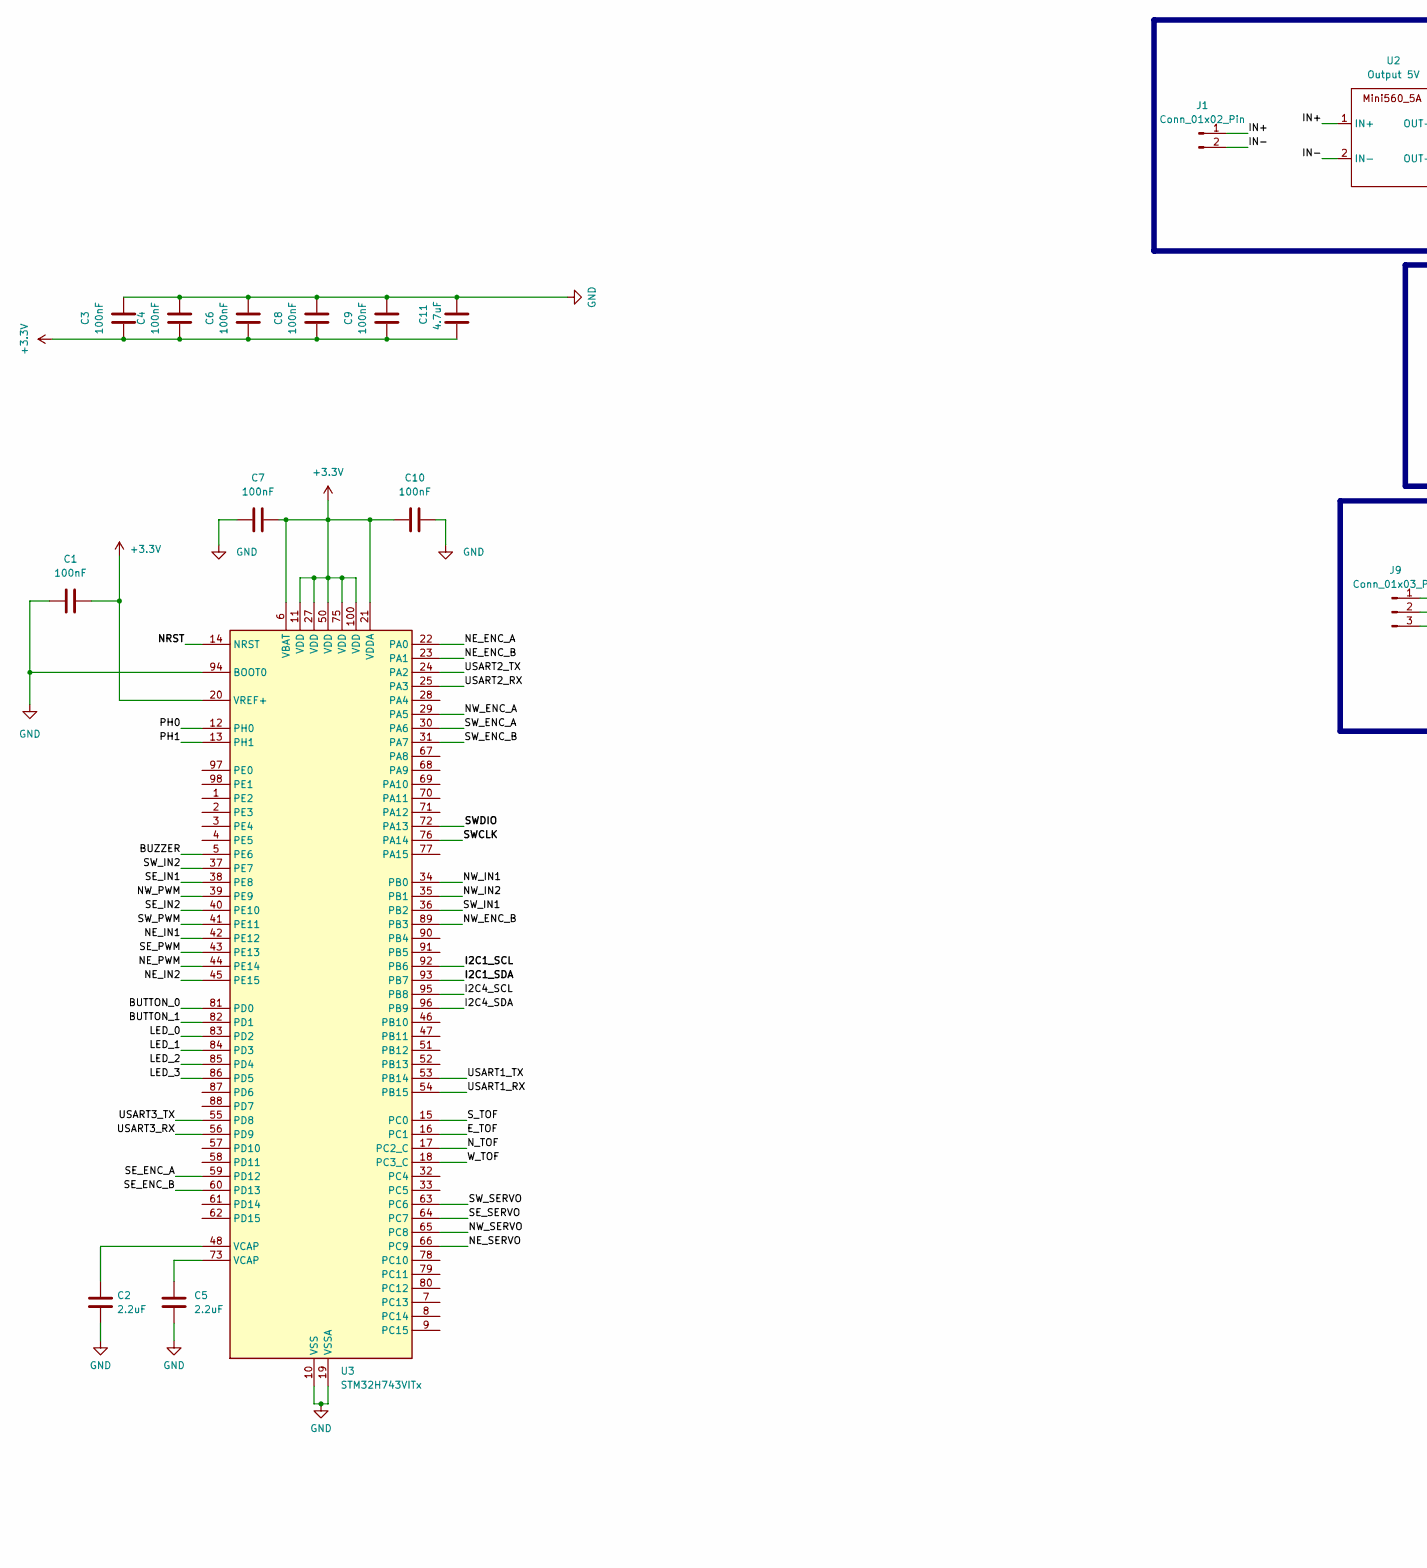
[picture p115: schematic PCB_AIO_V1.kicad_sch, part in row 1, column 1]

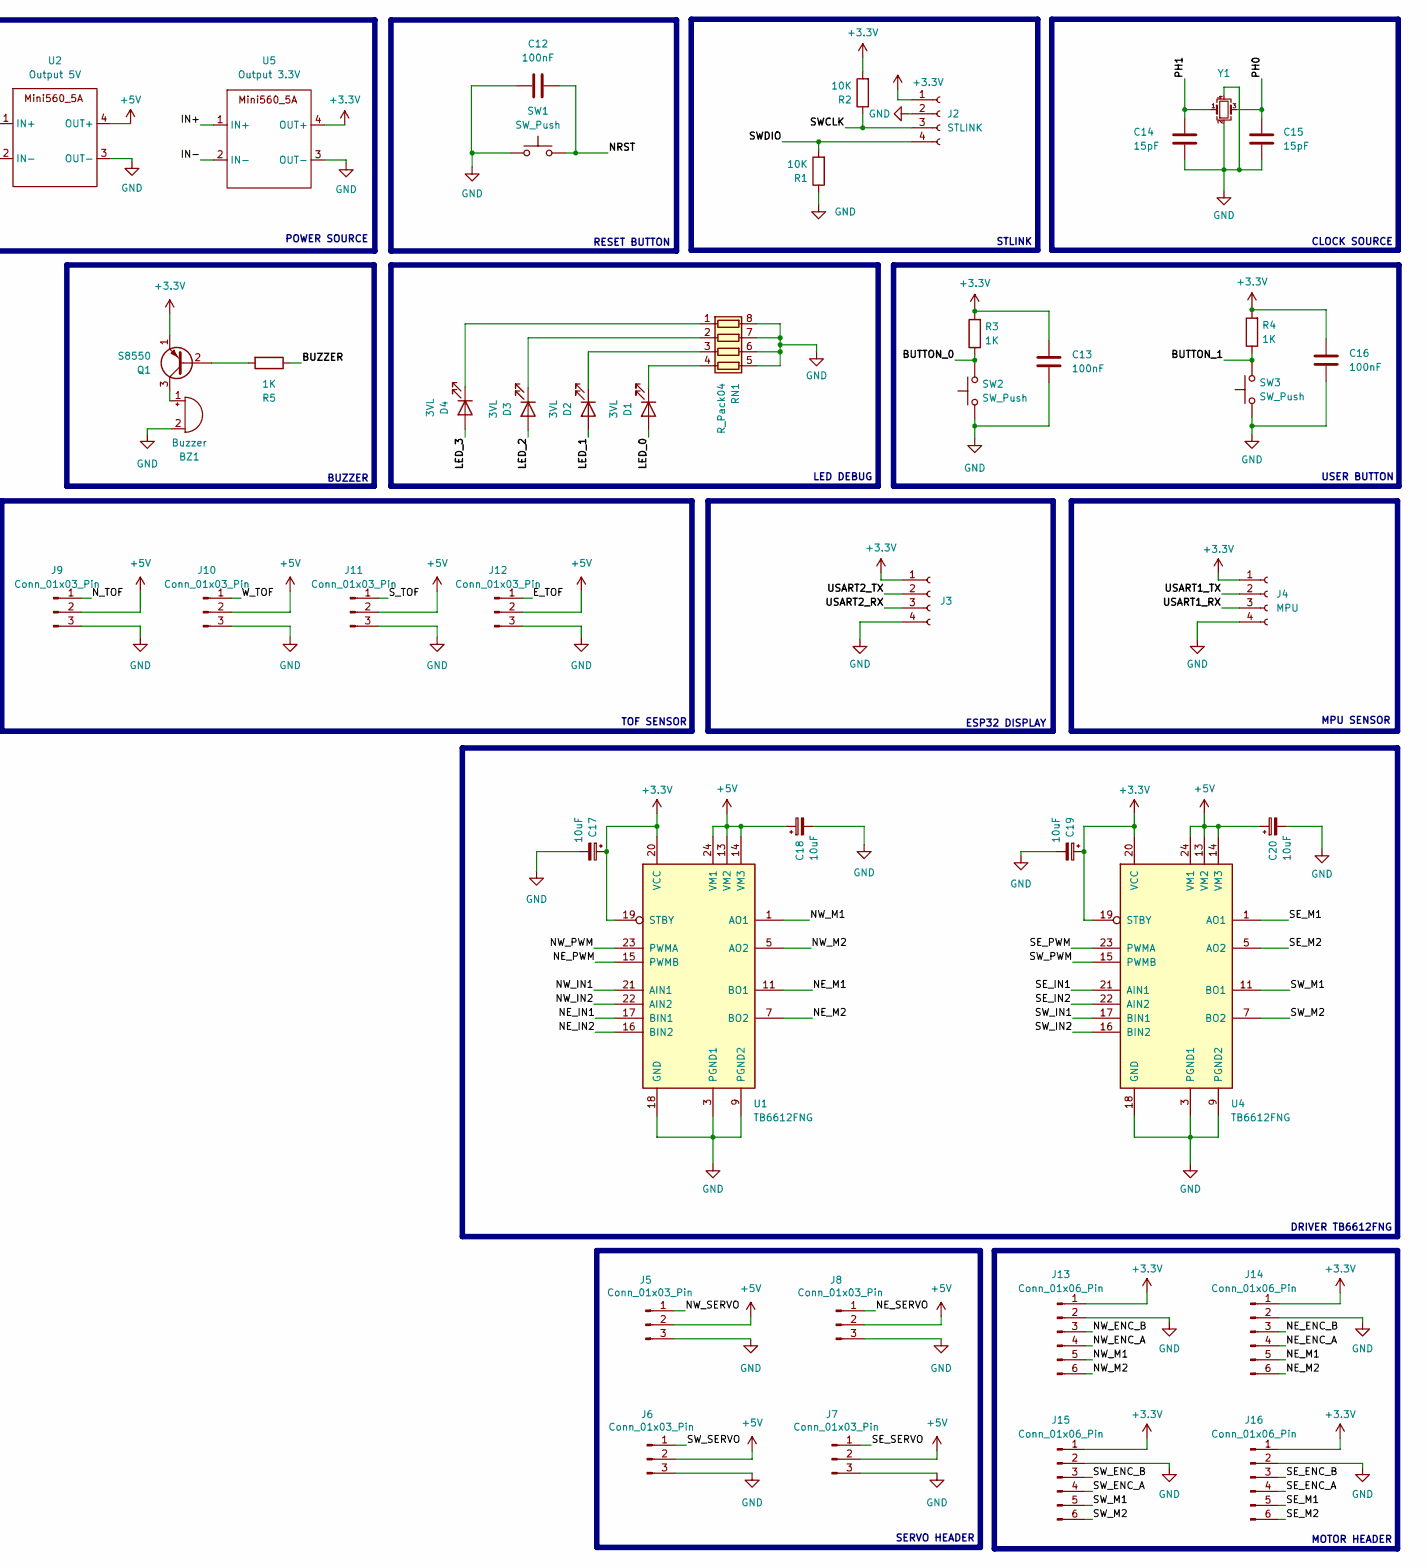
[picture p116: schematic PCB_AIO_V1.kicad_sch, part in row 1, column 2]

Parts:
BZ1: Buzzer; MagneticBuzzer_CUI_CMT-8504-100-SMT
C1, C3, C4, C6, C7, C8, C9, C10, C12, C13, C16: 100nF; C_0402_1005Metric
C2, C5: 2.2uF; CP_EIA-3216-10_Kemet-I
C11: 4.7uF; CP_EIA-3216-10_Kemet-I
C14, C15: 15pF; C_0402_1005Metric
C17, C18, C19, C20: 10uF; C_0603_1608Metric
D1, D2, D3, D4: 3VL; LED_0603_1608Metric
J1: Conn_01x02_Pin; JST_VH_B2P-VH-B_1x02_P3.96mm_Vertical
J2: STLINK; JST_SH_BM04B-SRSS-TB_1x04-1MP_P1.00mm_Vertical
J3: MPU; JST_SH_BM04B-SRSS-TB_1x04-1MP_P1.00mm_Vertical
J4: MPU; PinHeader_1x04_P2.54mm_Vertical
J5, J6, J7, J8: Conn_01x03_Pin; JST_SH_BM03B-SRSS-TB_1x03-1MP_P1.00mm_Vertical
J9, J10, J11, J12: Conn_01x03_Pin; JST_SH_SM03B-SRSS-TB_1x03-1MP_P1.00mm_Horizontal
J13, J14, J15, J16: Conn_01x06_Pin; JST_GH_SM06B-GHS-TB_1x06-1MP_P1.25mm_Horizontal
Q1: S8550; SOT-23
R1, R2: 10K; R_0402_1005Metric
R3, R4, R5: 1K; R_0402_1005Metric
RN1: R_Pack04; R_Array_Convex_4x0603
SW1, SW2, SW3: SW_Push; SW_Tactile_SPST_NO_Straight_CK_PTS636Sx25SMTRLFS
U1, U4: TB6612FNG; SSOP-24_5.3x8.2mm_P0.65mm
U2: Output 5V; Mini560_5A
U3: STM32H743VITx; LQFP-100_14x14mm_P0.5mm
U5: Output 3.3V; Mini560_5A
Y1: Crystal_GND24_Small; Crystal_SMD_3225-4Pin_3.2x2.5mm

Connections:
+3.3V: C1.2, C3.1, C4.1, C6.1, C7.2, C8.1, C9.1, C10.1, C11.1, C13.2, C16.2, C17.1, C19.1, J2.1, J3.1, J4.1, J13.1, J14.1, J15.1, J16.1, Q1.1 (E), R2.2, R3.2, R4.2, U1.19 (STBY), U1.20 (VCC), U3.6 (VBAT), U3.11 (VDD), U3.20 (VREF+), U3.21 (VDDA), U3.27 (VDD), U3.50 (VDD), U3.75 (VDD), U3.100 (VDD), U4.19 (STBY), U4.20 (VCC), U5.4 (OUT+)
+5V: C18.1, C20.1, J5.2, J6.2, J7.2, J8.2, J9.2, J10.2, J11.2, J12.2, U1.13 (VM2), U1.14 (VM3), U1.24 (VM1), U2.4 (OUT+), U4.13 (VM2), U4.14 (VM3), U4.24 (VM1)
/BUTTON_0: R3.1, SW2.2, U3.81 (PD0)
/BUTTON_1: R4.1, SW3.2, U3.82 (PD1)
/BUZZER: R5.1, U3.5 (PE6)
/E_TOF: J12.1, U3.16 (PC1)
/I2C1_SCL: U3.92 (PB6)
/I2C1_SDA: U3.93 (PB7)
/I2C4_SCL: U3.95 (PB8)
/I2C4_SDA: U3.96 (PB9)
/IN+: J1.1, U2.1 (IN+), U5.1 (IN+)
/IN-: J1.2, U2.2 (IN-), U5.2 (IN-)
/LED_0: D1.2 (A), U3.83 (PD2)
/LED_1: D2.2 (A), U3.84 (PD3)
/LED_2: D3.2 (A), U3.85 (PD4)
/LED_3: D4.2 (A), U3.86 (PD5)
/NE_ENC_A: J14.4, U3.22 (PA0)
/NE_ENC_B: J14.3, U3.23 (PA1)
/NE_IN1: U1.17 (BIN1), U3.42 (PE12)
/NE_IN2: U1.16 (BIN2), U3.45 (PE15)
/NE_M1: J14.5, U1.11 (BO1), U1.12 (BO1)
/NE_M2: J14.6, U1.7 (BO2), U1.8 (BO2)
/NE_PWM: U1.15 (PWMB), U3.44 (PE14)
/NE_SERVO: J8.1, U3.66 (PC9)
/NRST: C12.2, SW1.2, U3.14 (NRST)
/NW_ENC_A: J13.4, U3.29 (PA5)
/NW_ENC_B: J13.3, U3.89 (PB3)
/NW_IN1: U1.21 (AIN1), U3.34 (PB0)
/NW_IN2: U1.22 (AIN2), U3.35 (PB1)
/NW_M1: J13.5, U1.1 (AO1), U1.2 (AO1)
/NW_M2: J13.6, U1.5 (AO2), U1.6 (AO2)
/NW_PWM: U1.23 (PWMA), U3.39 (PE9)
/NW_SERVO: J5.1, U3.65 (PC8)
/N_TOF: J9.1, U3.17 (PC2_C)
/PH0: C15.2, U3.12 (PH0), Y1.3
/PH1: C14.2, U3.13 (PH1), Y1.1
/SE_ENC_A: J16.4, U3.59 (PD12)
/SE_ENC_B: J16.3, U3.60 (PD13)
/SE_IN1: U3.38 (PE8), U4.21 (AIN1)
/SE_IN2: U3.40 (PE10), U4.22 (AIN2)
/SE_M1: J16.5, U4.1 (AO1), U4.2 (AO1)
/SE_M2: J16.6, U4.5 (AO2), U4.6 (AO2)
/SE_PWM: U3.43 (PE13), U4.23 (PWMA)
/SE_SERVO: J7.1, U3.64 (PC7)
/SWCLK: J2.3, R2.1, U3.76 (PA14)
/SWDIO: J2.4, R1.2, U3.72 (PA13)
/SW_ENC_A: J15.4, U3.30 (PA6)
/SW_ENC_B: J15.3, U3.31 (PA7)
/SW_IN1: U3.36 (PB2), U4.17 (BIN1)
/SW_IN2: U3.37 (PE7), U4.16 (BIN2)
/SW_M1: J15.5, U4.11 (BO1), U4.12 (BO1)
/SW_M2: J15.6, U4.7 (BO2), U4.8 (BO2)
/SW_PWM: U3.41 (PE11), U4.15 (PWMB)
/SW_SERVO: J6.1, U3.63 (PC6)
/S_TOF: J11.1, U3.15 (PC0)
/USART1_RX: J4.3, U3.54 (PB15)
/USART1_TX: J4.2, U3.53 (PB14)
/USART2_RX: J3.3, U3.25 (PA3)
/USART2_TX: J3.2, U3.24 (PA2)
/USART3_RX: U3.56 (PD9)
/USART3_TX: U3.55 (PD8)
/W_TOF: J10.1, U3.18 (PC3_C)
GND: BZ1.2 (+), C1.1, C2.1, C3.2, C4.2, C5.1, C6.2, C7.1, C8.2, C9.2, C10.2, C11.2, C12.1, C13.1, C14.1, C15.1, C16.1, C17.2, C18.2, C19.2, C20.2, J2.2, J3.4, J4.4, J5.3, J6.3, J7.3, J8.3, J9.3, J10.3, J11.3, J12.3, J13.2, J14.2, J15.2, J16.2, R1.1, RN1.5 (R4.2), RN1.6 (R3.2), RN1.7 (R2.2), RN1.8 (R1.2), SW1.1, SW2.1, SW3.1, U1.3 (PGND1), U1.4 (PGND1), U1.9 (PGND2), U1.10 (PGND2), U1.18 (GND), U2.3 (OUT-), U3.10 (VSS), U3.19 (VSSA), U3.26 (VSS), U3.49 (VSS), U3.74 (VSS), U3.94 (BOOT0), U3.99 (VSS), U4.3 (PGND1), U4.4 (PGND1), U4.9 (PGND2), U4.10 (PGND2), U4.18 (GND), U5.3 (OUT-), Y1.2, Y1.4
unnamed: BZ1.1 (-), Q1.3 (C)
unnamed: C2.2, U3.48 (VCAP)
unnamed: C5.2, U3.73 (VCAP)
unnamed: D1.1 (K), RN1.4 (R4.1)
unnamed: D2.1 (K), RN1.3 (R3.1)
unnamed: D3.1 (K), RN1.2 (R2.1)
unnamed: D4.1 (K), RN1.1 (R1.1)
unnamed: Q1.2 (B), R5.2

Notes on the sheet:
LED DEBUG
SERVO HEADER
USER BUTTON
BUZZER
RESET BUTTON
POWER SOURCE
MOTOR HEADER
STLINK
ESP32 DISPLAY
DRIVER TB6612FNG
MPU SENSOR
CLOCK SOURCE
TOF SENSOR

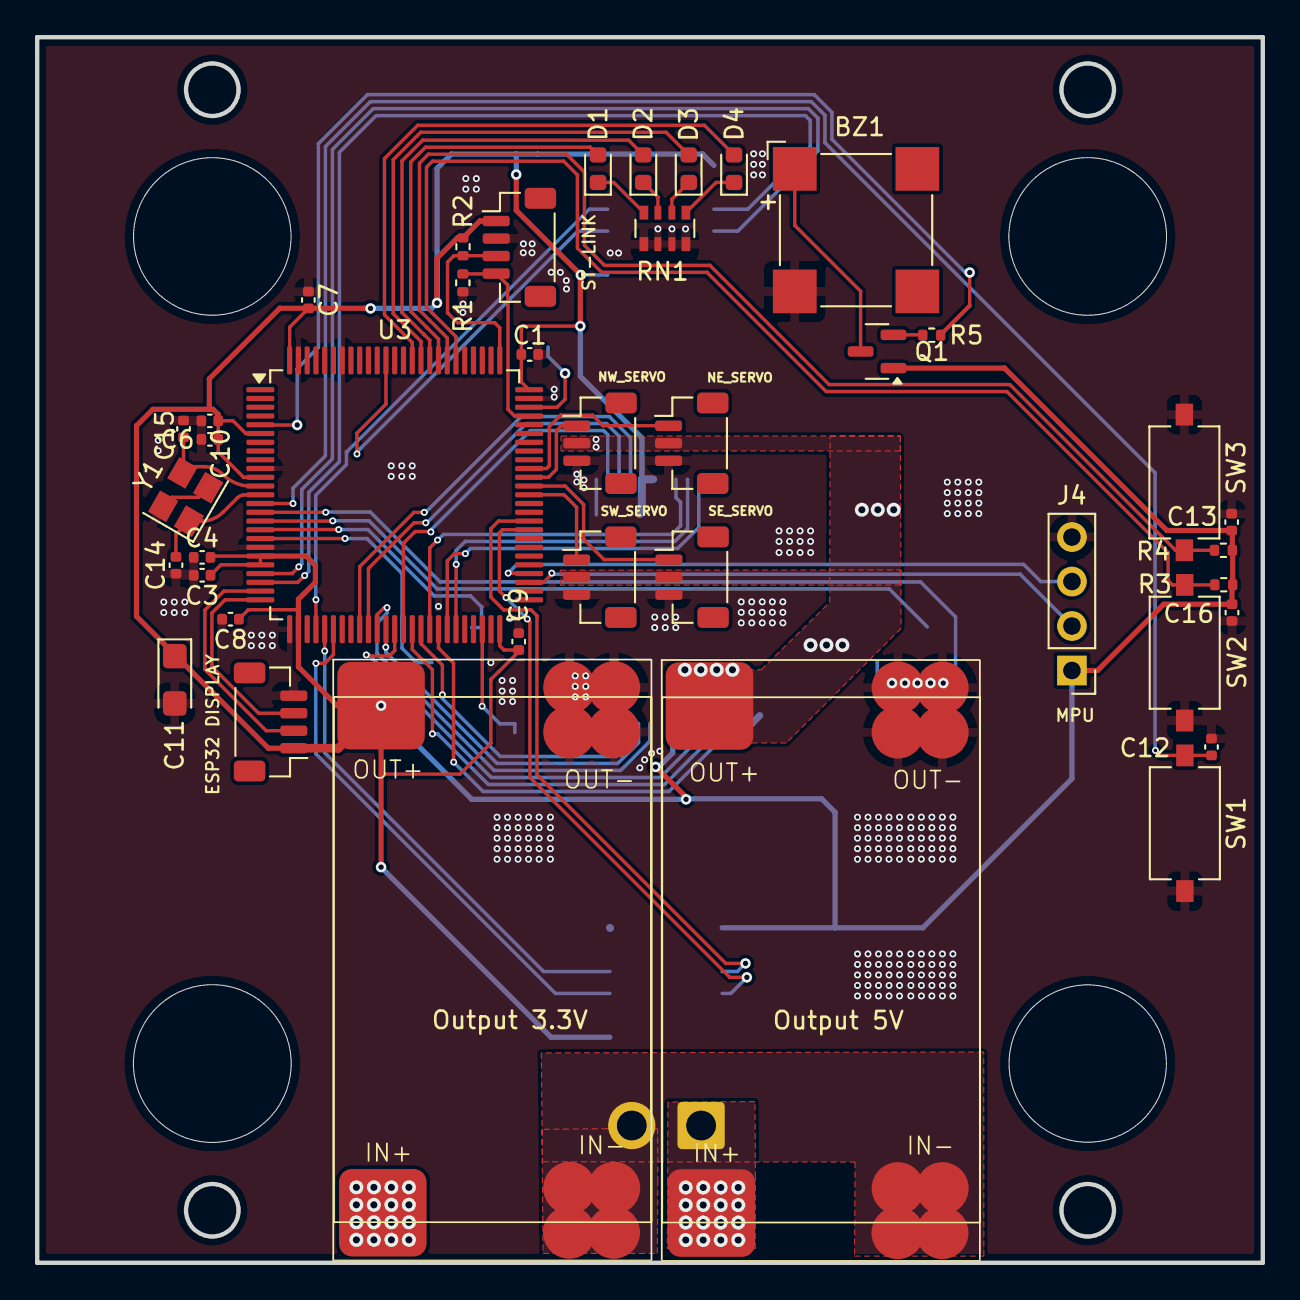
[picture p117: board PCB_AIO_V1.kicad_pcb from above]

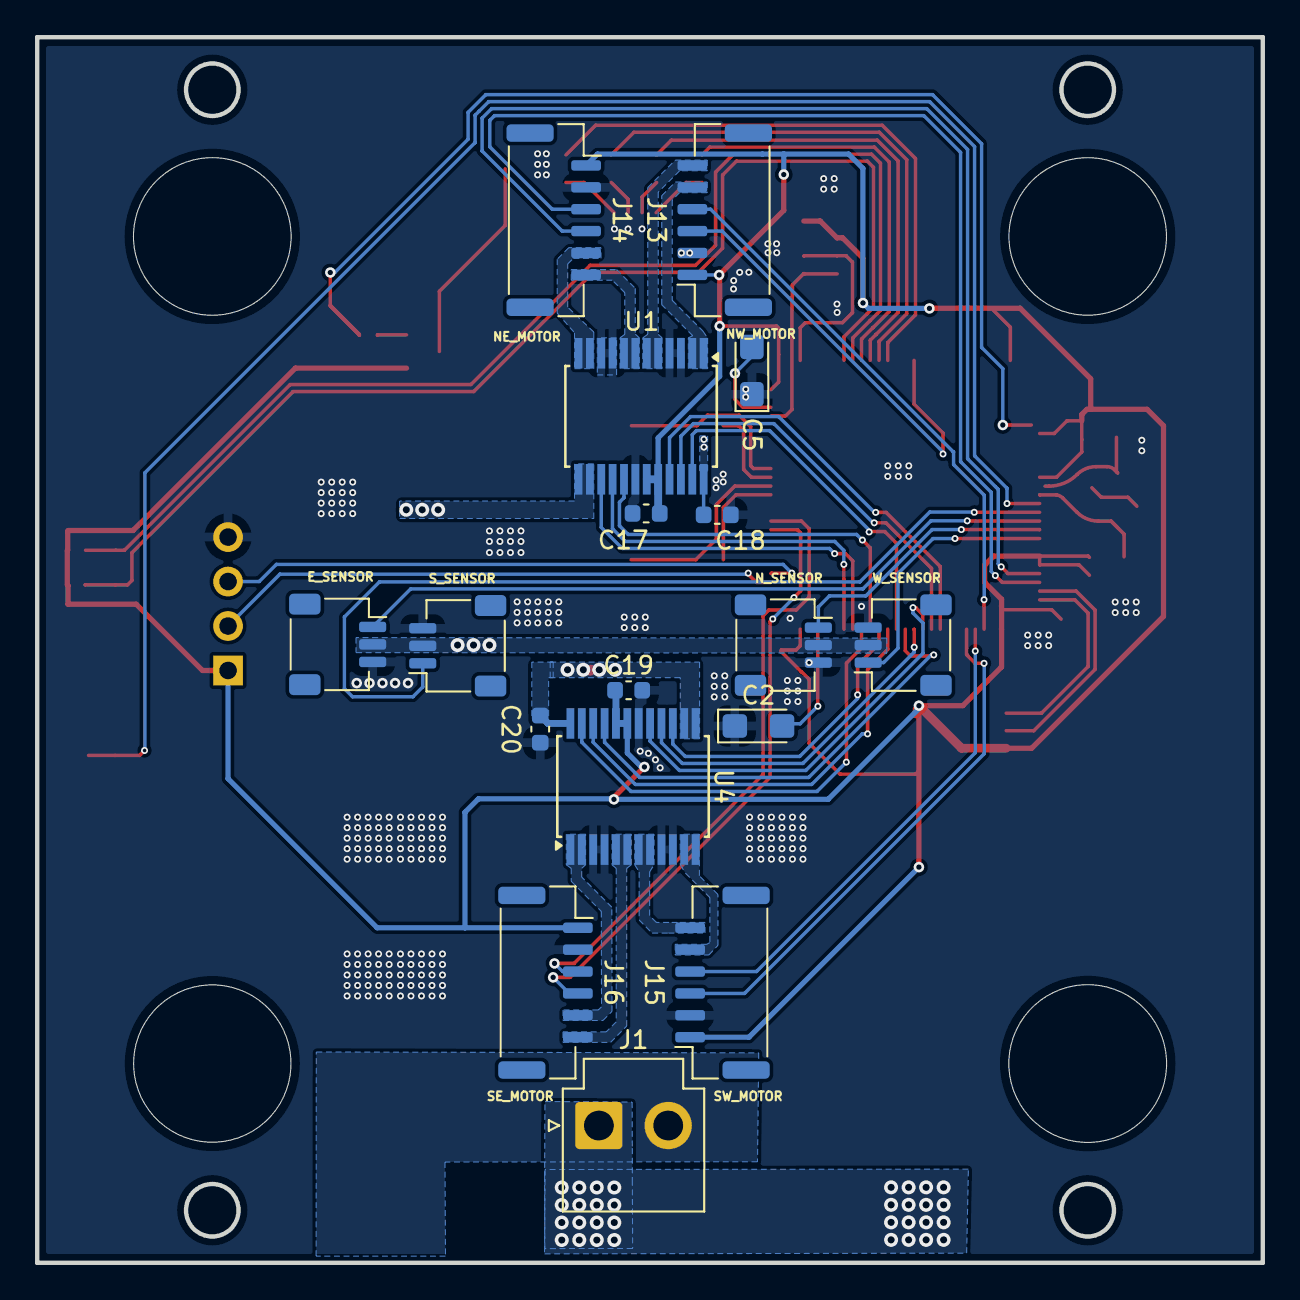
[picture p118: board PCB_AIO_V1.kicad_pcb from below]

Board: 2 copper layers, 70.0 x 70.0 mm, 57 parts (17 on the bottom side), 65 nets.
