anmh1205/AML_MicroMouse_2024/2. MicroMouse PCB/V1/PCB_T2/PCB_T2.kicad_pcb

## KiCad design 2. MicroMouse PCB/V1/PCB_T2/PCB_T2.kicad_pcb (2024-08-29)

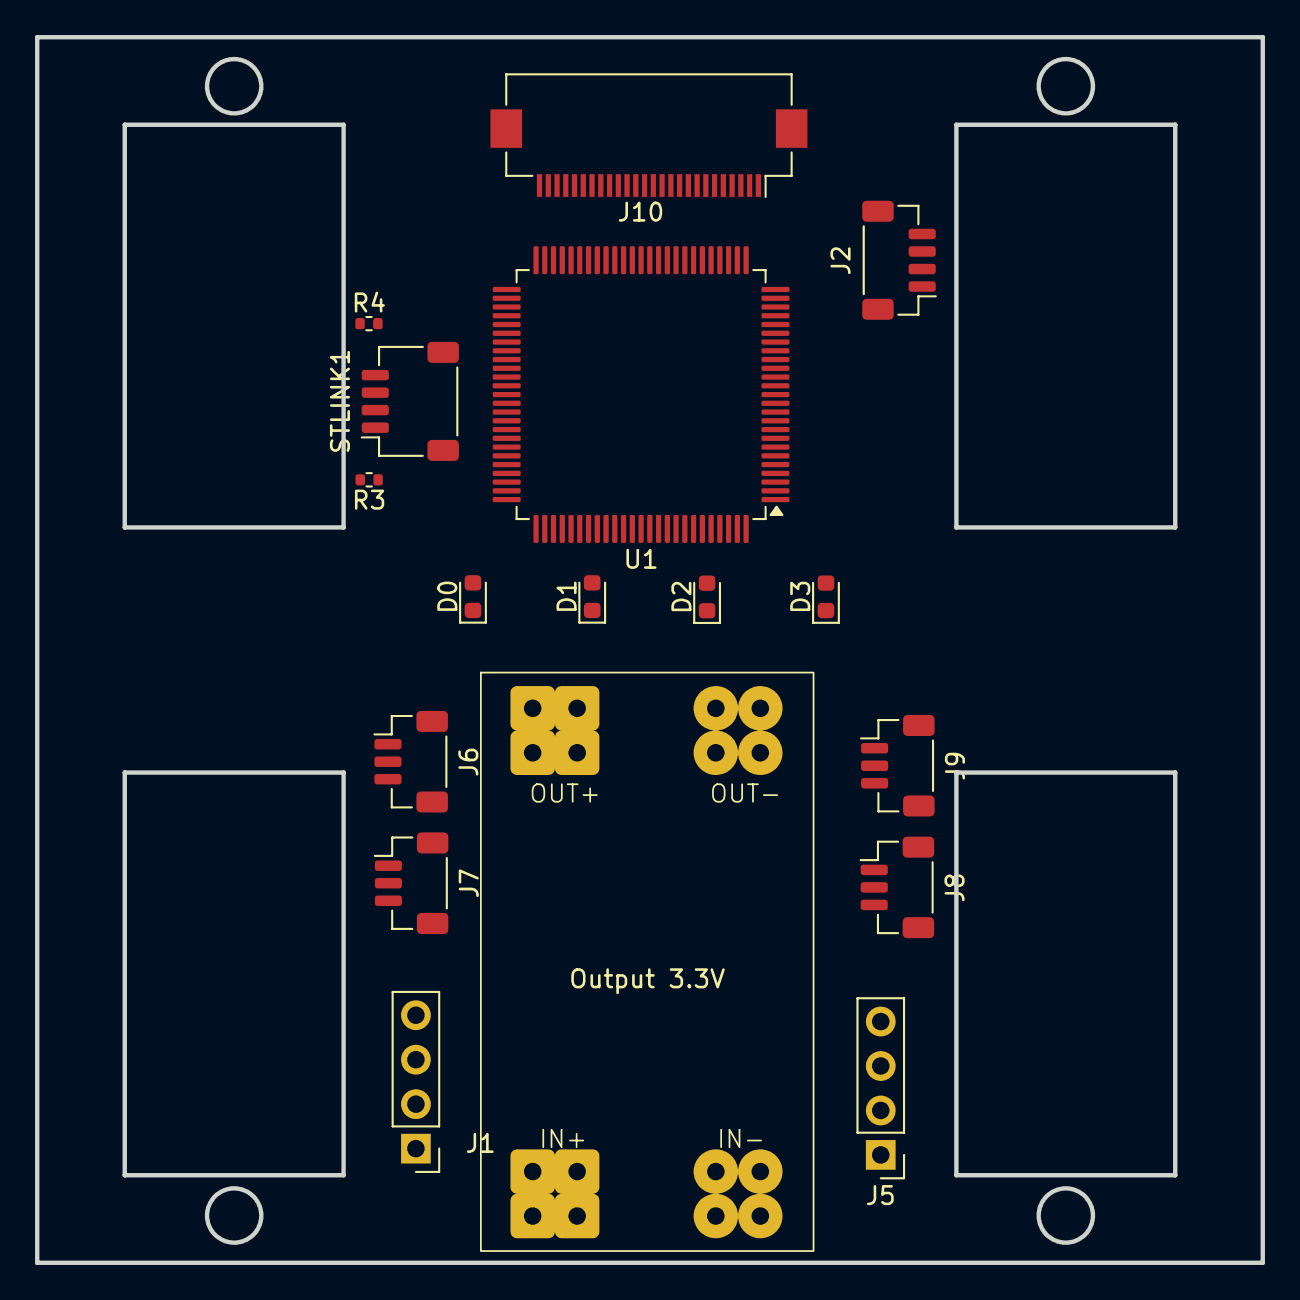
[picture p119: board PCB_T2.kicad_pcb from above]

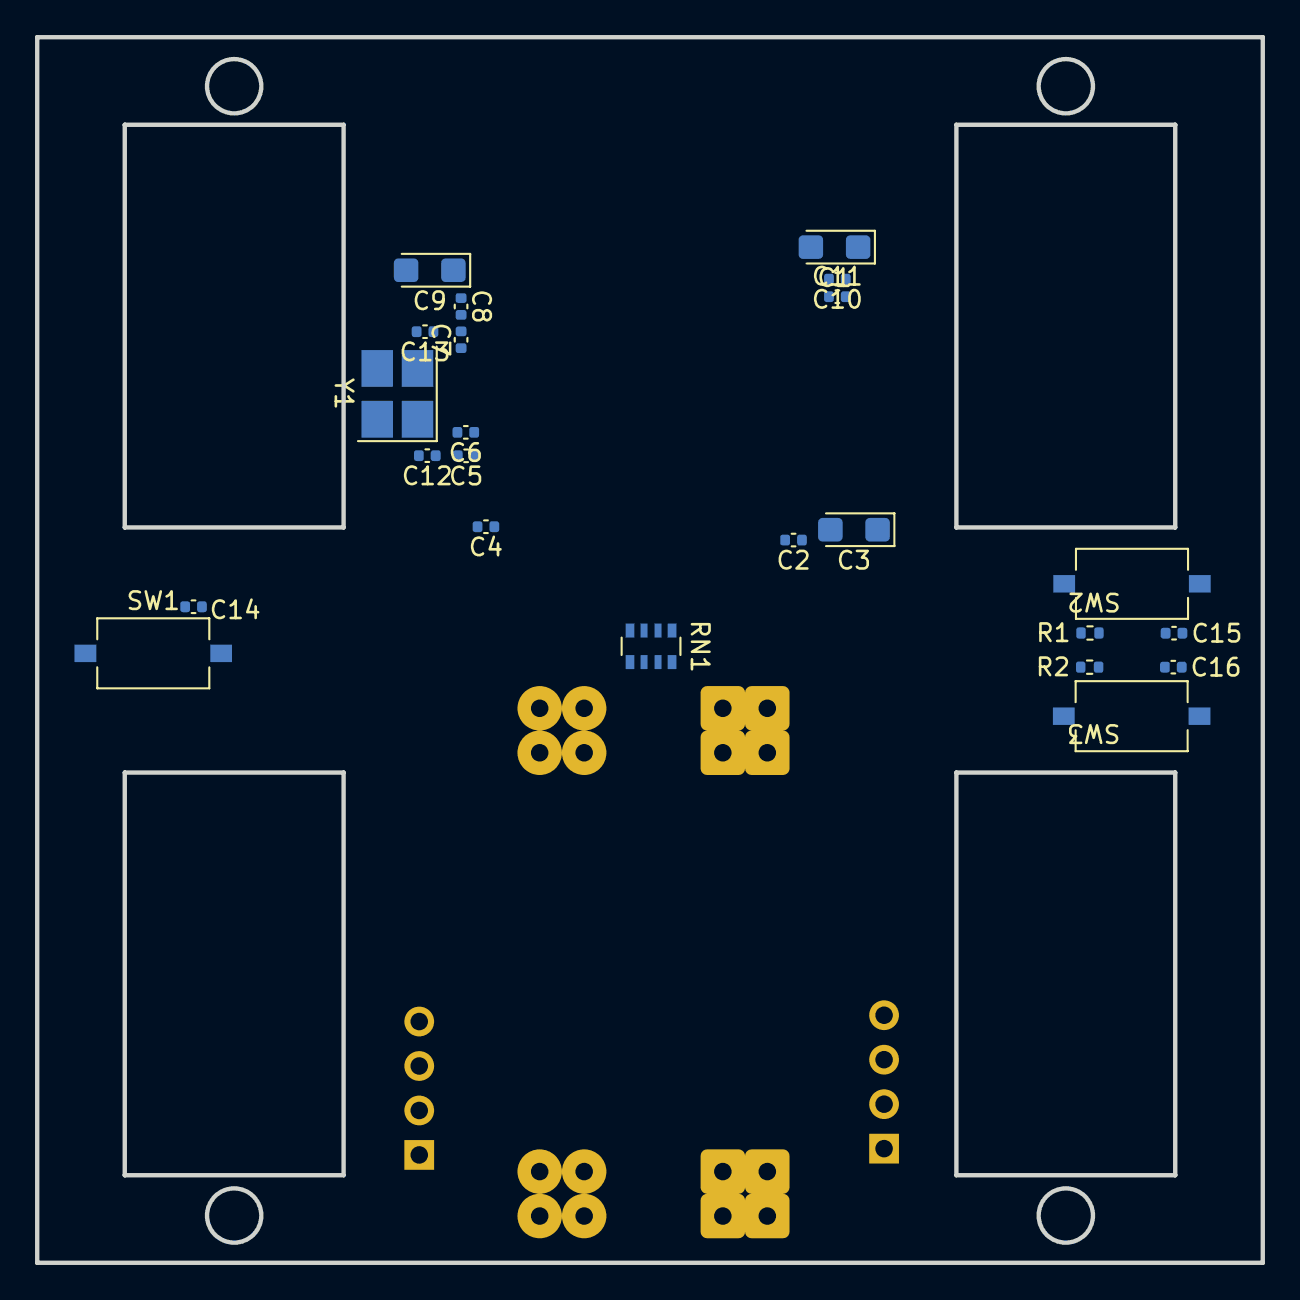
[picture p120: board PCB_T2.kicad_pcb from below]

Board: 2 copper layers, 70.0 x 70.0 mm, 40 parts (23 on the bottom side), 52 nets, no tracks yet.

Parts:
C1, C3: 2.2uF; CP_EIA-3216-10_Kemet-I
C2, C4, C5, C6, C7, C8, C10, C11, C14, C15, C16: 100nF; C_0402_1005Metric
C9: 4.7uF; CP_EIA-3216-10_Kemet-I
C12, C13: 15pF; C_0402_1005Metric
D0, D1, D2, D3: 3VL; LED_0603_1608Metric
J1: MPU; PinHeader_1x04_P2.54mm_Vertical
J2: MPU; JST_SH_BM04B-SRSS-TB_1x04-1MP_P1.00mm_Vertical
J5: Conn_01x04_Pin; PinHeader_1x04_P2.54mm_Vertical
J6, J7, J8, J9: Conn_01x03_Pin; JST_SH_BM03B-SRSS-TB_1x03-1MP_P1.00mm_Vertical
J10: Conn_01x26_Socket; Hirose_FH12-26S-0.5SH_1x26-1MP_P0.50mm_Horizontal
R1, R2: 1K; R_0402_1005Metric
R3, R4: 10K; R_0402_1005Metric
RN1: R_Pack04; R_Array_Convex_4x0603
STLINK1: STLINK; JST_SH_SM04B-SRSS-TB_1x04-1MP_P1.00mm_Horizontal
SW1, SW2, SW3: SW_Push; SW_Tactile_SPST_NO_Straight_CK_PTS636Sx25SMTRLFS
U1: STM32H743VIT6; LQFP-100_14x14mm_P0.5mm
U2: Output 3.3V; Mini560_5A
Y1: 48MHz; Crystal_SMD_3225-4Pin_3.2x2.5mm_HandSoldering

Connections:
+3.3V: C2.2, C4.1, C5.1, C6.1, C7.1, C8.1, C9.1, C10.2, C11.1, C15.2, C16.2, J1.1, J2.1, R1.2, R2.2, R3.2, STLINK1.1, U1.6 (VBAT), U1.11 (VDD), U1.19 (VDD), U1.21 (VREF+), U1.22 (VDDA), U1.28 (VDD), U1.50 (VDD), U1.75 (VDD), U1.100 (VDD)
+5V: J5.3, J6.2, J7.2, J8.2, J9.2
/BUTTON_0: R1.1, SW2.2, U1.81 (PD0)
/BUTTON_1: R2.1, SW3.2, U1.82 (PD1)
/E_TOF: J10.4, U1.18 (PC3)
/LED_0: D0.2 (A), U1.83 (PD2)
/LED_1: D1.2 (A), U1.84 (PD3)
/LED_2: D2.2 (A), U1.85 (PD4)
/LED_3: D3.2 (A), U1.86 (PD5)
/NE_ENC_A: J10.23, U1.23 (PA0)
/NE_ENC_B: J10.24, U1.24 (PA1)
/NE_IN1: J10.20, U1.43 (PE12)
/NE_IN2: J10.21, U1.46 (PE15)
/NE_PWM: J10.22, U1.45 (PE14)
/NE_SERVO: J9.1, U1.66 (PC9)
/NRST: C14.2, SW1.2, U1.14 (NRST)
/NW_ENC_A: J10.8, U1.30 (PA5)
/NW_ENC_B: J10.9, U1.89 (PB3)
/NW_IN1: J10.5, U1.35 (PB0)
/NW_IN2: J10.6, U1.36 (PB1)
/NW_PWM: J10.7, U1.40 (PE9)
/NW_SERVO: J6.1, U1.63 (PC6)
/N_TOF: J10.1, U1.15 (PC0)
/PH0: C12.2, U1.12 (PH0), Y1.1
/PH1: C13.2, U1.13 (PH1), Y1.2
/SE_ENC_A: J10.18, U1.59 (PD12)
/SE_ENC_B: J10.19, U1.60 (PD13)
/SE_IN1: J10.15, U1.39 (PE8)
/SE_IN2: J10.16, U1.41 (PE10)
/SE_PWM: J10.17, U1.44 (PE13)
/SE_SERVO: J8.1, U1.65 (PC8)
/SWCLK: R3.1, STLINK1.3, U1.76 (PA14)
/SWDIO: R4.2, STLINK1.4, U1.72 (PA13)
/SW_ENC_A: J10.13, U1.31 (PA6)
/SW_ENC_B: J10.14, U1.32 (PA7)
/SW_IN1: J10.10, U1.37 (PB2)
/SW_IN2: J10.11, U1.38 (PE7)
/SW_PWM: J10.12, U1.42 (PE11)
/SW_SERVO: J7.1, U1.64 (PC7)
/S_TOF: J10.3, U1.17 (PC2)
/USART1_RX: J1.3, U1.54 (PB15)
/USART1_TX: J1.2, U1.53 (PB14)
/USART2_RX: J2.3, U1.26 (PA3)
/USART2_TX: J2.2, U1.25 (PA2)
/W_TOF: J10.2, U1.16 (PC1)
GND: C1.1, C2.1, C3.1, C4.2, C5.2, C6.2, C7.2, C8.2, C9.2, C10.1, C11.2, C12.1, C13.1, C14.1, C15.1, C16.1, J1.4, J2.4, J5.4, J6.3, J7.3, J8.3, J9.3, R4.1, RN1.5 (R4.2), RN1.6 (R3.2), RN1.7 (R2.2), RN1.8 (R1.2), STLINK1.2, SW1.1, SW2.1, SW3.1, U1.10 (VSS), U1.20 (VSSA), U1.27 (VSS), U1.74 (VSS), U1.94 (BOOT0), U1.99 (VSS)
unnamed: D0.1 (K), RN1.1 (R1.1)
unnamed: D1.1 (K), RN1.2 (R2.1)
unnamed: D2.1 (K), RN1.3 (R3.1)
unnamed: D3.1 (K), RN1.4 (R4.1)
unnamed: C1.2, U1.49 (VCAP_1)
unnamed: C3.2, U1.73 (VCAP_2)
