anmh1205/AML_MicroMouse_2024/2. MicroMouse PCB/V1/PCB_T1/PCB_T1.kicad_pcb

## KiCad design 2. MicroMouse PCB/V1/PCB_T1/PCB_T1.kicad_pcb (2024-08-10)

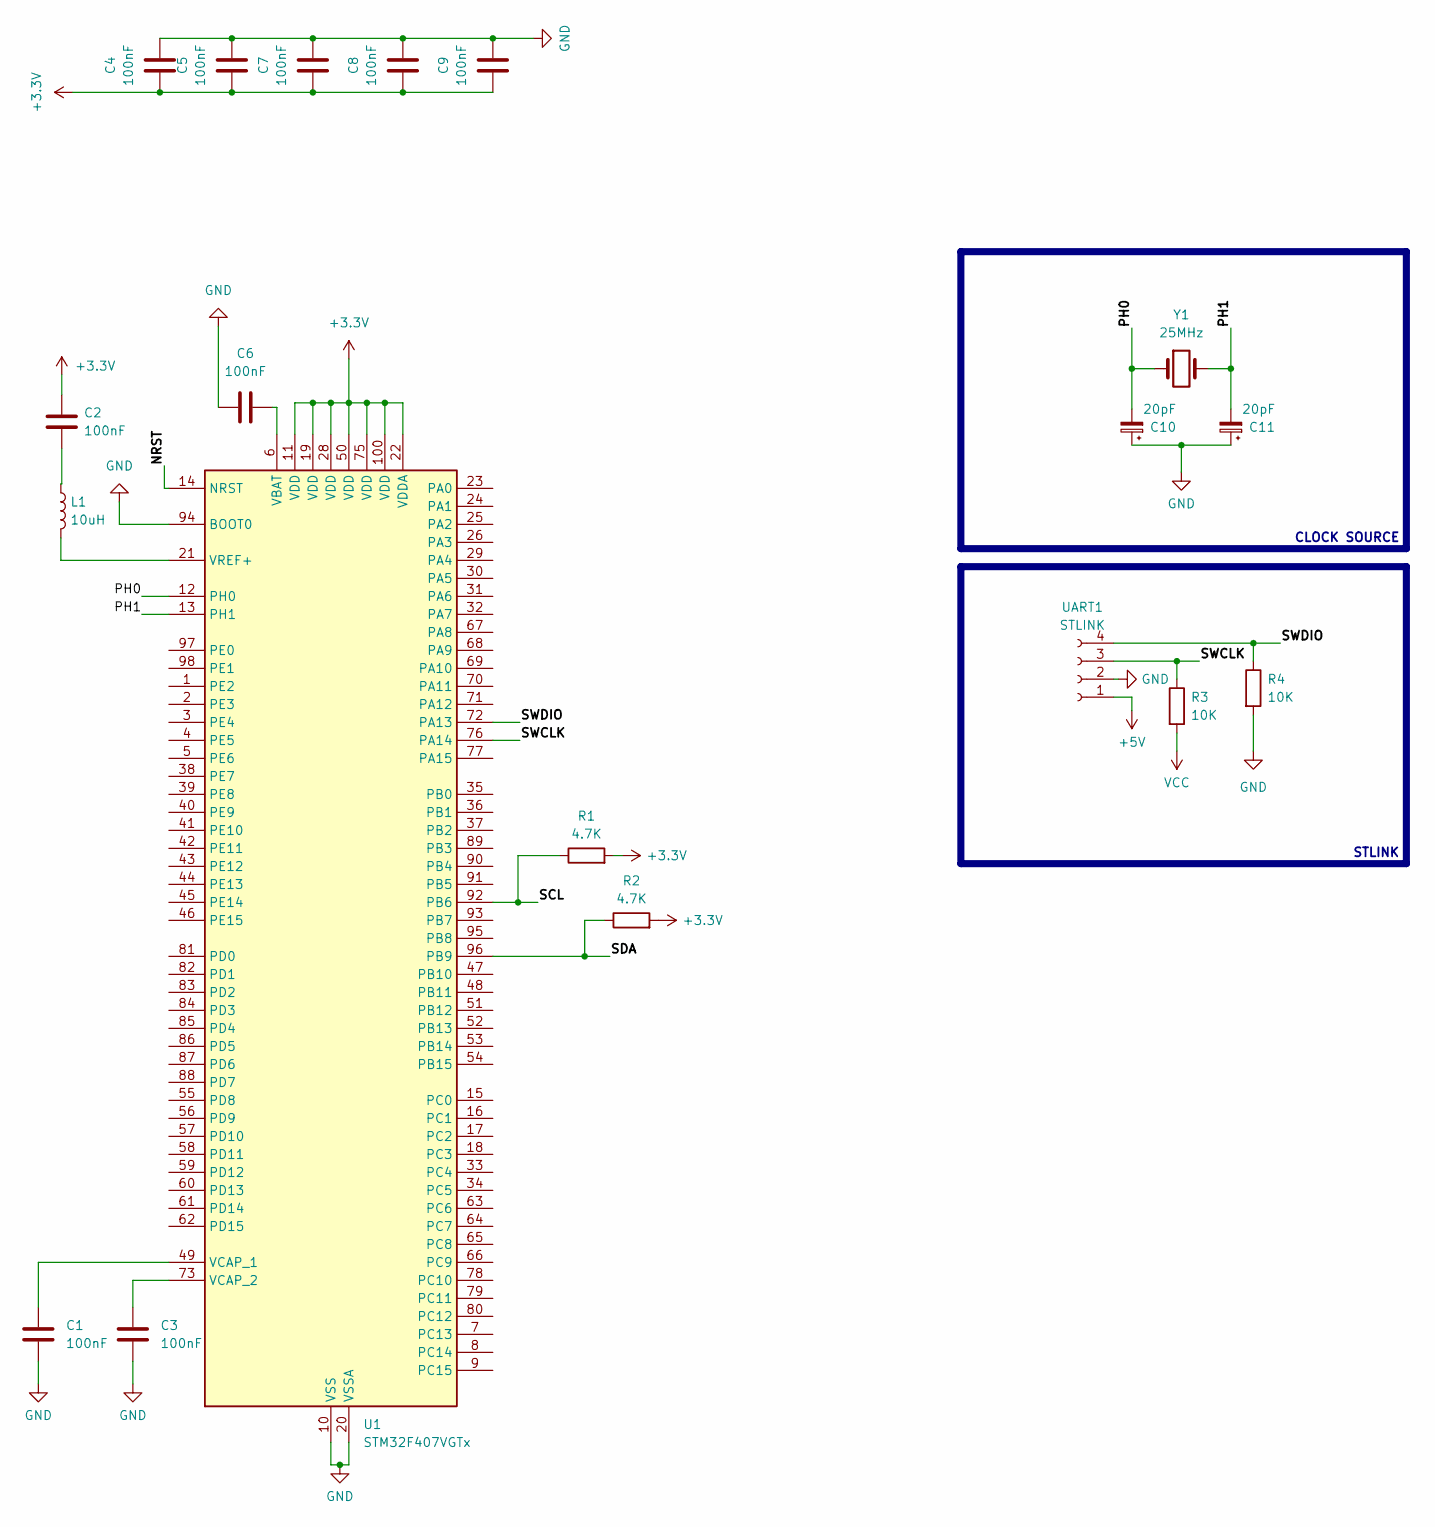
[picture p121: schematic PCB_T1.kicad_sch]

Parts:
C1, C2, C3, C4, C5, C6, C7, C8, C9: 100nF; C_0603_1608Metric
C10, C11: 20pF; C_0603_1608Metric
L1: 10uH; C_0805_2012Metric_Pad1.18x1.45mm_HandSolder
R1, R2: 4.7K; R_0603_1608Metric
R3, R4: 10K; R_0603_1608Metric
U1: STM32F407VGTx; LQFP-100_14x14mm_P0.5mm
UART1: STLINK; JST 4
Y1: 25MHz; Crystal_HC49-U_Vertical

Connections:
+3.3V: C2.1, C4.1, C5.1, C7.1, C8.1, C9.1, R1.2, R2.2, U1.11 (VDD), U1.19 (VDD), U1.22 (VDDA), U1.28 (VDD), U1.50 (VDD), U1.75 (VDD), U1.100 (VDD)
/NRST: U1.14 (NRST)
/PH0: C10.2, U1.12 (PH0), Y1.1
/PH1: C11.2, U1.13 (PH1), Y1.2
/SCL: R1.1, U1.92 (PB6)
/SDA: R2.1, U1.96 (PB9)
/SWCLK: R3.1, U1.76 (PA14), UART1.3
/SWDIO: R4.1, U1.72 (PA13), UART1.4
GND: C1.1, C3.1, C4.2, C5.2, C6.1, C7.2, C8.2, C9.2, C10.1, C11.1, R4.2, U1.10 (VSS), U1.20 (VSSA), U1.27 (VSS), U1.74 (VSS), U1.94 (BOOT0), U1.99 (VSS), UART1.2
unnamed: C2.2, L1.1
unnamed: C6.2, U1.6 (VBAT)
unnamed: C1.2, U1.49 (VCAP_1)
unnamed: C3.2, U1.73 (VCAP_2)
unnamed: L1.2, U1.21 (VREF+)
VCC: R3.2

Notes on the sheet:
STLINK
CLOCK SOURCE

Board: 2 copper layers, 18 parts (0 on the bottom side), 13 nets, no tracks yet.
