anmh1205/AML_MicroMouse_2024/0. Example/Wireless DAP/wireless-esp8266-dap-master/circuit/ESP8266.kicad_pcb

## KiCad design 0. Example/Wireless DAP/wireless-esp8266-dap-master/circuit/ESP8266.kicad_pcb (2024-08-10)

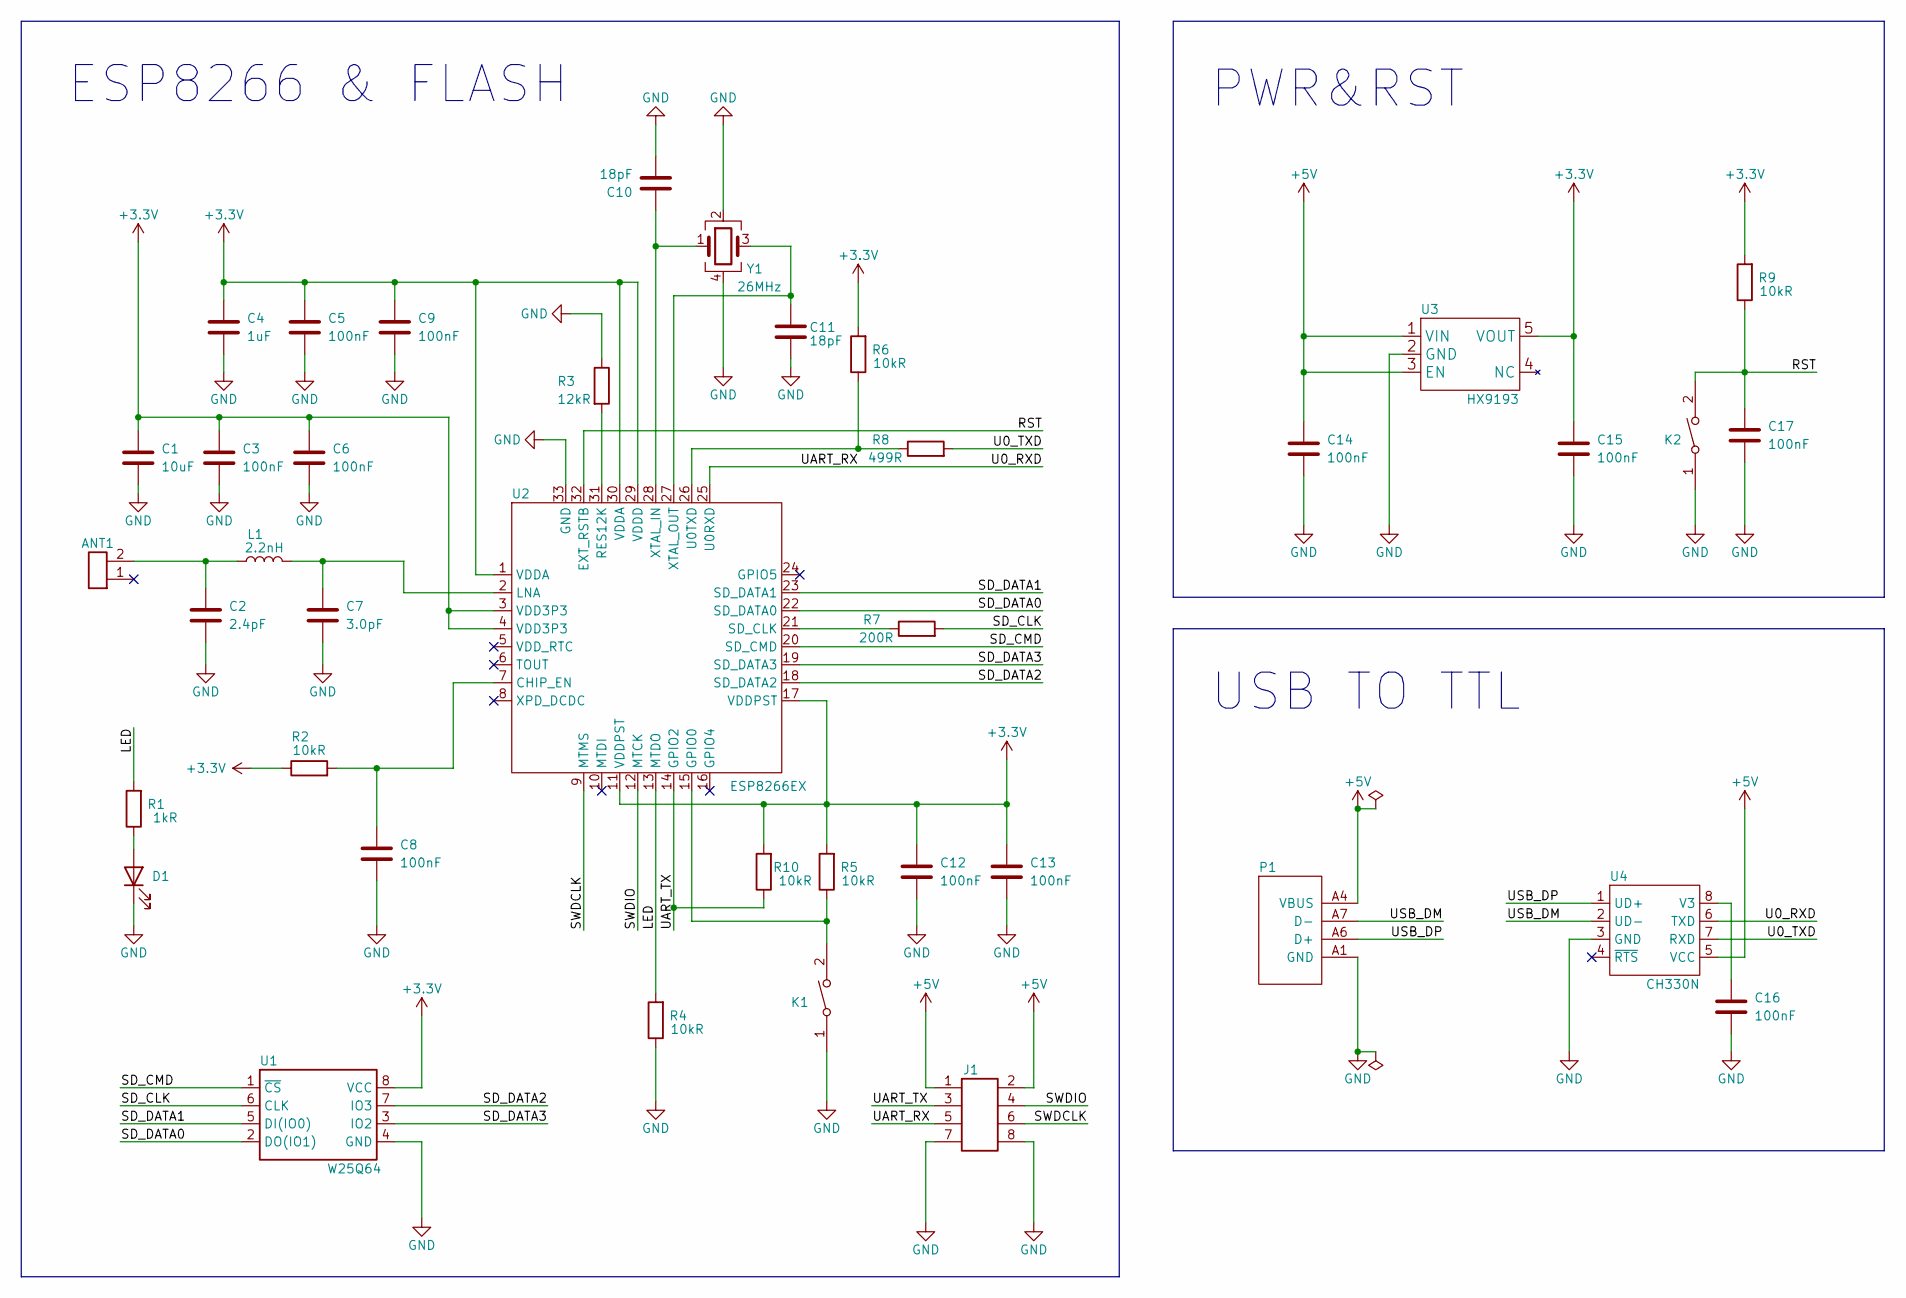
[picture p122: schematic ESP8266.kicad_sch, ESP8266 Wireless DAP]

Parts:
ANT1: Conn_01x02; Johanson_2450AT18x100
C1: 10uF; C_0603_1608Metric
C2: 2.4pF; C_0603_1608Metric
C3, C5, C6, C8, C9, C12, C13, C14, C15, C16, C17: 100nF; C_0603_1608Metric
C4: 1uF; C_0603_1608Metric
C7: 3.0pF; C_0603_1608Metric
C10, C11: 18pF; C_0603_1608Metric
D1: LED; LED_0603_1608Metric
J1: Conn_02x04_Odd_Even; PinHeader_2x04_P1.27mm_Vertical_SMD
K1, K2: SW_DIP_x01; SW_Push_SPST_NO_Alps_SKRK
L1: 2.2nH; L_0603_1608Metric
P1: USB_C_Plug_USB2.0; USB_C_Receptacle_HRO_TYPE-C-31-M-12
R1: 1kR; R_0603_1608Metric
R2, R4, R5, R6, R9, R10: 10kR; R_0603_1608Metric
R3: 12kR; R_0603_1608Metric
R7: 200R; R_0603_1608Metric
R8: 499R; R_0603_1608Metric
U1: W25Q64; SOIC-8_5.23x5.23mm_P1.27mm
U2: ESP8266EX; ESP8266
U3: HX9193; SOT-23-5
U4: CH330N; SOIC-8_3.9x4.9mm_P1.27mm
Y1: 26MHz; Crystal_SMD_3225-4Pin_3.2x2.5mm

Connections:
+3V3: C1.1, C3.1, C4.1, C5.1, C6.1, C9.1, C12.1, C13.1, C15.1, R2.1, R5.2, R6.2, R9.2, R10.2, U1.8 (VCC), U2.1 (VDDA), U2.3 (VDD3P3), U2.4 (VDD3P3), U2.11 (VDDPST), U2.17 (VDDPST), U2.29 (VDDD), U2.30 (VDDA), U3.5 (VOUT)
+5V: C14.1, J1.1, J1.2, P1.A4 (VBUS), P1.A9 (VBUS), P1.B4 (VBUS), P1.B9 (VBUS), U3.1 (VIN), U3.3 (EN), U4.5 (VCC)
/LED: R1.2, R4.2, U2.13 (MTDO)
/RST: C17.1, K2.2, R9.1, U2.32 (EXT_RSTB)
/SD_CLK: R7.2, U1.6 (CLK)
/SD_CMD: U1.1 (~CS), U2.20 (SD_CMD)
/SD_DATA0: U1.2 (DO(IO1)), U2.22 (SD_DATA0)
/SD_DATA1: U1.5 (DI(IO0)), U2.23 (SD_DATA1)
/SD_DATA2: U1.7 (IO3), U2.18 (SD_DATA2)
/SD_DATA3: U1.3 (IO2), U2.19 (SD_DATA3)
/SWDCLK: J1.6, U2.9 (MTMS)
/SWDIO: J1.4, U2.12 (MTCK)
/U0_RXD: J1.5, U2.25 (U0RXD), U4.6 (TXD)
/U0_TXD: R8.2, U4.7 (RXD)
/UART_TX: J1.3, R10.1, U2.14 (GPIO2)
/USB_DM: P1.A7 (D-), P1.B7 (D-), U4.2 (UD-)
/USB_DP: P1.A6 (D+), P1.B6 (D+), U4.1 (UD+)
GND: C1.2, C2.2, C3.2, C4.2, C5.2, C6.2, C7.2, C8.2, C9.2, C10.2, C11.2, C12.2, C13.2, C14.2, C15.2, C16.2, C17.2, D1.1 (K), J1.7, J1.8, K1.1, K2.1, P1.A1 (GND), P1.A12 (GND), P1.B1 (GND), P1.B12 (GND), R3.1, R4.1, U1.4 (GND), U2.33 (GND), U3.2 (GND), U4.3 (GND), Y1.2, Y1.4
unnamed: ANT1.2, C2.1, L1.1
unnamed: C7.1, L1.2, U2.2 (LNA)
unnamed: C8.1, R2.2, U2.7 (CHIP_EN)
unnamed: C10.1, U2.28 (XTAL_IN), Y1.1
unnamed: C11.1, U2.27 (XTAL_OUT), Y1.3
unnamed: C16.1, U4.8 (V3)
unnamed: D1.2 (A), R1.1
unnamed: K1.2, R5.1, U2.15 (GPIO0)
unnamed: R3.2, U2.31 (RES12K)
unnamed: R6.1, R8.1, U2.26 (U0TXD)
unnamed: R7.1, U2.21 (SD_CLK)

Notes on the sheet:
ESP8266 & FLASH
PWR&RST
USB TO TTL

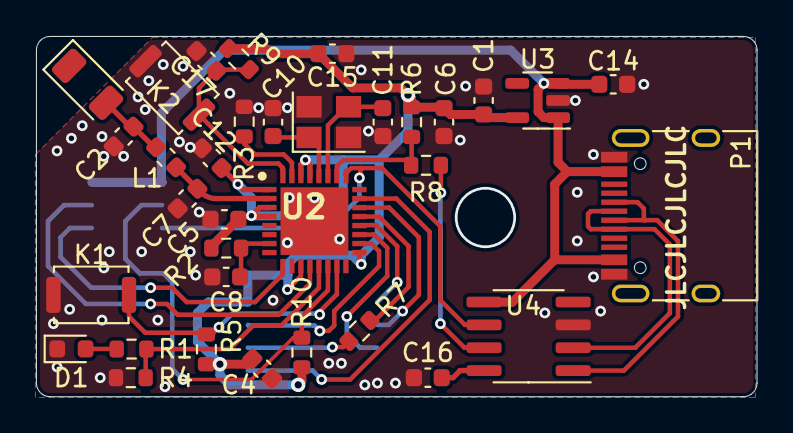
[picture p123: board ESP8266.kicad_pcb from above]

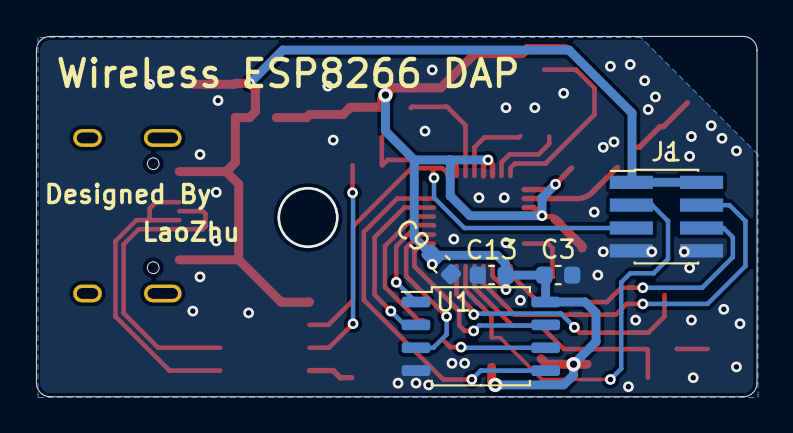
[picture p124: board ESP8266.kicad_pcb from below]

Board: 2 copper layers, 40.0 x 20.0 mm, 39 parts (5 on the bottom side), 29 nets.
