anmh1205/AML_MicroMouse_2024/1. MicroMouse Code/2. MicroMouse - STM32F407VGT6/PCB_AIO_V2_CODE/Core/Src/main.c

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
/* Includes ------------------------------------------------------------------*/
#include "main.h"

/* USER CODE BEGIN Includes */
#include "AML_GlobalVariable.h"
#include "AML_IMU.h"
#include "AML_IRSensor.h"

#include <string.h>

#include "AML_LedDebug.h"
#include "AML_Buzzer.h"
#include "AML_Switch.h"
#include "AML_MotorControl.h"
#include "AML_Encoder.h"

#include "solver.h"

/* USER CODE END Includes */

ADC_HandleTypeDef hadc2;

TIM_HandleTypeDef htim1;
TIM_HandleTypeDef htim2;
TIM_HandleTypeDef htim3;
TIM_HandleTypeDef htim5;
TIM_HandleTypeDef htim7;

UART_HandleTypeDef huart1;
DMA_HandleTypeDef hdma_usart1_rx;

/* USER CODE BEGIN PV */
int32_t debug[100];

double CurrentAngle = 0;
uint32_t frequency_test = 1000;
uint32_t leftEncoder = 0;
uint32_t rightEncoder = 0;

int32_t pwm = 20;
/* USER CODE END PV */

void SystemClock_Config(void);
static void MPU_Config(void);
static void MX_GPIO_Init(void);
static void MX_DMA_Init(void);
static void MX_TIM2_Init(void);
static void MX_ADC2_Init(void);
static void MX_TIM1_Init(void);
static void MX_TIM5_Init(void);
static void MX_USART1_UART_Init(void);
static void MX_TIM3_Init(void);
static void MX_TIM7_Init(void);
/* USER CODE BEGIN 0 */
void StartSolver()
{
  // debug_log("Running...");
  initialize();
  while (1)
  {
    Action nextMove = solver();

    switch (nextMove)
    {
    case FORWARD:
      // API_moveForward();
      MOVE_FORWARD_FUNCTION;
      break;
    case LEFT:
      // API_turnLeft();
      TURN_LEFT_FUNCTION;
      break;
    case RIGHT:
      // API_turnRight();
      TURN_RIGHT_FUNCTION;
      break;
    case IDLE:
      break;
    }
  }
}


/* USER CODE END 0 */

/**
 * @brief  The application entry point.
 * @retval int
 */
int main(void)
{

  /* MPU Configuration--------------------------------------------------------*/
  MPU_Config();

  /* MCU Configuration--------------------------------------------------------*/

  /* Reset of all peripherals, Initializes the Flash interface and the Systick. */
  HAL_Init();

  /* Configure the system clock */
  SystemClock_Config();

  /* Initialize all configured peripherals */
  MX_GPIO_Init();
  MX_DMA_Init();
  MX_TIM2_Init();
  MX_ADC2_Init();
  MX_TIM1_Init();
  MX_TIM5_Init();
  MX_USART1_UART_Init();
  MX_TIM3_Init();
  MX_TIM7_Init();
  /* USER CODE BEGIN 2 */

  // DO NOT REMOVE THIS LINE (IMPORTANT)
  // DO NOT REMOVE THIS LINE (IMPORTANT)
  // DO NOT REMOVE THIS LINE (IMPORTANT)
  // DO NOT REMOVE THIS LINE (IMPORTANT)
  // DO NOT REMOVE THIS LINE (IMPORTANT)
  AML_Buzzer_Setup(); // DO NOT REMOVE THIS LINE (IMPORTANT)
  // DO NOT REMOVE THIS LINE (IMPORTANT)
  // DO NOT REMOVE THIS LINE (IMPORTANT)
  // DO NOT REMOVE THIS LINE (IMPORTANT)
  // DO NOT REMOVE THIS LINE (IMPORTANT)
  // DO NOT REMOVE THIS LINE (IMPORTANT)

  memset(debug, 0, sizeof(debug));

  AML_MotorControl_Setup();

  AML_IRSensor_Setup();

  AML_MPUSensor_Setup(&huart1);
  AML_MPUSensor_ResetAngle();

  AML_Encoder_Setup();

  // StartSolver();

  for (int i = 0; i < 2; i++)
  {
    AML_LedDebug_TurnOnLED(YELLOW);
    HAL_Delay(200);
    AML_LedDebug_TurnOffLED(YELLOW);
    AML_LedDebug_TurnOnLED(GREEN);
    HAL_Delay(200);
    AML_LedDebug_TurnOffLED(GREEN);
    AML_LedDebug_TurnOnLED(BLUE);
    HAL_Delay(200);
    AML_LedDebug_TurnOffLED(BLUE);
    AML_LedDebug_TurnOnLED(RED);
    HAL_Delay(200);
    AML_LedDebug_TurnOffLED(RED);
  }

  /* USER CODE END 2 */

  /* Infinite loop */
  /* USER CODE BEGIN WHILE */
  while (1)
  {
    /* USER CODE END WHILE */

    /* USER CODE BEGIN 3 */

    if (AML_Read_Button(SW_0))
    {
      // AML_Buzzer_PlaySong();
      AML_MotorControl_Move(pwm, pwm);
      // AML_MotorControl_TurnOnWallFollow();
      // AML_MotorControl_Move(30, 30);

      AML_MotorControl_TurnOnWallFollow();
    }
    else if (AML_Read_Button(SW_1))
    {
      AML_Buzzer_Beep();

      AML_MotorControl_TurnOffWallFollow();
      AML_MotorControl_Stop();

      // HAL_Delay(2000);
    }
    leftEncoder = AML_Encoder_GetLeftValue();
    rightEncoder = AML_Encoder_GetRightValue();

    CurrentAngle = AML_MPUSensor_GetAngle();

    // AML_ReadAll_BitSwitch();
    // AML_ReadAll_Button();
    HAL_Delay(100);
  }
  /* USER CODE END 3 */
}

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
/* MPU Configuration */

void MPU_Config(void)
{
  MPU_Region_InitTypeDef MPU_InitStruct = {0};

  /* Disables the MPU */
  HAL_MPU_Disable();

  /** Initializes and configures the Region and the memory to be protected
   */
  MPU_InitStruct.Enable = MPU_REGION_ENABLE;
  MPU_InitStruct.Number = MPU_REGION_NUMBER0;
  MPU_InitStruct.BaseAddress = 0x0;
  MPU_InitStruct.Size = MPU_REGION_SIZE_4GB;
  MPU_InitStruct.SubRegionDisable = 0x87;
  MPU_InitStruct.TypeExtField = MPU_TEX_LEVEL0;
  MPU_InitStruct.AccessPermission = MPU_REGION_NO_ACCESS;
  MPU_InitStruct.DisableExec = MPU_INSTRUCTION_ACCESS_DISABLE;
  MPU_InitStruct.IsShareable = MPU_ACCESS_SHAREABLE;
  MPU_InitStruct.IsCacheable = MPU_ACCESS_NOT_CACHEABLE;
  MPU_InitStruct.IsBufferable = MPU_ACCESS_NOT_BUFFERABLE;

  HAL_MPU_ConfigRegion(&MPU_InitStruct);
  /* Enables the MPU */
  HAL_MPU_Enable(MPU_PRIVILEGED_DEFAULT);
}

/**
 * @brief  This function is executed in case of error occurrence.
 * @retval None
 */
void Error_Handler(void)
{
  /* USER CODE BEGIN Error_Handler_Debug */
  /* User can add his own implementation to report the HAL error return state */
  __disable_irq();
  while (1)
  {
  }
  /* USER CODE END Error_Handler_Debug */
}

#ifdef USE_FULL_ASSERT
/**
 * @brief  Reports the name of the source file and the source line number
 *         where the assert_param error has occurred.
 * @param  file: pointer to the source file name
 * @param  line: assert_param error line source number
 * @retval None
 */
void assert_failed(uint8_t *file, uint32_t line)
{
  /* USER CODE BEGIN 6 */
  /* User can add his own implementation to report the file name and line number,
     ex: printf("Wrong parameters value: file %s on line %d\r\n", file, line) */
  /* USER CODE END 6 */
}
#endif /* USE_FULL_ASSERT */
