anmh1205/AML_MicroMouse_2024/1. MicroMouse Code/2. MicroMouse - STM32F407VGT6/V1_F743VIT6/V1_F743VIT6.ioc

Mcu.UserName=STM32H743VITx
PA0.GPIO_Label=NE_ENC_A
PA0.Signal=S_TIM5_CH1
PA1.GPIO_Label=NE_ENC_B
PA1.Signal=S_TIM5_CH2
PA2.Signal=USART2_TX
PA3.Signal=USART2_RX
PA5.GPIO_Label=NW_ENC_A
PA5.Signal=S_TIM2_CH1_ETR
PA6.GPIO_Label=SW_ENC_A
PA6.Signal=S_TIM3_CH1
PA7.GPIO_Label=SW_ENC_B
PA7.Signal=S_TIM3_CH2
PB0.GPIO_Label=NW_IN1
PB0.Signal=GPIO_Output
PB1.GPIO_Label=NW_IN2
PB1.Signal=GPIO_Output
PB14.Signal=USART1_TX
PB15.Signal=USART1_RX
PB2.GPIO_Label=SW_IN1
PB2.Signal=GPIO_Output
PB6.Signal=I2C1_SCL
PB7.Signal=I2C1_SDA
PB8.Signal=I2C4_SCL
PB9.Signal=I2C4_SDA
PC0.GPIO_Label=N_TOF
PC0.Signal=ADCx_INP10
PC1.GPIO_Label=W_TOF
PC1.Signal=ADCx_INP11
PC2_C.GPIO_Label=S_TOF
PC2_C.Signal=ADC3_INP0
PC3_C.GPIO_Label=E_TOF
PC3_C.Signal=ADC3_INP1
PC6.GPIO_Label=NW_SERVO
PC6.Signal=S_TIM8_CH1
PC7.GPIO_Label=SW_SERVO
PC7.Signal=S_TIM8_CH2
PC8.GPIO_Label=SE_SERVO
PC8.Signal=S_TIM8_CH3
PC9.GPIO_Label=NE_SERVO
PC9.Signal=S_TIM8_CH4
PD0.GPIO_Label=BUTTON_0
PD0.Signal=GPXTI0
PD1.GPIO_Label=BUTTON_1
PD1.Signal=GPXTI1
PD12.GPIO_Label=SE_ENC_A
PD12.Signal=S_TIM4_CH1
PD13.GPIO_Label=SE_ENC_B
PD13.Signal=S_TIM4_CH2
PD2.GPIO_Label=LED_0
PD2.Signal=GPIO_Output
PD3.GPIO_Label=LED_1
PD3.Signal=GPIO_Output
PD4.GPIO_Label=LED_2
PD4.Signal=GPIO_Output
PD5.GPIO_Label=LED_3
PD5.Signal=GPIO_Output
PD8.Signal=USART3_TX
PD9.Signal=USART3_RX
PE10.GPIO_Label=SE_IN2
PE10.Signal=GPIO_Output
PE11.GPIO_Label=SW_PWM
PE11.Signal=S_TIM1_CH2
PE12.GPIO_Label=NE_IN1
PE12.Signal=GPIO_Output
PE13.GPIO_Label=SE_PWM
PE13.Signal=S_TIM1_CH3
PE14.GPIO_Label=NE_PWM
PE14.Signal=S_TIM1_CH4
PE15.GPIO_Label=NE_IN2
PE15.Signal=GPIO_Output
PE5.Signal=S_TIM15_CH1
PE7.GPIO_Label=SW_IN2
PE7.Signal=GPIO_Output
PE8.GPIO_Label=SE_IN1
PE8.Signal=GPIO_Output
PE9.GPIO_Label=NW_PWM
PE9.Signal=S_TIM1_CH1
