anmh1205/AML_MicroMouse_2024/1. MicroMouse Code/2. MicroMouse - STM32F407VGT6/PCB_AIO_V2_CODE/Core/Src/AML_MotorControl.c

#include <AML_MotorControl.h>

extern debug[100];

extern TIM_HandleTypeDef htim1; // timer for pwm
extern TIM_HandleTypeDef htim7; // timer for interrupt

GPIO_TypeDef *MotorDirectionPort = GPIOE;

// TimerClock is 240MHz, Prescaler is 12000, AutoReload is 1, so the frequency is 10kHz
#define TO_CCR(x) (uint16_t)((x) * 10)

// PID struct-------------------------------------------------------------------------------------------------------//

double TempSetpoint = 0;

AML_PID_Struct PID_LeftMotor =
    {
        .Kp = 0.1,
        .Ki = 2,
        .Kd = 0,
        .tau = 0.1,
        .limMin = 8,
        .limMax = 50,
        .linMinInt = 0,
        .linMaxInt = 25,
        .sampleTime = 20,
        .lastTime = 0,
        .integratol = 0,
        .prevError = 0,
        .differentiator = 0,
        .prevMeasurement = 0,
        .Input = 0,
        .Output = 0,
        .Setpoint = 0,
};

AML_PID_Struct PID_RightMotor =
    {
        .Kp = 1,
        .Ki = 0,
        .Kd = 0,
        .tau = 0,
        .limMin = 0,
        .limMax = 50,
        .linMinInt = 0,
        .linMaxInt = 15,
        .sampleTime = 5,
        .lastTime = 0,
        .integratol = 0,
        .prevError = 0,
        .differentiator = 0,
        .prevMeasurement = 0,
        .Input = 0,
        .Output = 0,
        .Setpoint = 0,
};

AML_PID_Struct PID_TurnLeft =
    {
        .Kp = 1,
        .Ki = 0,
        .Kd = 0,
        .tau = 0,
        .limMin = -MouseTurnSpeed,
        .limMax = MouseTurnSpeed,
        .linMinInt = -15,
        .linMaxInt = 15,
        .sampleTime = SampleTime,
        .lastTime = 0,
        .integratol = 0,
        .prevError = 0,
        .differentiator = 0,
        .prevMeasurement = 0,
        .Input = 0,
        .Output = 0,
        .Setpoint = 0,
};

AML_PID_Struct PID_TurnRight =
    {
        .Kp = 1,
        .Ki = 0,
        .Kd = 0,
        .tau = 0,
        .limMin = -MouseTurnSpeed,
        .limMax = MouseTurnSpeed,
        .linMinInt = -15,
        .linMaxInt = 15,
        .sampleTime = SampleTime,
        .lastTime = 0,
        .integratol = 0,
        .prevError = 0,
        .differentiator = 0,
        .prevMeasurement = 0,
        .Input = 0,
        .Output = 0,
        .Setpoint = 0,
};

AML_PID_Struct PID_MPUFollow =
    {
        .Kp = 0.5,
        .Ki = 0.1,
        .Kd = 0,
        .tau = 0,
        .limMin = -MouseSpeed,
        .limMax = MouseSpeed,
        .linMinInt = -15,
        .linMaxInt = 15,
        .sampleTime = SampleTime,
        .lastTime = 0,
        .integratol = 0,
        .prevError = 0,
        .differentiator = 0,
        .prevMeasurement = 0,
        .Input = 0,
        .Output = 0,
        .Setpoint = 0,
};

AML_PID_Struct PID_LeftWallFollow =
    {
        .Kp = 1,
        .Ki = 0,
        .Kd = 0,
        .tau = 0,
        .limMin = -MouseSpeed,
        .limMax = MouseSpeed,
        .linMinInt = -15,
        .linMaxInt = 15,
        .sampleTime = SampleTime,
        .lastTime = 0,
        .integratol = 0,
        .prevError = 0,
        .differentiator = 0,
        .prevMeasurement = 0,
        .Input = 0,
        .Output = 0,
        .Setpoint = 0,
};

AML_PID_Struct PID_RightWallFollow =
    {
        .Kp = 1,
        .Ki = 0,
        .Kd = 0,
        .tau = 0,
        .limMin = -MouseSpeed,
        .limMax = MouseSpeed,
        .linMinInt = -15,
        .linMaxInt = 15,
        .sampleTime = SampleTime,
        .lastTime = 0,
        .integratol = 0,
        .prevError = 0,
        .differentiator = 0,
        .prevMeasurement = 0,
        .Input = 0,
        .Output = 0,
        .Setpoint = 0,
};

// FUNCTION-----------------------------------------------------------------------------------------------------------------//
void AML_MotorControl_AMLPIDSetup(void);
void AML_MotorControl_Setup(void);
void AML_MotorControl_LeftPWM(int32_t DutyCycle);
void AML_MotorControl_RightPWM(int32_t DutyCycle);
void AML_MotorControl_Move(int32_t LeftDutyCycle, int32_t RightDutyCycle);
void AML_MotorControl_Stop(void);

void AML_MotorControl_GoStraghtWithMPU(double setpoint);
void AML_MotorControl_LeftWallFollow(void);
void AML_MotorControl_RightWallFollow(void);
void AML_MotorControl_GoStraight(void);

// Timer callback function-------------------------------------------------------------------------------------------------------//

void HAL_TIM_PeriodElapsedCallback(TIM_HandleTypeDef *htim)
{
    UNUSED(htim);
    if (htim->Instance == htim7.Instance) // timer for wall follow
    {
        AML_MotorControl_GoStraghtWithMPU(0);

        // AML_MotorControl_LeftMotorSpeed(30);
    }
}

void AML_MotorControl_TurnOnWallFollow(void)
{
    // AML_MPUSensor_ResetAngle();
    HAL_TIM_Base_Start_IT(&htim7);
}

void AML_MotorControl_TurnOffWallFollow(void)
{
    HAL_TIM_Base_Stop_IT(&htim7);
}

// PID setup function-------------------------------------------------------------------------------------------------------//
void AML_MotorControl_AMLPIDSetup(void)
{
}

// Motor control function-------------------------------------------------------------------------------------------------------//

// init motor control
void AML_MotorControl_Setup(void)
{
    HAL_TIM_Base_Start(&htim1);
    HAL_TIM_PWM_Start(&htim1, TIM_CHANNEL_1);
    HAL_TIM_PWM_Start(&htim1, TIM_CHANNEL_2);

    AML_MotorControl_AMLPIDSetup();
}

void AML_MotorControl_LeftPWM(int32_t DutyCycle)
{
    if (DutyCycle > 100)
    {
        DutyCycle = 100;
    }
    else if (DutyCycle < -100)
    {
        DutyCycle = -100;
    }

    if (DutyCycle > 0)
    {
        HAL_GPIO_WritePin(MotorDirectionPort, LEFT_MOTOR_IN1_Pin, LeftMotorDirection);
        HAL_GPIO_WritePin(MotorDirectionPort, LEFT_MOTOR_IN2_Pin, !LeftMotorDirection);
        __HAL_TIM_SET_COMPARE(&htim1, TIM_CHANNEL_1, TO_CCR(DutyCycle));
    }
    else if (DutyCycle < 0)
    {
        HAL_GPIO_WritePin(MotorDirectionPort, LEFT_MOTOR_IN1_Pin, !LeftMotorDirection);
        HAL_GPIO_WritePin(MotorDirectionPort, LEFT_MOTOR_IN2_Pin, LeftMotorDirection);
        __HAL_TIM_SET_COMPARE(&htim1, TIM_CHANNEL_1, TO_CCR(-DutyCycle));
    }
    else if (DutyCycle == 0)
    {
        HAL_GPIO_WritePin(MotorDirectionPort, LEFT_MOTOR_IN1_Pin, GPIO_PIN_RESET);
        HAL_GPIO_WritePin(MotorDirectionPort, LEFT_MOTOR_IN2_Pin, GPIO_PIN_RESET);
        __HAL_TIM_SET_COMPARE(&htim1, TIM_CHANNEL_1, 0);
    }
}

void AML_MotorControl_RightPWM(int32_t DutyCycle)
{
    DutyCycle = (int32_t)(DutyCycle * 1);

    if (DutyCycle > 100)
    {
        DutyCycle = 100;
    }
    else if (DutyCycle < -100)
    {
        DutyCycle = -100;
    }

    if (DutyCycle > 0)
    {
        HAL_GPIO_WritePin(MotorDirectionPort, RIGHT_MOTOR_IN1_Pin, RightMotorDirection);
        HAL_GPIO_WritePin(MotorDirectionPort, RIGHT_MOTOR_IN2_Pin, !RightMotorDirection);
        __HAL_TIM_SET_COMPARE(&htim1, TIM_CHANNEL_2, TO_CCR(DutyCycle));
    }
    else if (DutyCycle < 0)
    {
        HAL_GPIO_WritePin(MotorDirectionPort, RIGHT_MOTOR_IN1_Pin, !RightMotorDirection);
        HAL_GPIO_WritePin(MotorDirectionPort, RIGHT_MOTOR_IN2_Pin, RightMotorDirection);
        __HAL_TIM_SET_COMPARE(&htim1, TIM_CHANNEL_2, TO_CCR(-DutyCycle));
    }
    else if (DutyCycle == 0)
    {
        HAL_GPIO_WritePin(MotorDirectionPort, RIGHT_MOTOR_IN1_Pin, GPIO_PIN_RESET);
        HAL_GPIO_WritePin(MotorDirectionPort, RIGHT_MOTOR_IN2_Pin, GPIO_PIN_RESET);
        __HAL_TIM_SET_COMPARE(&htim1, TIM_CHANNEL_2, 0);
    }
}

void AML_MotorControl_Move(int32_t LeftDutyCycle, int32_t RightDutyCycle)
{
    AML_MotorControl_LeftPWM(LeftDutyCycle);
    AML_MotorControl_RightPWM(RightDutyCycle);
}

void AML_MotorControl_Stop(void)
{
    AML_MotorControl_Move(0, 0);
}

void AML_MotorControl_LeftMotorSpeed(int32_t rpm)
{
    PID_LeftMotor.Setpoint = (double)rpm;

    PID_LeftMotor.Input = ((double)AML_Encoder_GetLeftValue() / EncoderPulsePerRound) * (1000 / PID_LeftMotor.sampleTime) * 60; // 50 is the sample time
    AML_Encoder_ResetLeftValue();

    AML_PID_Compute(&PID_LeftMotor);

    AML_MotorControl_LeftPWM((int32_t)PID_LeftMotor.Output);
}

void AML_MotorControl_RightMotorSpeed(int32_t rpm)
{
    PID_RightMotor.Setpoint = (double)rpm;

    PID_RightMotor.Input = (double)AML_Encoder_GetRightValue() / EncoderPulsePerRound * 50 * 60; // 50 is the sample time
    AML_Encoder_ResetRightValue();

    AML_PID_Compute(&PID_RightMotor);

    AML_MotorControl_RightPWM((int32_t)PID_RightMotor.Output);
}

//--------------------------------------------------------------------------------------------------------//

void AML_MotorControl_GoStraghtWithMPU(double setpoint)
{
    PID_MPUFollow.Input = AML_MPUSensor_GetAngle();
    PID_MPUFollow.Setpoint = setpoint;

    AML_PID_Compute(&PID_MPUFollow);

    AML_MotorControl_Move(MouseSpeed - (int32_t)PID_MPUFollow.Output, MouseSpeed + (int32_t)PID_MPUFollow.Output);
}

void AML_MotorControl_LeftWallFollow(void)
{
    PID_LeftWallFollow.Input = AML_IRSensor_GetDistance(IR_SENSOR_RL);
    PID_LeftWallFollow.Setpoint = WALL_IN_LEFT;

    AML_PID_Compute(&PID_LeftWallFollow);
}

void AML_MotorControl_RightWallFollow(void)
{
    PID_RightWallFollow.Input = AML_IRSensor_GetDistance(IR_SENSOR_RR);
    PID_RightWallFollow.Setpoint = WALL_IN_RIGHT;

    AML_PID_Compute(&PID_RightWallFollow);
}

void AML_MotorControl_GoStraight(void)
{
    if (AML_IRSensor_IsNoLeftWall() && AML_IRSensor_IsNoRightWall())
    {
        AML_MotorControl_GoStraghtWithMPU(TempSetpoint);
    }
    else if (AML_IRSensor_IsLeftWall())
    {
        AML_MotorControl_LeftWallFollow();

        TempSetpoint = -PID_LeftWallFollow.Output;

        AML_MotorControl_GoStraghtWithMPU(TempSetpoint - PID_LeftWallFollow.Output);
    }
    else if (AML_IRSensor_IsRightWall())
    {
        AML_MotorControl_RightWallFollow();

        TempSetpoint = PID_RightWallFollow.Output;

        AML_MotorControl_GoStraghtWithMPU(TempSetpoint + PID_RightWallFollow.Output);
    }
}

//--------------------------------------------------------------------------------------------------------//

void AML_MotorControl_TurnLeft(void)
{
    uint16_t WaitingTime = 1500;

    PID_TurnLeft.Setpoint = AML_MPUSensor_GetAngle() + 90;

    uint32_t InitTime = HAL_GetTick();
    uint32_t CurrentTime = HAL_GetTick();
    uint32_t PreviousTime = CurrentTime;

    while ((CurrentTime - PreviousTime) < 200 && (HAL_GetTick() - InitTime < WaitingTime))
    {
        PID_TurnLeft.Input = AML_MPUSensor_GetAngle();

        AML_PID_Compute(&PID_TurnLeft);

        AML_MotorControl_LeftPWM(-(int32_t)PID_TurnLeft.Output);
        AML_MotorControl_RightPWM((int32_t)PID_TurnLeft.Output);

        if (ABS(PID_TurnLeft.Input - PID_TurnLeft.Setpoint) < 4.0f)
        {
            CurrentTime = HAL_GetTick();
        }
        else
        {
            CurrentTime = HAL_GetTick();
            PreviousTime = CurrentTime;
        }
    }

    AML_MotorControl_Stop();
}
