anmh1205/AML_MicroMouse_2024/1. MicroMouse Code/2. MicroMouse - STM32F407VGT6/PCB_AIO_V2_CODE/Core/Inc/main.h

#define BIT_SW_0_Pin GPIO_PIN_2
#define BIT_SW_0_GPIO_Port GPIOE
#define BIT_SW_1_Pin GPIO_PIN_3
#define BIT_SW_1_GPIO_Port GPIOE
#define BIT_SW_2_Pin GPIO_PIN_4
#define BIT_SW_2_GPIO_Port GPIOE
#define BIT_SW_3_Pin GPIO_PIN_5
#define BIT_SW_3_GPIO_Port GPIOE
#define BIT_SW_4_Pin GPIO_PIN_6
#define BIT_SW_4_GPIO_Port GPIOE
#define IR_SENSOR_FR_Pin GPIO_PIN_0
#define IR_SENSOR_FR_GPIO_Port GPIOC
#define IR_SENSOR_RR_Pin GPIO_PIN_1
#define IR_SENSOR_RR_GPIO_Port GPIOC
#define RIGHT_ENCODER_A_Pin GPIO_PIN_0
#define RIGHT_ENCODER_A_GPIO_Port GPIOA
#define RIGHT_ENCODER_B_Pin GPIO_PIN_1
#define RIGHT_ENCODER_B_GPIO_Port GPIOA
#define IR_SENSOR_BR_Pin GPIO_PIN_2
#define IR_SENSOR_BR_GPIO_Port GPIOA
#define IR_SENSOR_BL_Pin GPIO_PIN_3
#define IR_SENSOR_BL_GPIO_Port GPIOA
#define IR_SENSOR_RL_Pin GPIO_PIN_6
#define IR_SENSOR_RL_GPIO_Port GPIOA
#define IR_SENSOR_FL_Pin GPIO_PIN_4
#define IR_SENSOR_FL_GPIO_Port GPIOC
#define IR_SENSOR_FF_Pin GPIO_PIN_1
#define IR_SENSOR_FF_GPIO_Port GPIOB
#define LEFT_MOTOR_IN1_Pin GPIO_PIN_7
#define LEFT_MOTOR_IN1_GPIO_Port GPIOE
#define LEFT_MOTOR_IN2_Pin GPIO_PIN_8
#define LEFT_MOTOR_IN2_GPIO_Port GPIOE
#define LEFT_MOTOR_PWM_Pin GPIO_PIN_9
#define LEFT_MOTOR_PWM_GPIO_Port GPIOE
#define RIGHT_MOTOR_PWM_Pin GPIO_PIN_11
#define RIGHT_MOTOR_PWM_GPIO_Port GPIOE
#define RIGHT_MOTOR_IN1_Pin GPIO_PIN_12
#define RIGHT_MOTOR_IN1_GPIO_Port GPIOE
#define RIGHT_MOTOR_IN2_Pin GPIO_PIN_13
#define RIGHT_MOTOR_IN2_GPIO_Port GPIOE
#define LEFT_ENCODER_A_Pin GPIO_PIN_15
#define LEFT_ENCODER_A_GPIO_Port GPIOA
#define LED_0_Pin GPIO_PIN_0
#define LED_0_GPIO_Port GPIOD
#define LED_1_Pin GPIO_PIN_1
#define LED_1_GPIO_Port GPIOD
#define LED_2_Pin GPIO_PIN_2
#define LED_2_GPIO_Port GPIOD
#define LED_3_Pin GPIO_PIN_3
#define LED_3_GPIO_Port GPIOD
#define LEFT_ENCODER_B_Pin GPIO_PIN_3
#define LEFT_ENCODER_B_GPIO_Port GPIOB
#define BUTTON_0_Pin GPIO_PIN_0
#define BUTTON_0_GPIO_Port GPIOE
#define BUTTON_1_Pin GPIO_PIN_1
#define BUTTON_1_GPIO_Port GPIOE
