anmh1205/AML_MicroMouse_2024/1. MicroMouse Code/2. MicroMouse - STM32F407VGT6/V1_F743VIT6/Core/Inc/main.h

#define N_TOF_Pin GPIO_PIN_0
#define N_TOF_GPIO_Port GPIOC
#define W_TOF_Pin GPIO_PIN_1
#define W_TOF_GPIO_Port GPIOC
#define S_TOF_Pin GPIO_PIN_2
#define S_TOF_GPIO_Port GPIOC
#define E_TOF_Pin GPIO_PIN_3
#define E_TOF_GPIO_Port GPIOC
#define NE_ENC_A_Pin GPIO_PIN_0
#define NE_ENC_A_GPIO_Port GPIOA
#define NE_ENC_B_Pin GPIO_PIN_1
#define NE_ENC_B_GPIO_Port GPIOA
#define NW_ENC_A_Pin GPIO_PIN_5
#define NW_ENC_A_GPIO_Port GPIOA
#define SW_ENC_A_Pin GPIO_PIN_6
#define SW_ENC_A_GPIO_Port GPIOA
#define SW_ENC_B_Pin GPIO_PIN_7
#define SW_ENC_B_GPIO_Port GPIOA
#define NW_IN1_Pin GPIO_PIN_0
#define NW_IN1_GPIO_Port GPIOB
#define NW_IN2_Pin GPIO_PIN_1
#define NW_IN2_GPIO_Port GPIOB
#define SW_IN1_Pin GPIO_PIN_2
#define SW_IN1_GPIO_Port GPIOB
#define SW_IN2_Pin GPIO_PIN_7
#define SW_IN2_GPIO_Port GPIOE
#define SE_IN1_Pin GPIO_PIN_8
#define SE_IN1_GPIO_Port GPIOE
#define NW_PWM_Pin GPIO_PIN_9
#define NW_PWM_GPIO_Port GPIOE
#define SE_IN2_Pin GPIO_PIN_10
#define SE_IN2_GPIO_Port GPIOE
#define SW_PWM_Pin GPIO_PIN_11
#define SW_PWM_GPIO_Port GPIOE
#define NE_IN1_Pin GPIO_PIN_12
#define NE_IN1_GPIO_Port GPIOE
#define SE_PWM_Pin GPIO_PIN_13
#define SE_PWM_GPIO_Port GPIOE
#define NE_PWM_Pin GPIO_PIN_14
#define NE_PWM_GPIO_Port GPIOE
#define NE_IN2_Pin GPIO_PIN_15
#define NE_IN2_GPIO_Port GPIOE
#define SE_ENC_A_Pin GPIO_PIN_12
#define SE_ENC_A_GPIO_Port GPIOD
#define SE_ENC_B_Pin GPIO_PIN_13
#define SE_ENC_B_GPIO_Port GPIOD
#define NW_SERVO_Pin GPIO_PIN_6
#define NW_SERVO_GPIO_Port GPIOC
#define SW_SERVO_Pin GPIO_PIN_7
#define SW_SERVO_GPIO_Port GPIOC
#define SE_SERVO_Pin GPIO_PIN_8
#define SE_SERVO_GPIO_Port GPIOC
#define NE_SERVO_Pin GPIO_PIN_9
#define NE_SERVO_GPIO_Port GPIOC
#define BUTTON_0_Pin GPIO_PIN_0
#define BUTTON_0_GPIO_Port GPIOD
#define BUTTON_1_Pin GPIO_PIN_1
#define BUTTON_1_GPIO_Port GPIOD
#define LED_0_Pin GPIO_PIN_2
#define LED_0_GPIO_Port GPIOD
#define LED_1_Pin GPIO_PIN_3
#define LED_1_GPIO_Port GPIOD
#define LED_2_Pin GPIO_PIN_4
#define LED_2_GPIO_Port GPIOD
#define LED_3_Pin GPIO_PIN_5
#define LED_3_GPIO_Port GPIOD
#define NW_ENC_B_Pin GPIO_PIN_3
#define NW_ENC_B_GPIO_Port GPIOB
