anmh1205/AML_MicroMouse_2024/1. MicroMouse Code/2. MicroMouse - STM32F407VGT6/PCB_AIO_V2_CODE/Core/Inc/AML_MotorControl.h

#ifndef AML_MOTORCONTROL_H
#define AML_MOTORCONTROL_H

#include "stm32h7xx_hal.h"
#include "main.h"
#include "AML_PID.h"

#include "AML_GlobalVariable.h"
#include "AML_LedDebug.h"
#include "AML_Buzzer.h"
#include "AML_Switch.h"
#include "AML_IMU.h"

void AML_MotorControl_AMLPIDSetup(void);
void AML_MotorControl_Setup(void);
void AML_MotorControl_LeftPWM(int32_t DutyCycle);
void AML_MotorControl_RightPWM(int32_t DutyCycle);
void AML_MotorControl_Move(int32_t LeftDutyCycle, int32_t RightDutyCycle);
void AML_MotorControl_Stop(void);

void AML_MotorControl_LeftMotorSpeed(int32_t rpm);

void AML_MotorControl_TurnOnWallFollow(void);
void AML_MotorControl_TurnOffWallFollow(void);
void AML_MotorControl_GoStraghtWithMPU(double setpoint);

#endif // AML_MOTORCONTROL_H
