anmh1205/AML_MicroMouse_2024/1. MicroMouse Code/2. MicroMouse - STM32F407VGT6/PCB_AIO_V2_CODE/Core/Src/AML_IRSensor.c

#include "AML_IRSensor.h"

/*
    distance low range: y = 33,9 + -69,5x + 62,3x^2 + -25,4x^3 + 3,83x^4
    distance high range: y = 12.08 * x^(-1.058)
*/

#define ADC_RESOLUTION_BIT 16
#define ADC_MAX (1 << ADC_RESOLUTION_BIT) // 2^14 = 16384
#define ADC_VREF 3.3

#define GET_VOLTAGE(adcValue) ((adcValue * ADC_VREF) / ADC_MAX)
#define GET_DISTANCE_2_15(voltage) (33.9 + (-69.5 * voltage) + (62.3 * pow(voltage, 2)) + (-25.4 * pow(voltage, 3)) + (3.83 * pow(voltage, 4))) * 10 // mm
#define GET_DISTANCE_4_30(voltage) (12.08 * pow(voltage, -1.058)) * 10                                                                               // mm

#define GET_DISTANCE(voltage, index) (index > 0) ? GET_DISTANCE_2_15(voltage) : GET_DISTANCE_4_30(voltage)

extern debug[100];

extern ADC_HandleTypeDef hadc2;

uint16_t IRSensorADCValue[7];
// double IRSensorVoltageValue[7];
double IRSensorDistanceValue[7];

uint8_t ADCIndex = 0;

//-------------------------------------------------------------------------------------------------------//
void AML_IRSensor_Setup(void);
void HAL_ADC_ConvCpltCallback(ADC_HandleTypeDef *hadc);
double AML_IRSensor_GetDistance(uint8_t sensor);

bool AML_IRSensor_IsFrontWall(void);
bool AML_IRSensor_IsLeftWall(void);
bool AML_IRSensor_IsRightWall(void);

bool AML_IRSensor_IsNoFrontWall(void);
bool AML_IRSensor_IsNoLeftWall(void);
bool AML_IRSensor_IsNoRightWall(void);

//-------------------------------------------------------------------------------------------------------//

void AML_IRSensor_Setup(void)
{
    memset(IRSensorADCValue, 0, sizeof(IRSensorADCValue));

    // HAL_ADC_Start_DMA(&hadc2, (uint32_t *)IRSensorADCValue, 7);
    HAL_ADC_Start_IT(&hadc2);
}

void HAL_ADC_ConvCpltCallback(ADC_HandleTypeDef *hadc)
{
    UNUSED(hadc);

    if (hadc->Instance == ADC2)
    {
        IRSensorADCValue[ADCIndex] = HAL_ADC_GetValue(hadc);
        IRSensorDistanceValue[ADCIndex] = GET_DISTANCE(GET_VOLTAGE(IRSensorADCValue[ADCIndex]), ADCIndex);

        // IRSensorVoltageValue[ADCIndex] = GET_VOLTAGE(IRSensorADCValue[ADCIndex]);
        // IRSensorDistanceValue[ADCIndex] = GET_DISTANCE(IRSensorVoltageValue[ADCIndex], ADCIndex);

        ADCIndex++;

        if (ADCIndex == 7)
        {
            ADCIndex = 0;
            // HAL_ADC_Start_IT(&hadc2);
        }
    }
}

//-------------------------------------------------------------------------------------------------------//

double AML_IRSensor_GetDistance(uint8_t sensor)
{
    return IRSensorDistanceValue[sensor];
}

//-------------------------------------------------------------------------------------------------------//

bool AML_IRSensor_IsFrontWall(void)
{
    return (IRSensorDistanceValue[IR_SENSOR_FF] < WALL_IN_FRONT) ? 1 : 0;
}

bool AML_IRSensor_IsLeftWall(void)
{
    return (IRSensorDistanceValue[IR_SENSOR_RL] < WALL_IN_LEFT) ? 1 : 0;
}

bool AML_IRSensor_IsRightWall(void)
{
    return (IRSensorDistanceValue[IR_SENSOR_RR] < WALL_IN_RIGHT) ? 1 : 0;
}

bool AML_IRSensor_IsNoFrontWall(void)
{
    return (IRSensorDistanceValue[IR_SENSOR_FF] > WALL_NOT_IN_FRONT) ? 1 : 0;
}

bool AML_IRSensor_IsNoLeftWall(void)
{
    return (IRSensorDistanceValue[IR_SENSOR_RL] > WALL_NOT_IN_LEFT) ? 1 : 0;
}

bool AML_IRSensor_IsNoRightWall(void)
{
    return (IRSensorDistanceValue[IR_SENSOR_RR] > WALL_NOT_IN_RIGHT) ? 1 : 0;
}
//-------------------------------------------------------------------------------------------------------//
