anmh1205/AML_MicroMouse_2024/1. MicroMouse Code/2. MicroMouse - STM32F407VGT6/PCB_AIO_V2_CODE/Core/Src/AML_Encoder.c

#include "AML_Encoder.h"

extern TIM_HandleTypeDef htim2;
extern TIM_HandleTypeDef htim5;

void AML_Encoder_Setup(void)
{
    HAL_TIM_Encoder_Start(&htim2, TIM_CHANNEL_ALL); // left encoder
    HAL_TIM_Encoder_Start(&htim5, TIM_CHANNEL_ALL); // right encoder
}

int32_t AML_Encoder_GetLeftValue(void)
{
    return __HAL_TIM_GET_COUNTER(&htim2);
}

void AML_Encoder_ResetLeftValue(void)
{
    __HAL_TIM_SET_COUNTER(&htim2, 0);
}

int32_t AML_Encoder_GetRightValue(void)
{
    return __HAL_TIM_GET_COUNTER(&htim5);
}

void AML_Encoder_ResetRightValue(void)
{
    __HAL_TIM_SET_COUNTER(&htim5, 0);
}
