anmh1205/AML_MicroMouse_2024/1. MicroMouse Code/2. MicroMouse - STM32F407VGT6/PCB_V1/Core/Inc/AML_Encoder.h

#ifndef AML_ENCODER_H
#define AML_ENCODER_H

#include "stm32f4xx_hal.h"


void AML_Encoder_Setup(void);
int16_t AML_Encoder_GetLeftValue(void);
int16_t AML_Encoder_GetRightValue(void);
void AML_Encoder_ResetLeftValue(void);
void AML_Encoder_ResetRightValue(void);

#endif // AML_ENCODER_H
