anmh1205/AML_MicroMouse_2024/1. MicroMouse Code/2. MicroMouse - STM32F407VGT6/PCB_V1/Core/Src/AML_Encoder.c

#include "AML_Encoder.h"

extern TIM_HandleTypeDef htim1;
extern TIM_HandleTypeDef htim4;

void AML_Encoder_Setup(void)
{
    HAL_TIM_Encoder_Start(&htim1, TIM_CHANNEL_ALL); // left encoder
    HAL_TIM_Encoder_Start(&htim4, TIM_CHANNEL_ALL); // right encoder
}

int16_t AML_Encoder_GetLeftValue(void)
{
    return __HAL_TIM_GET_COUNTER(&htim1);
}

void AML_Encoder_ResetLeftValue(void)
{
    __HAL_TIM_SET_COUNTER(&htim1, 0);
}

int16_t AML_Encoder_GetRightValue(void)
{
    return __HAL_TIM_GET_COUNTER(&htim4);
}

void AML_Encoder_ResetRightValue(void)
{
    __HAL_TIM_SET_COUNTER(&htim4, 0);
}
