anmh1205/AML_MicroMouse_2024/1. MicroMouse Code/2. MicroMouse - STM32F407VGT6/PCB_AIO_V2_CODE/Core/Src/solver.c

#include "solver.h"

#define SIMULATION_BOOL 0 // 1 if you're running the simulation, 0 if you're running the actual robot

unsigned int maze[MAZE_SIZE][MAZE_SIZE] = {0};
int distances[MAZE_SIZE][MAZE_SIZE] = {-1}; // 1000 if it hasn't been visited yet
struct Coordinate position;
Heading heading;

int reached_center = 0; // "boolean" that stores whether the mouse should start exploring more squares

void initialize(void)
{
    // setting the borders
    for (int i = 1; i < MAZE_SIZE - 1; ++i)
    {
        maze[0][i] = _0001;             // khoi tao tuong huong tay
        maze[i][0] = _0010;             // khoi tao tuong huong nam
        maze[i][MAZE_SIZE - 1] = _1000; // khoi tao tuong huong bac
        maze[MAZE_SIZE - 1][i] = _0100; // khoi tao tuong huong dong
    }
    maze[0][0] = _0011;                         // khoi tao goc tuong duoi cung ben trai
    maze[0][MAZE_SIZE - 1] = _1001;             // khoi tao goc tuong duoi cung ben phai
    maze[MAZE_SIZE - 1][0] = _0110;             // khoi tao goc tuong tren cuong ben trai
    maze[MAZE_SIZE - 1][MAZE_SIZE - 1] = _1100; // khoi tao goc tuong tren cung ben phai

    // setting initial distances - cau hinh khoang cach
    resetDistances();

    // setting mouse position + heading
    position.x = 0;
    position.y = 0;
    heading = NORTH;
}

/*
Updates the maze's walls based on what the mouse can currently see
*/
void updateMaze(void)
{
    int x = position.x;
    int y = position.y;
    // start by assuming there are no walls, this variable will be changed based on which walls you see
    unsigned int walls = _0000;

    switch (heading)
    {
    case NORTH:
        if (CHECK_WALL_FRONT)
        {
            walls |= _1000; // stores the wall to the north in walls (to be updated at the end of switch statement)
            // updating neighboring squares as well (if there is one):
            // neu dung thi cap nhat tuong do thanh tuong huong nam cua o tiep theo
            if (y + 1 != MAZE_SIZE)
                maze[x][y + 1] |= _0010;
        }
        if (CHECK_WALL_LEFT)
        {
            walls |= _0001;
            // neu co tuong ben trai thi dat tuong huong tay
            //  dat tuong do thanh tuong huong ong cua o ben canh
            if (x - 1 >= 0)
                maze[x - 1][y] |= _0100;
        }
        if (CHECK_WALL_RIGHT)
        {
            walls |= _0100; // dat tuong huong dong
            // dat tuong do thanh tuong huong tay cua o ben canh
            if (x + 1 != MAZE_SIZE)
                maze[x + 1][y] |= _0001;
        }
        break;
        // tuong tu nhu huong bac
    case EAST:
        if (CHECK_WALL_FRONT)
        {
            walls |= _0100;
            if (x + 1 != MAZE_SIZE)
                maze[x + 1][y] |= _0001;
        }
        if (CHECK_WALL_LEFT)
        {
            walls |= _1000;
            if (y + 1 != MAZE_SIZE)
                maze[x][y + 1] |= _0010;
        }
        if (CHECK_WALL_RIGHT)
        {
            walls |= _0010;
            if (y - 1 >= 0)
                maze[x][y - 1] |= _1000;
        }
        break;
    case SOUTH:
        if (CHECK_WALL_FRONT)
        {
            walls |= _0010;
            if (y - 1 >= 0)
                maze[x][y - 1] |= _1000;
        }
        if (CHECK_WALL_LEFT)
        {
            walls |= _0100;
            if (x + 1 != MAZE_SIZE)
                maze[x + 1][y] |= _0001;
        }
        if (CHECK_WALL_RIGHT)
        {
            walls |= _0001;
            if (x - 1 >= 0)
                maze[x - 1][y] |= _0100;
        }
        break;
    case WEST:
        if (CHECK_WALL_FRONT)
        {
            walls |= _0001;
            if (x - 1 >= 0)
                maze[x - 1][y] |= _0100;
        }
        if (CHECK_WALL_LEFT)
        {
            walls |= _0010;
            if (y - 1 >= 0)
                maze[x][y - 1] |= _1000;
        }
        if (CHECK_WALL_RIGHT)
        {
            walls |= _1000;
            if (y + 1 != MAZE_SIZE)
                maze[x][y + 1] |= _0010;
        }
        break;
    }

    maze[x][y] |= walls;

    // setting the walls in the simulator
#if SIMULATION_BOOL
    unsigned int north = _1000;
    if (maze[x][y] >= 8)
    {
        API_setWall(x, y, 'n');
        // debug_log("There's a wall to the north");
    }
    if (maze[x][y] % 8 >= 4)
    {
        API_setWall(x, y, 'e');
        // debug_log("There's a wall to the east");
    }
    if (maze[x][y] % 4 >= 2)
    {
        API_setWall(x, y, 's');
        // debug_log("There's a wall to the south");
    }
    if (maze[x][y] % 2 == 1)
    {
        API_setWall(x, y, 'w');
        // debug_log("There's a wall to the west");
    }
#endif
}
// chuyen doi mang 2d thanh mang 1d bieu dien boi cac so nguyen
int xyToSquare(int x, int y)
{
    return x + MAZE_SIZE * y;
}
// chuyen nguoc lai tu so thu tu o vuong sang toa do xy
struct Coordinate squareToCoord(int square)
{
    struct Coordinate coord;
    coord.x = square % MAZE_SIZE;
    coord.y = square / MAZE_SIZE;
    return coord;
}

void resetDistances(void)
{
    // initially sets all the distances to -1 (invalid distance)
    for (int x = 0; x < MAZE_SIZE; ++x)
    {
        for (int y = 0; y < MAZE_SIZE; ++y)
        {
            distances[x][y] = -1;
        }
    }

    // if you haven't reached the center, set the goal to be the center
    if (!reached_center)
    {
        // sets goal distances
        if (MAZE_SIZE % 2 == 0)
        {
            /*
            neu ma tran chan thi dat 4 o o trung tam la dich
            */
            distances[MAZE_SIZE / 2][MAZE_SIZE / 2] = 0;
            distances[MAZE_SIZE / 2 - 1][MAZE_SIZE / 2] = 0;
            distances[MAZE_SIZE / 2][MAZE_SIZE / 2 - 1] = 0;
            distances[MAZE_SIZE / 2 - 1][MAZE_SIZE / 2 - 1] = 0;
        }
        else
        {
            distances[MAZE_SIZE / 2][MAZE_SIZE / 2] = 0;
        }
    }
    else
    {
        distances[0][0] = 0; // go back to the start
    }
}

int isWallInDirection(int x, int y, Heading direction)
{
    switch (direction)
    {
    case NORTH:
        if (maze[x][y] >= 8)
            return 1;
        break;
    case EAST:
        if (maze[x][y] % 8 >= 4)
            return 1;
        break;
    case SOUTH:
        if (maze[x][y] % 4 >= 2)
            return 1;
        break;
    case WEST:
        if (maze[x][y] % 2 == 1)
            return 1;
        break;
    }
    return 0;
}

void updateDistances(void)
{
    resetDistances();
    queue squares = queue_create();

    // adds the goal squares to the queue (the middle of the maze or the starting position depending on if you've reached the center)
    for (int x = 0; x < MAZE_SIZE; ++x)
    {
        for (int y = 0; y < MAZE_SIZE; ++y)
        {
            if (distances[x][y] == 0)
                queue_push(squares, xyToSquare(x, y));
        }
    }

    while (!queue_is_empty(squares))
    {
        struct Coordinate square = squareToCoord(queue_pop(squares));
        int x = square.x;
        int y = square.y;

        // if there's no wall to the north && the square to the north hasn't been checked yet
        if (isWallInDirection(x, y, NORTH) == 0 && distances[x][y + 1] == -1)
        {
            distances[x][y + 1] = distances[x][y] + 1;
            queue_push(squares, xyToSquare(x, y + 1));
        }
        // same as ^ but for east
        if (isWallInDirection(x, y, EAST) == 0 && distances[x + 1][y] == -1)
        {
            distances[x + 1][y] = distances[x][y] + 1;
            queue_push(squares, xyToSquare(x + 1, y));
        }
        // same as ^ but for south
        if (isWallInDirection(x, y, SOUTH) == 0 && distances[x][y - 1] == -1)
        {
            distances[x][y - 1] = distances[x][y] + 1;
            queue_push(squares, xyToSquare(x, y - 1));
        }
        // same as ^ but for west
        if (isWallInDirection(x, y, WEST) == 0 && distances[x - 1][y] == -1)
        {
            distances[x - 1][y] = distances[x][y] + 1;
            queue_push(squares, xyToSquare(x - 1, y));
        }
    }
}

void updateHeading(Action nextAction)
{
    if (nextAction == FORWARD || nextAction == IDLE)
    {
        return;
    }
    else if (nextAction == LEFT)
    {
        switch (heading)
        {
        case NORTH:
            heading = WEST;
            break;
        case EAST:
            heading = NORTH;
            break;
        case SOUTH:
            heading = EAST;
            break;
        case WEST:
            heading = SOUTH;
            break;
        default:
            break;
        }
    }
    else if (nextAction == RIGHT)
    {
        switch (heading)
        {
        case NORTH:
            heading = EAST;
            break;
        case EAST:
            heading = SOUTH;
            break;
        case SOUTH:
            heading = WEST;
            break;
        case WEST:
            heading = NORTH;
            break;
        default:
            break;
        }
    }
}

void updatePosition(Action nextAction)
{
    if (nextAction != FORWARD)
    {
        return;
    }

    switch (heading)
    {
    case NORTH:
        position.y += 1;
        break;
    case SOUTH:
        position.y -= 1;
        break;
    case EAST:
        position.x += 1;
        break;
    case WEST:
        position.x -= 1;
        break;
    default:
        break;
    }
}

Action solver(void)
{
    // if you reached the center, go back to the start
    if (!reached_center && distances[position.x][position.y] == 0)
    {
        reached_center = 1;
    }
    // if you went to the center & all the way back to the start, restart
    else if (reached_center && distances[position.x][position.y] == 0)
    {
        reached_center = 0;
    }

    updateMaze();
    updateDistances();

    Action action = floodFill();

    updateHeading(action);
    updatePosition(action);
    return action;
}

// Put your implementation of floodfill here!
Action floodFill(void)
{
    unsigned int least_distance = 300; // just some large number, none of the distances will be over 300
    Action optimal_move = IDLE;

    /*
    Basic Idea:
    - Look at the square in front of you, to the left, and to the right if there are no walls
    - Find the square with the lowest distance to the goal
    - Move in the direction of that square (move forward if it's the forward square, turn in the correct direction otherwise)
    */

    if (heading == NORTH)
    {
        if (!isWallInDirection(position.x, position.y, NORTH) && distances[position.x][position.y + 1] < least_distance)
        {
            least_distance = distances[position.x][position.y + 1];
            optimal_move = FORWARD;
        }
        if (!isWallInDirection(position.x, position.y, EAST) && distances[position.x + 1][position.y] < least_distance)
        {
            least_distance = distances[position.x + 1][position.y];
            optimal_move = RIGHT;
        }
        if (!isWallInDirection(position.x, position.y, WEST) && distances[position.x - 1][position.y] < least_distance)
        {
            least_distance = distances[position.x - 1][position.y];
            optimal_move = LEFT;
        }
    }
    else if (heading == EAST)
    {
        if (!isWallInDirection(position.x, position.y, EAST) && distances[position.x + 1][position.y] < least_distance)
        {
            least_distance = distances[position.x + 1][position.y];
            optimal_move = FORWARD;
        }
        if (!isWallInDirection(position.x, position.y, SOUTH) && distances[position.x][position.y - 1] < least_distance)
        {
            least_distance = distances[position.x][position.y - 1];
            optimal_move = RIGHT;
        }
        if (!isWallInDirection(position.x, position.y, NORTH) && distances[position.x][position.y + 1] < least_distance)
        {
            least_distance = distances[position.x][position.y + 1];
            optimal_move = LEFT;
        }
    }
    else if (heading == SOUTH)
    {
        if (!isWallInDirection(position.x, position.y, SOUTH) && distances[position.x][position.y - 1] < least_distance)
        {
            least_distance = distances[position.x][position.y - 1];
            optimal_move = FORWARD;
        }
        if (!isWallInDirection(position.x, position.y, WEST) && distances[position.x - 1][position.y] < least_distance)
        {
            least_distance = distances[position.x - 1][position.y];
            optimal_move = RIGHT;
        }
        if (!isWallInDirection(position.x, position.y, EAST) && distances[position.x + 1][position.y] < least_distance)
        {
            least_distance = distances[position.x + 1][position.y];
            optimal_move = LEFT;
        }
    }
    else if (heading == WEST)
    {
        if (!isWallInDirection(position.x, position.y, WEST) && distances[position.x - 1][position.y] < least_distance)
        {
            least_distance = distances[position.x - 1][position.y];
            optimal_move = FORWARD;
        }
        if (!isWallInDirection(position.x, position.y, NORTH) && distances[position.x][position.y + 1] < least_distance)
        {
            least_distance = distances[position.x][position.y + 1];
            optimal_move = RIGHT;
        }
        if (!isWallInDirection(position.x, position.y, SOUTH) && distances[position.x][position.y - 1] < least_distance)
        {
            least_distance = distances[position.x][position.y - 1];
            optimal_move = LEFT;
        }
    }

    // handles dead ends (when there's no walls in front, to the right or to the left)
    if (least_distance == 300)
        optimal_move = RIGHT; // arbitrary, can be any turn

    return optimal_move;
}
