anmh1205/AML_MicroMouse_2024/1. MicroMouse Code/2. MicroMouse - STM32F407VGT6/PCB_AIO_V2_CODE/Core/Inc/AML_IMU.h

#ifndef AML_IMU_H
#define AML_IMU_H

#include "stm32h7xx_hal.h"
#include <stm32h743xx.h>
// #include "stm32f4xx_hal_uart.h"

void AML_MPUSensor_Setup(UART_HandleTypeDef *imu_uart);
void AML_MPUSensor_ResetAngle(void);
double AML_MPUSensor_GetAngle(void);

#endif
