anmh1205/AML_MicroMouse_2024/1. MicroMouse Code/2. MicroMouse - STM32F407VGT6/PCB_AIO_V2_CODE/Core/Src/queue.c

#include "queue.h"

queue queue_create(void)
{
    queue q = (queue)malloc(sizeof(struct _queue));
    if (q == NULL)
    {
        // fprintf(stderr, "Insufficient memory to \
        // initialize queue.\n");
        // abort();
    }
    q->head = NULL;
    q->tail = NULL;
    q->size = 0;
    return q;
}

void queue_destroy(queue q)
{
    if (q == NULL)
    {
        // fprintf(stderr, "Cannot destroy queue\n");
        // abort();
    }
    queue_clear(q);
    free(q);
}

void queue_push(queue q, int elem)
{
    struct node *n;
    n = (struct node *)malloc(sizeof(struct node));
    if (n == NULL)
    {
        // fprintf(stderr, "Insufficient memory to \
        // create node.\n");
        // abort();
    }
    n->data = elem;
    n->next = NULL;
    if (q->head == NULL)
    {
        q->head = q->tail = n;
    }
    else
    {
        q->tail->next = n;
        q->tail = n;
    }
    q->size += 1;
}

int queue_pop(queue q)
{
    if (queue_is_empty(q))
    {
        //     fprintf(stderr, "Can't pop element from queue: \
    // queue is empty.\n");
        //     abort();
    }
    struct node *head = q->head;
    if (q->head == q->tail)
    {
        q->head = NULL;
        q->tail = NULL;
    }
    else
    {
        q->head = q->head->next;
    }
    q->size -= 1;
    int data = head->data;
    free(head);
    return data;
}

int queue_first(queue q)
{
    if (queue_is_empty(q))
    {
        // fprintf(stderr, "Can't return element from queue: \
        // queue is empty.\n");
        // abort();
    }
    return q->head->data;
}

int queue_is_empty(queue q)
{
    if (q == NULL)
    {
        // fprintf(stderr, "Cannot work with NULL queue.\n");
        // abort();
    }
    return q->head == NULL;
}

int queue_size(queue q)
{
    if (q == NULL)
    {
        // fprintf(stderr, "Cannot work with NULL queue.\n");
        // abort();
    }
    return q->size;
}

void queue_clear(queue q)
{
    if (q == NULL)
    {
        // fprintf(stderr, "Cannot work with NULL queue.\n");
        // abort();
    }
    while (q->head != NULL)
    {
        struct node *tmp = q->head;
        q->head = q->head->next;
        free(tmp);
    }
    q->tail = NULL;
    q->size = 0;
}
