anmh1205/AML_MicroMouse_2024/1. MicroMouse Code/2. MicroMouse - STM32F407VGT6/PCB_V1/Core/Inc/AML_Keyboard.h

#ifndef AML_KEYBOARD_H
#define AML_KEYBOARD_H

#include "stm32f4xx_hal.h"
#include "main.h"
#include "AML_MotorControl.h"
#include "AML_DebugDevice.h"

// Button number
#define ButtonPORT GPIOE



GPIO_PinState AML_Keyboard_GetKey(uint8_t key);



#endif // AML_KEYBOARD_H
