anmh1205/AML_MicroMouse_2024/1. MicroMouse Code/2. MicroMouse - STM32F407VGT6/PCB_V1/Core/Inc/AML_Remote.h

#ifndef AML_REMOTE_H
#define AML_REMOTE_H

#include "stm32f4xx_hal.h"
#include "main.h"
#include "AML_MotorControl.h"
#include "AML_DebugDevice.h"
#include "pid.h"

#include "stdio.h"
#include "stdlib.h"
#include "string.h"

void AML_Remote_Setup(void);
void AML_Remote_Handle(void);

#endif // AML_REMOTE_H
