anmh1205/AML_MicroMouse_2024/1. MicroMouse Code/2. MicroMouse - STM32F407VGT6/PCB_V1/Core/Inc/vl53l0x_platform.h

/**
  ******************************************************************************
  * @file    vl53l0x_platform.h
  * @author  MCD Application Team
  * @brief   VL53l0x platform include file
  ******************************************************************************
  * @attention
  *
  * Copyright (c) 2017 STMicroelectronics.
  * All rights reserved.
  *
  * This software is licensed under terms that can be found in the LICENSE file
  * in the root directory of this software component.
  * If no LICENSE file comes with this software, it is provided AS-IS.
  *
  ******************************************************************************
  */

/* Define to prevent recursive inclusion -------------------------------------*/
#ifndef __VL53L0X_PLATFORM_H
#define __VL53L0X_PLATFORM_H

#ifdef __cplusplus
 extern "C" {
#endif

/* Includes ------------------------------------------------------------------*/
#include "stm32f4xx_hal.h"
#include "vl53l0x_def.h"
#include "vl53l0x_platform_log.h"
#include "vl53l0x_tof.h"

/* Exported types ------------------------------------------------------------*/
/* Exported constants --------------------------------------------------------*/
/* Exported macros -----------------------------------------------------------*/
/* Private macros ------------------------------------------------------------*/
/* Exported functions --------------------------------------------------------*/

#ifdef __cplusplus
}
#endif

#endif /* __VL53L0X_PLATFORM_H */
