anmh1205/AML_MicroMouse_2024/1. MicroMouse Code/2. MicroMouse - STM32F407VGT6/PCB_V1/Core/Src/AML_Remote.c

#include "AML_Remote.h"

extern UART_HandleTypeDef huart6;
// extern int16_t debug[100];

volatile uint8_t RemoteData[48];
volatile uint8_t RemoteBuffer = 119;
volatile uint8_t RemoteIndex = 0;
uint8_t ErrorString[] = "E";
uint8_t SuccessString[] = "S";

double ki, kp, kd;

void AML_Remote_Setup(void)
{
    HAL_UART_Receive_IT(&huart6, &RemoteBuffer, 1);
}

void AML_Remote_Handle()
{
    if (RemoteBuffer != 0)
    {
        RemoteData[RemoteIndex++] = RemoteBuffer;
    }
    else if (RemoteBuffer == 0)
    {

        sscanf((char *)RemoteData, "%lf %lf %lf\0", &kp, &ki, &kd);
        // AML_MotorControl_PIDSetTunnings(kp, ki, kd);

        RemoteIndex = 0;
        memset(RemoteData, 0, sizeof(RemoteData));
    }
    HAL_UART_Receive_IT(&huart6, &RemoteBuffer, 1);
}

void AMl_Remote_NumberToString(uint8_t *string, int32_t number)
{
    uint8_t temp[10];
    uint8_t i = 0;
    uint8_t j = 0;
    uint8_t k = 0;

    if (number < 0)
    {
        string[0] = '-';
        number = -number;
        i++;
    }

    while (number > 0)
    {
        temp[i++] = number % 10 + '0';
        number /= 10;
    }

    for (j = i; j > 0; j--)
    {
        string[k++] = temp[j - 1];
    }
}
