anmh1205/AML_MicroMouse_2024/1. MicroMouse Code/3. Test (code C)/MMS/main.c

#include <stdio.h>
#include "solver.h"
// #include "flood.h"

#include "API.h"

#define SIMULATION_BOOL 1 // 1 if you're running the simulation, 0 if you're running the actual robot

#define CHECK_WALL_FRONT API_wallFront()
#define CHECK_WALL_LEFT API_wallLeft()
#define CHECK_WALL_RIGHT API_wallRight()

#define MOVE_FORWARD_FUNCTION API_moveForward()
#define TURN_LEFT_FUNCTION API_turnLeft()
#define TURN_RIGHT_FUNCTION API_turnRight()

#define debug(x) NULL

int main(int argc, char *argv[])
{
    // set the priority heading
    setPriorityHeading(EAST);

    // initialize the maze
    initialize();

    // start the search
    searchRun();

    // reached the center, now calculate the shortest path
    markCenterWall();
    calculateShortestPathDistances();

    // use hand to move the mouse to the start position, and find the shortest path
    API_ackReset();
    setPosition(0, 0, NORTH);

    // run the shortest path
    fastRunWithVariableVelocity();

    while (1)
    {
        // run from the center to the start
        searchCenterToStart();

        // calculate the shortest path again
        calculateShortestPathDistances();

        // run the shortest path
        fastRunWithVariableVelocity();
    }
}
