anmh1205/AML_MicroMouse_2024/1. MicroMouse Code/3. Test (code C)/MMS/API.c

#include <stdio.h>
#include <stdlib.h>
#include <string.h>

#define BUFFER_SIZE 32

int getInteger(char *command)
{
    printf("%s\n", command);
    fflush(stdout);
    char response[BUFFER_SIZE];
    fgets(response, BUFFER_SIZE, stdin);
    int value = atoi(response);
    return value;
}

int getBoolean(char *command)
{
    printf("%s\n", command);
    fflush(stdout);
    char response[BUFFER_SIZE];
    fgets(response, BUFFER_SIZE, stdin);
    int value = (strcmp(response, "true\n") == 0);
    return value;
}

int getAck(char *command)
{
    printf("%s\n", command);
    fflush(stdout);
    char response[BUFFER_SIZE];
    fgets(response, BUFFER_SIZE, stdin);
    int success = (strcmp(response, "ack\n") == 0);
    return success;
}

int API_mazeWidth()
{
    return getInteger("mazeWidth");
}

int API_mazeHeight()
{
    return getInteger("mazeHeight");
}

int API_wallFront()
{
    return getBoolean("wallFront");
}

int API_wallRight()
{
    return getBoolean("wallRight");
}

int API_wallLeft()
{
    return getBoolean("wallLeft");
}

int API_moveForward()
{
    return getAck("moveForward");
}

void API_turnRight()
{
    getAck("turnRight");
}

void API_turnLeft()
{
    getAck("turnLeft");
}

void API_setWall(int x, int y, char direction)
{
    printf("setWall %d %d %c\n", x, y, direction);
    fflush(stdout);
}

void API_clearWall(int x, int y, char direction)
{
    printf("clearWall %d %d %c\n", x, y, direction);
    fflush(stdout);
}

void API_setColor(int x, int y, char color)
{
    printf("setColor %d %d %c\n", x, y, color);
    fflush(stdout);
}

void API_clearColor(int x, int y)
{
    printf("clearColor %d %d\n", x, y);
    fflush(stdout);
}

void API_clearAllColor()
{
    printf("clearAllColor\n");
    fflush(stdout);
}

void API_setText(int x, int y, int val)
{
    printf("setText %d %d %d\n", x, y, val);
    fflush(stdout);
}

void API_clearText(int x, int y)
{
    printf("clearText %d %d\n", x, y);
    fflush(stdout);
}

void API_clearAllText()
{
    printf("clearAllText\n");
    fflush(stdout);
}

int API_wasReset()
{
    return getBoolean("wasReset");
}

void API_ackReset()
{
    getAck("ackReset");
}

void debug_log(char *text)
{
    fprintf(stderr, "%s\n", text);
    fflush(stderr);
}

void debug_int(int num)
{
    fprintf(stderr, "%d\n", num);
    fflush(stderr);
}

void debug_coord(int x, int y)
{
    fprintf(stderr, "(%d, %d)\n", x, y);
    fflush(stderr);
}
