anmh1205/AML_MicroMouse_2024/(commit log)

2024-08-12 update PCB 12/08/2024
    [PCB_T2.dsn, PCB_T2.kicad_pcb, PCB_T2.kicad_sch, PCB_T2_kicad.dsn]
2024-08-13 update route tracks before change
    [PCB_T2.kicad_pcb, PCB_T2.kicad_sch]
2024-08-13 completed schematic of all in one PCB
    [AIO.DXF, PCB_AIO_V1.dsn, PCB_AIO_V1.kicad_pcb, PCB_AIO_V1.kicad_sch, PCB_AIO_V1_2.dsn, PCB_T2.kicad_pcb, PCB_T2.kicad_sch, PCB_T2_fr.dsn]
2024-08-16 completed PCB_AIO_V1
    [BM03B-SRSS-TB-white.STEP, BM04B-SRSS-TB-white.SLDPRT, BM04B-SRSS-TB-white.STEP, CUI_DEVICES_CMT-8504-100-SMT-TR.step, CUI_DEVICES_CMT-9504-87-SMT-TR.step, MINI560_light.step, PCB_AIO_V1.kicad_pcb, PCB_AIO_V1.kicad_sch]
2024-08-29 finish PCB_AIO_V1
    [PCB_AIO_V1.kicad_pcb, PCB_AIO_V1.kicad_sch, base1.DXF, base1.SLDPRT, base2.DXF, base2.SLDPRT, base3.DXF, base3.SLDPRT]
2024-09-05 update before create dev branch
    [MicroMouse2024_Roadmap.xlsx, PCB_AIO_V1.kicad_pcb]
2024-09-05 moved stm32h743vit6
    [PCB_AIO_V1.kicad_pcb]
2024-09-08 completed schematic of PCB_AIO_V2
    [JST - XH - Thru (R) - 10Pin - 2.54mm.stp, JST - XH - Thru (R) - 11Pin - 2.54mm.stp, JST - XH - Thru (R) - 12Pin - 2.54mm.stp, JST - XH - Thru (R) - 13Pin - 2.54mm.stp, JST - XH - Thru (R) - 14Pin - 2.54mm.stp, JST - XH - Thru (R) - 15Pin - 2.54mm.stp, JST - XH - Thru (R) - 16Pin - 2.54mm.stp, JST - XH - Thru (R) - 17Pin - 2.54mm.stp]
2024-09-12 completed PCB_AIO_V2
    [Assem1.SLDASM, BM03B-SRSS-TB-white.STEP, BM04B-SRSS-TB-white.SLDPRT, BM04B-SRSS-TB-white.STEP, BM06B-SRSS-TB.STEP, CUI_DEVICES_CMT-8504-100-SMT-TR.step, CUI_DEVICES_CMT-9504-87-SMT-TR.step, GP2Y0A41SK0F.SLDPRT]
2024-09-12 updated logo AML
    [PCB_AIO_V2.kicad_pcb]
2024-09-13 SH 1.0 4P -> XH 2.54 4P
    [JST - XH - Thru (V) - 4Pin - 2.54mm.stp, JST - XH - Thru (V) - 9Pin - 2.54mm.stp, PCB3.DXF, PCB_AIO_V2.kicad_pcb, PCB_AIO_V2.kicad_sch, bom.csv, designators.csv, positions.csv]
2024-10-23 completed PCB_AIO_V2 pin config
    [PCB_AIO_V2.kicad_pcb, PCB_Outline.DXF, bom.csv, mpu6050.STEP, positions.csv]
2024-10-30 - tested Buzzer - tested Led - tested MPU
    [AML_Buzzer.c, AML_Buzzer.h, AML_LedDebug.c, AML_LedDebug.h, AML_MPUSensor.c, AML_MPUSensor.h, AML_PID.h, PCB_AIO_V2_CODE.ioc]
2024-10-31 - tested encoder, TB6612FNG, bit switch, button, MPU, buzzer, led, ST-link - completed AML_PID lib - completed base of AML_MotorControl lib
    [AML_Encoder.c, AML_Encoder.h, AML_GlobalVariable.h, AML_MotorControl.c, AML_MotorControl.h, AML_Switch.c, AML_Switch.h, PCB_AIO_V2_CODE.ioc]
2024-11-05 - fix bug in AML_PID (not init limMin, limMax) - read 2_15 IR sensor function
    [Calib_IR_Sensor.xlsx]
2024-11-27 updated AML_MPUSensor --> AML_IMU
    [Assem1.SLDASM, Cum Banh 1.SLDPRT, Cum Banh 1.STL, Cum Banh 2.SLDPRT, Cum Banh 2.STL, CumBanh1.SLDASM, CumBanh2.SLDASM, CumCamBien.SLDASM]
2024-11-29 - fixed some bug in AML_PID - removed AML_PID_Init - changed AML_PID_Struct variable
    [AML_MotorControl.c, AML_MotorControl.h, AML_PID.h, main.c]
2024-12-05 completed flood fill algorithm (in MMS folder) - calculate first shortest path - calculate path for variable velocity
    [API.c, API.h, flood.c, flood.h, main.c, queue.c, queue.h, solver.c]
2024-12-14 - added setPriorityHeading (MMS) - removed warning (PCB_AIO_V2)
    [CumBanh1.SLDASM, CumBanh2.SLDASM, CumCamBien.SLDASM]
2024-12-15 - changed heading macro (MMS) - changed MouseSpeed (new motor)
