anmh1205/AML_MicroMouse_2024/(notices)

Notices in the files:
1. MicroMouse Code/2. MicroMouse - STM32F407VGT6/PCB_AIO_V2_CODE/Core/Src/main.c:
Copyright (c) 2024 STMicroelectronics.
All rights reserved.
1. MicroMouse Code/2. MicroMouse - STM32F407VGT6/PCB_V1/Core/Src/main.c:
Copyright (c) 2023 STMicroelectronics.
0. Example/Wireless DAP/wireless-esp8266-dap-master/README_CN.md:
License: MIT
